abettarini/workbench/archivio/quadrotti-8x8/tavolo_tavole.pdf

Vista d'insieme | Tavolo da lavoro 2000×800 – tav. 1

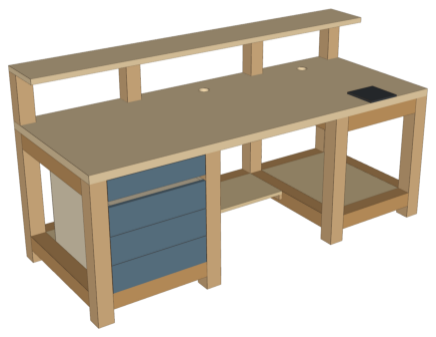
[picture p2: figure]

Quote in mm. Quadrotti abete 8×8 – verificare la sezione reale del piallato e rigenerare il modello se diversa.

Piano a 740 mm da terra (seduto, statura 174 cm) – lamellare abete 40 mm

8 gambe 8×8 – campate nette: cassetti 500 (sx) · seduta 700 · ricarica 480 (dx)

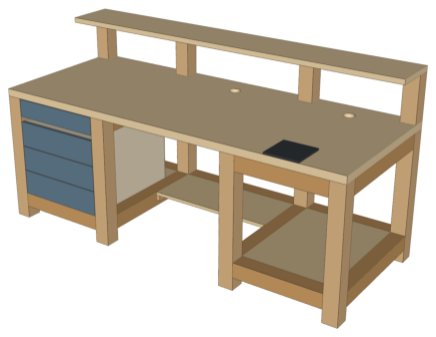
[picture p3: figure]

Ripiani bassi: cassetti e ricarica a tutta profondità, seduta solo posteriore (300 mm) per lasciare spazio ai piedi

Mensola rialzata 260×27 a +250 mm sul piano, montanti allineati alle gambe posteriori (barra filettata passante)
Zona ricarica: base per piastre intercambiabili (Rock Chucker / Dillon 550 / morsa) sul bordo anteriore, piano raddoppiato (+40 mm) e contropiastra in acciaio

Canaline passacavi sotto il bordo posteriore in ogni campata, fori Ø35 nelle traverse per il passaggio cavi, ciabatta nella campata seduta

Tavolo da fissare a muro (angolari su montanti mensola e traversa posteriore)

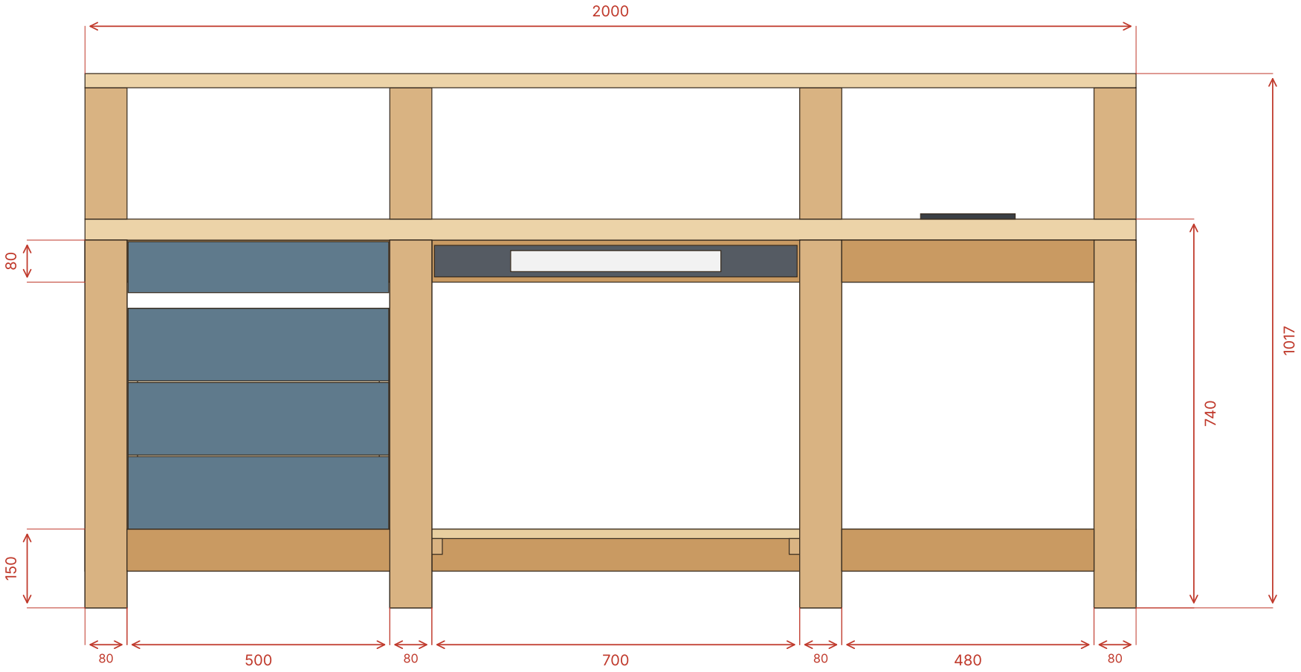
[picture p4: figure]

CASSETTI | SEDUTA | RICARICA
Prospetto frontale | Tavolo da lavoro 2000×800 – tav. 2

Pianta zona ricarica (dall'alto, fronte in alto)

Vista laterale da destra · pianta zona ricarica | Tavolo da lavoro 2000×800 – tav. 3

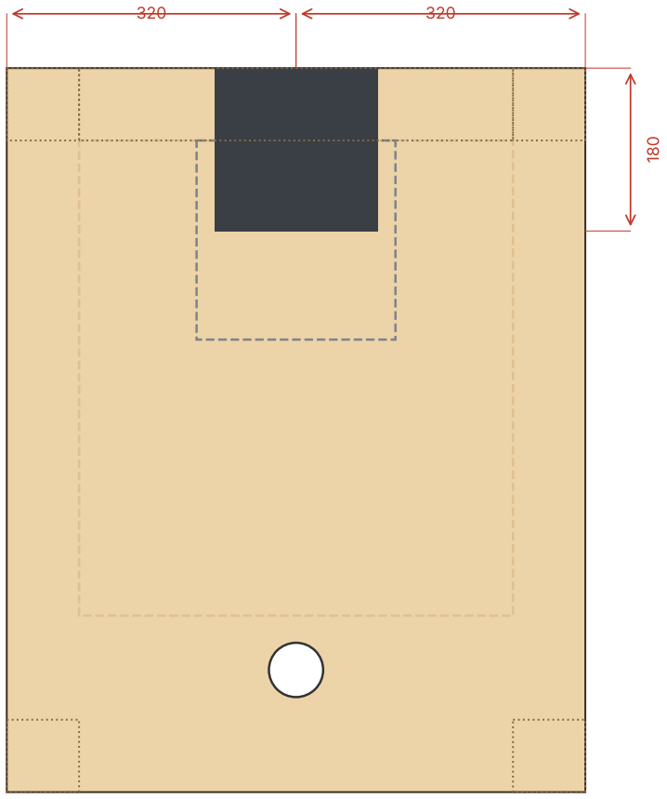
[picture p5: figure]

Pieno: base attacco piastre (sul piano, a filo del bordo anteriore)

Tratteggio: rinforzo 40 mm e contropiastra acciaio (sotto il piano)

Puntinato: gambe e traversa superiore anteriore (sotto il piano)

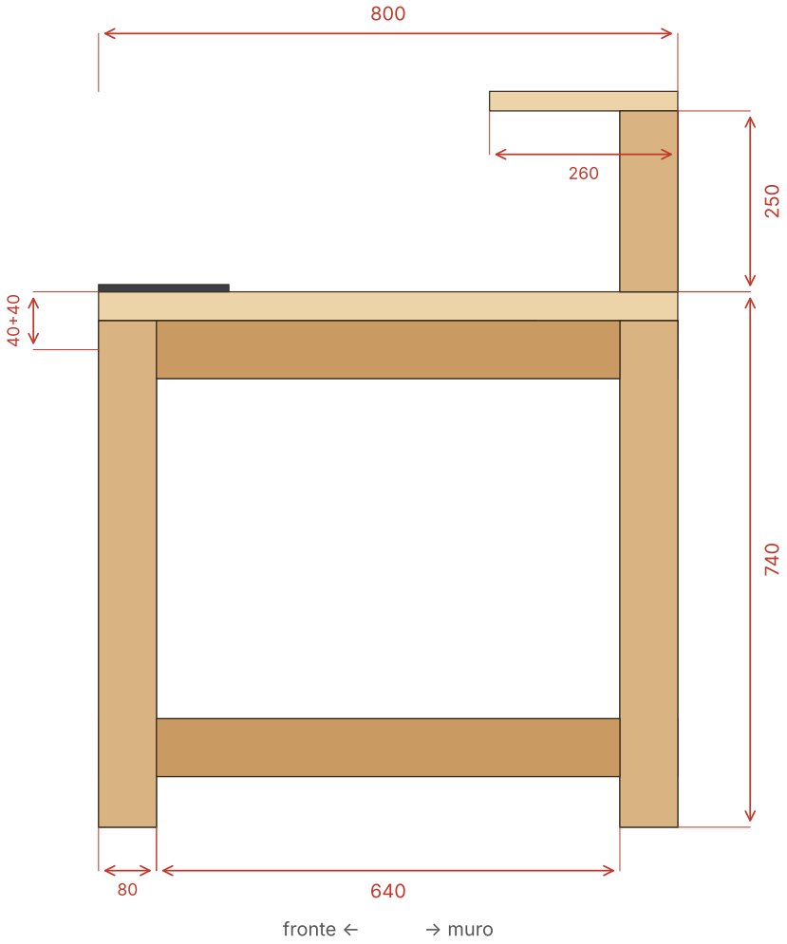
[picture p6: figure]
fronte ←; → muro

Pezzo | Lungh. | Q.tà | Tot. mm
Gamba | 700 | 8 | 5600
Traversa longitudinale | 700 | 2 | 1400
Traversa laterale (profondità) | 640 | 8 | 5120
Traversa longitudinale | 500 | 3 | 1500
Traversa longitudinale | 480 | 4 | 1920
Montante mensola | 250 | 4 | 1000
TOTALE | | 29 | 16540

### Ottimizzazione barre (taglio 5 mm incl. squadratura)

### Barre da 2 m: 9 pz (sfrido 1.46 m)

1: 700 + 700 + 500
2: 700 + 700 + 500
3: 700 + 700 + 500
4: 700 + 700 + 480
5: 700 + 700 + 480
6: 640 + 640 + 640
7: 640 + 640 + 640
8: 640 + 640 + 480
9: 480 + 250 + 250 + 250 + 250

### Barre da 3 m: 6 pz (sfrido 1.46 m)

1: 700 + 700 + 700 + 700
2: 700 + 700 + 700 + 700
3: 700 + 700 + 640 + 640 + 250
4: 640 + 640 + 640 + 640 + 250
5: 640 + 640 + 500 + 500 + 500
6: 480 + 480 + 480 + 480 + 250 + 250

### Barre da 4 m: 5 pz (sfrido 3.46 m)

1: 700 + 700 + 700 + 700 + 700 + 250
2: 700 + 700 + 700 + 700 + 700 + 250
3: 640 + 640 + 640 + 640 + 640 + 640
4: 640 + 640 + 500 + 500 + 500 + 480 + 480 5: 480 + 480 + 250 + 250
Distinta di taglio – quadrotti abete 8×8 | Tavolo da lavoro 2000×800 – tav. 4

Note
- Gambe: tutte uguali, piano appoggiato in testa. Traverse tra le gambe (luce netta = lunghezza).
- Ogni giunzione: 1 bullone M10 passante nella gamba + dado a tamburo nella traversa + 2 spine Ø10.

Dove due traverse entrano nella stessa gamba alla stessa quota, sfalsare i bulloni di ±18 mm in altezza.
- Traverse superiori laterali interne: foro Ø35 per il passaggio dei cavi lungo le canaline.
- Montanti mensola: foro passante Ø11 in asse per la barra filettata che scende nella gamba posteriore.

Pezzo | Materiale | Dimensioni (L×l) | Sp. | Q.tà
Cassetto cassettiera: fondo | HDF 4 | 500×435 | 4 | 3
Cassetto appeso: fondo | HDF 4 | 500×475 | 4 | 1
Cassettiera schienale | HDF 4 | 496×420 | 4 | 1
Listello reggiripiano | abete 20x30 | 640×30 | 20 | 4
Listello reggiripiano | abete 20x30 | 300×30 | 20 | 2
Mensola rialzata | lamellare abete 27 | 2000×260 | 27 | 1
Piano di lavoro | lamellare abete 40 | 2000×800 | 40 | 1
Rinforzo piano ricarica | lamellare abete 40 | 525×480 | 40 | 1
Cassetto cassettiera: fianco | multistrato 15 | 500×100 | 15 | 6
Cassetto appeso: fianco | multistrato 15 | 500×70 | 15 | 2
Cassetto appeso: testata | multistrato 15 | 445×70 | 15 | 2
Cassetto cassettiera: testata | multistrato 15 | 405×100 | 15 | 6
Ripiano basso post. seduta | multistrato 18 | 700×300 | 18 | 1
Ripiano basso cassetti | multistrato 18 | 640×500 | 18 | 1
Ripiano basso ricarica | multistrato 18 | 640×480 | 18 | 1
Cassettiera fianco sx | multistrato 18 | 582×420 | 18 | 1
Cassettiera fianco dx | multistrato 18 | 582×420 | 18 | 1
Cassettiera cielo | multistrato 18 | 582×460 | 18 | 1
Cassettiera fondo | multistrato 18 | 582×460 | 18 | 1
Frontale cassetto | multistrato 18 | 496×138 | 18 | 3
Frontale cassetto appeso | multistrato 18 | 496×97 | 18 | 1
Distinta pannelli e listelli | Tavolo da lavoro 2000×800 – tav. 5

Articolo | Q.tà | Uso
Bulloni M10×150 TE/TCEI + rondella + dado a tamburo M10 | 34 | giunzioni traverse-gambe (1 per estremità)
Spine in faggio Ø10×40 | 68 | 2 per giunzione, antirotazione (con colla)
Barra filettata M10, L≈417 mm + dado a tamburo + dado cieco + rondella | 4 | mensola → montante → piano → gamba posteriore
Inserti filettati M10 + piedini livellatori M10 | 8 | base gambe, compensano il pavimento
Squadrette/piastrine fissaggio piano + viti 4,5×30 | 16 | piano su traverse superiori
Viti 5×70 + colla vinilica D3 | 12 | rinforzo zona ricarica incollato e avvitato sotto il piano
Viti 4×50 | 24 | listelli reggiripiano
Contropiastra acciaio 220×220×6 (S235) | 1 | sotto il rinforzo, forata come la base attacco
Bulloni M10×120 TCEI + rondelle larghe + dadi autobloccanti | 4 | base attacco piastre (numero/foratura secondo il sistema)
Angolari rinforzati a L 100×100 + tasselli Ø10 adatti al muro | 4 | 2 su montanti mensola, 2 su traversa sup. posteriore
Guide a sfera estrazione totale L=500 (≥45 kg) | 4 | coppie: 3 cassettiera + 1 cassetto appeso
Maniglie / pomoli | 4
Passacavi Ø60 da incasso | 2 | piano, sopra le canaline
Canalina passacavi sottoscrivania (tagliata a misura) | 3 | 490 / 690 / 470 mm
Ciabatta con interruttore | 1 | nella canalina della campata seduta
Ferramenta e note zona ricarica | Tavolo da lavoro 2000×800 – tav. 6

Zona ricarica
- La base delle piastre va a filo del bordo anteriore, sopra la traversa superiore anteriore: la leva delle presse scende davanti al piano.
- Pacchetto serrato dai bulloni: base acciaio + piano 40 + rinforzo 40 + contropiastra 6 mm. Rinforzo incollato e avvitato al piano prima di forare.
- Foratura e dimensioni della base vanno adattate al sistema di piastre che usi già: nel modello è un segnaposto 180×180×10 mm.
- Uso da seduto a 74 cm: Rock Chucker e Dillon 550 direttamente sulla piastra, senza rialzo.
- Fissaggio a muro obbligatorio: le presse tendono a far ribaltare e 'camminare' il tavolo. Il ripiano basso della campata ricarica (componenti, piombo) fa anche da zavorra.
