abettarini/workbench/moduli/1-tavolo-base/tavolo_base_tavole.pdf

Vista d'insieme | Tavolo da lavoro 2000×800 – travi KVH 80×120 – tav. 1

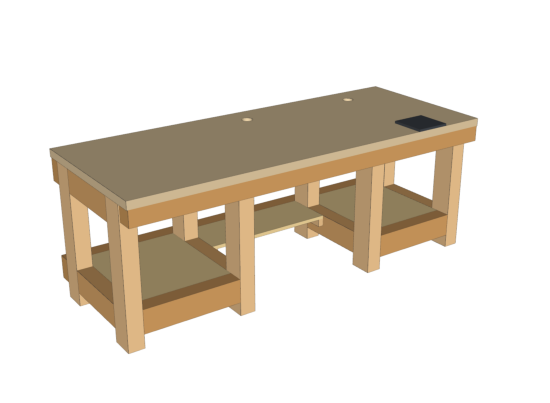
[picture p7: figure]

Quote in mm. KVH 80×120 abete C24 giuntato, piallato. Costi nel file tavolo_base_costi.xlsx.

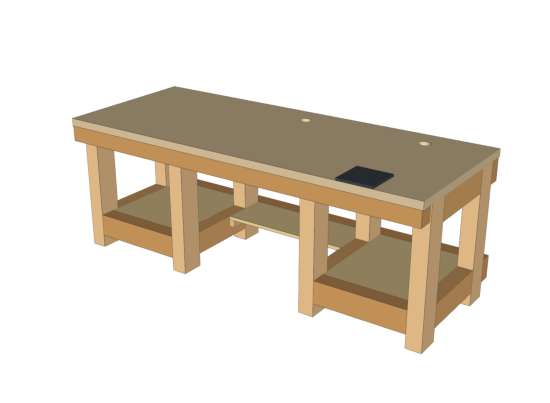
[picture p8: figure]

Telaio in travi KVH 80×120: 4 telai laterali (gamba ant. + gamba post. + traverse laterali alta e bassa) uniti da 3 fasce da 1990 Fasce: 2 posteriori di coltello (alta e bassa, contro il muro) e 1 anteriore alta in morale di abete 80×80 (620 mm liberi sotto)

Piano a 740 mm (seduto) – tavola lamellare abete 2000×800×40 intera · campate nette: cassetti 500 · seduta 700 · ricarica 480

Telai: bullone M10 + dado a tamburo + 2 spine Ø12 · fasce: 2 viti strutturali 8×160 per gamba, perpendicolari · ripiani e rinforzo in OSB/3 18

Telaio da 4 barre KVH da 4 m (24 pezzi, montanti dell'alzatina compresi). Fissaggio a muro obbligatorio per l'uso delle presse

Moduli separati: cassettiera (modulo 2) e alzatina con mensola (modulo 3), con i propri manuali e costi

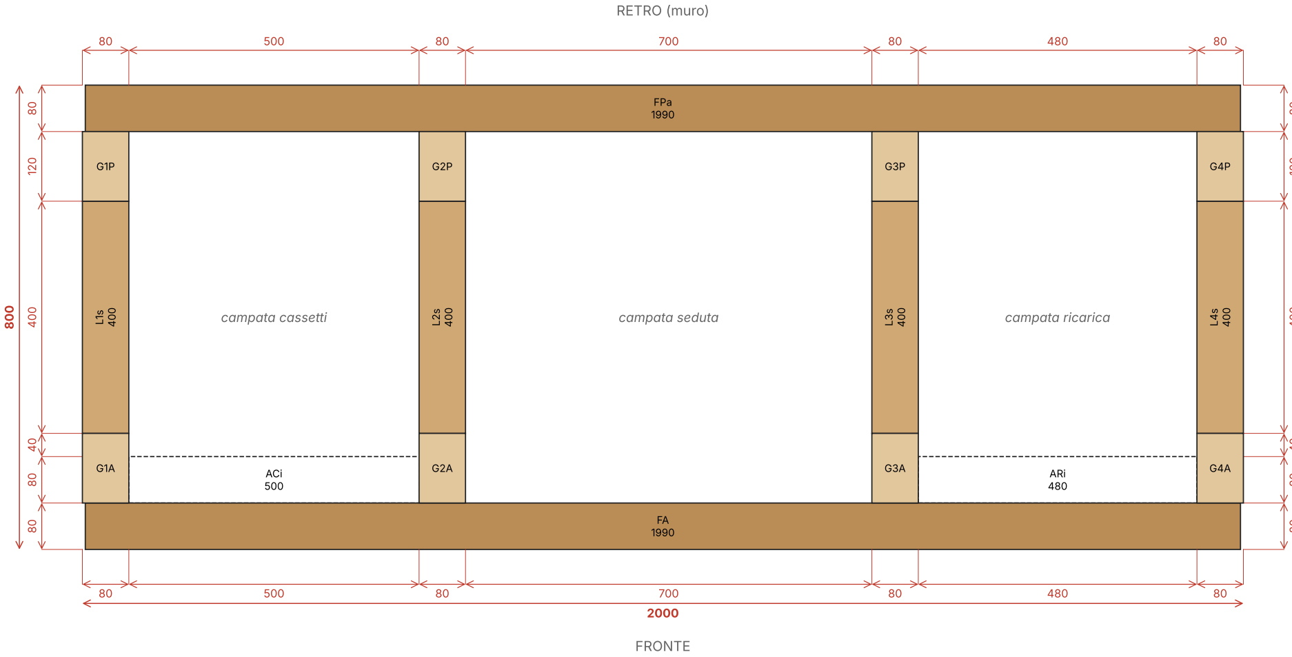
[picture p9: figure]
ACi 500; ARi 480; FPa 1990; FRONTE; RETRO (muro)

80 80 40 400 120 80

campata cassetti | campata seduta | campata ricarica
Pianta del telaio quotata (senza piano) | Tavolo da lavoro 2000×800 – travi KVH 80×120 – tav. 2

Pezzi alti pieni, pezzi solo bassi (ACi, ARi) tratteggiati. FA = fascia anteriore (morale 80×80), FPa/FPb = fasce posteriori alta e bassa (sovrapposte in pianta). Codice e lunghezza su ogni pezzo.

Prospetto anteriore quotato | Tavolo da lavoro 2000×800 – travi KVH 80×120 – tav. 3

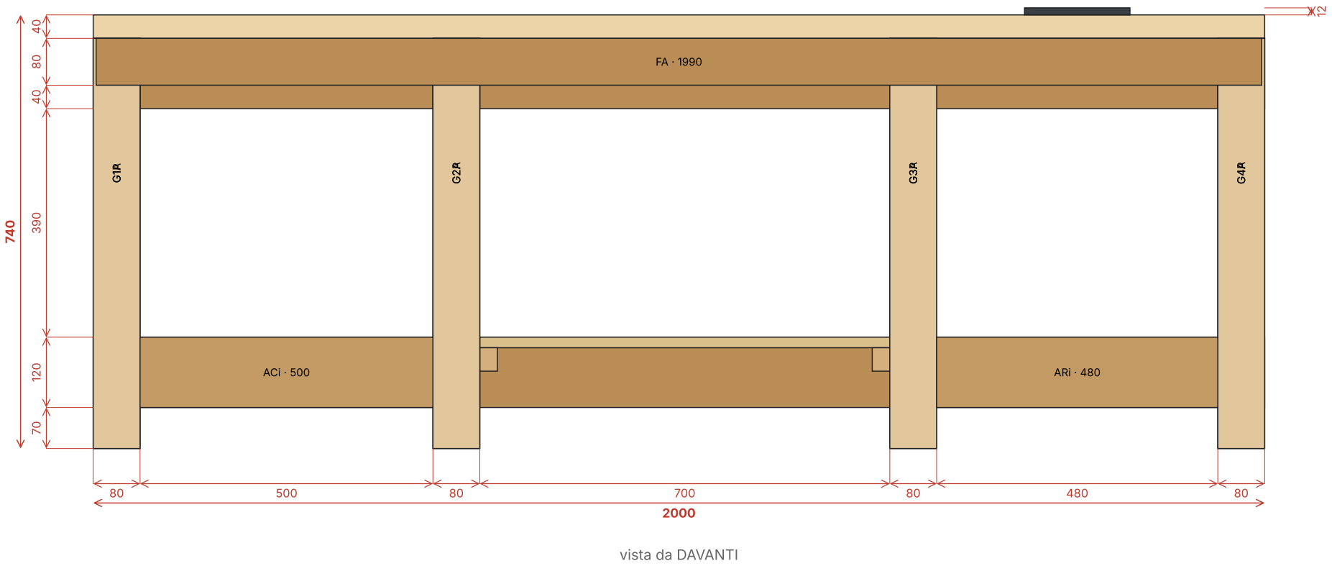
[picture p10: figure]
ACi · 500; ARi · 480; vista da DAVANTI

Prospetto posteriore quotato | Tavolo da lavoro 2000×800 – travi KVH 80×120 – tav. 4

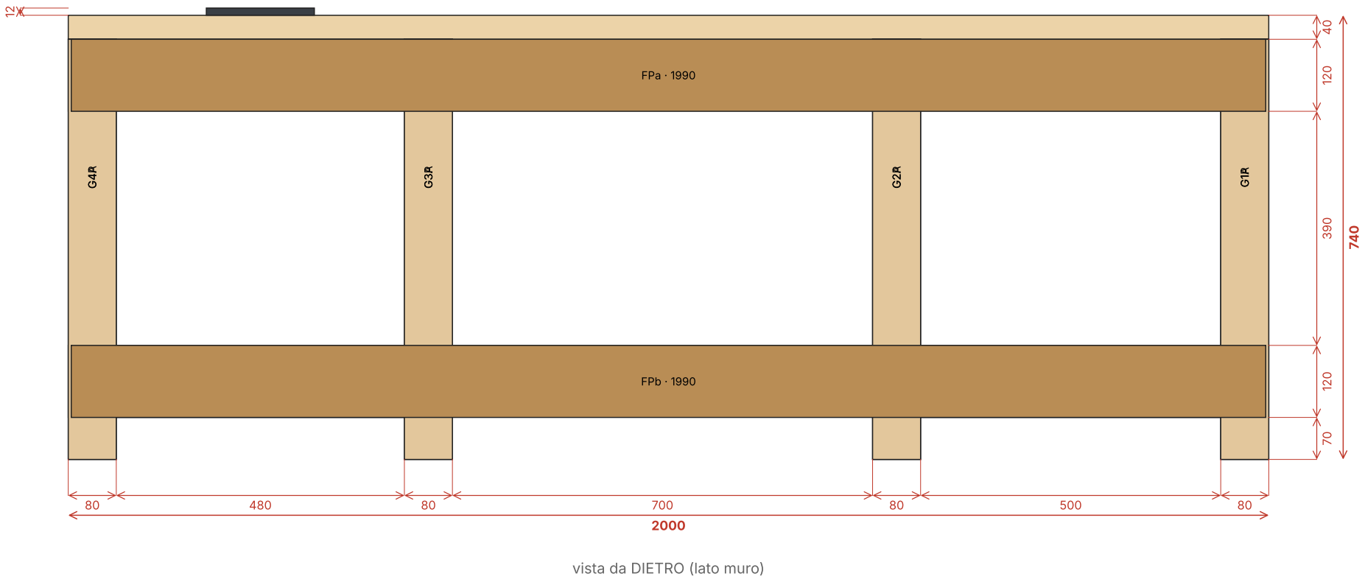
[picture p11: figure]
FPa · 1990; FPb · 1990; vista da DIETRO (lato muro)

Fianchi quotati | Tavolo da lavoro 2000×800 – travi KVH 80×120 – tav. 5

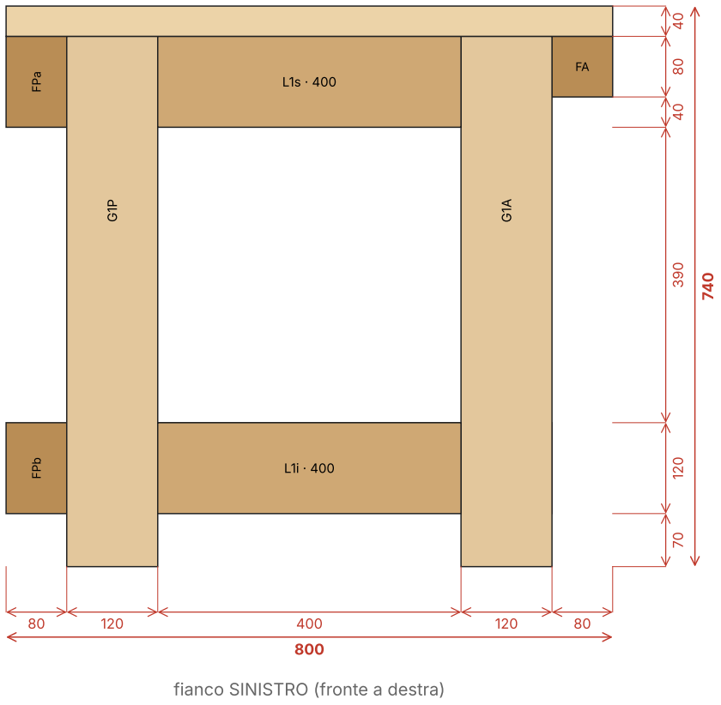
[picture p12: figure]
FPa FPb; fianco SINISTRO (fronte a destra)
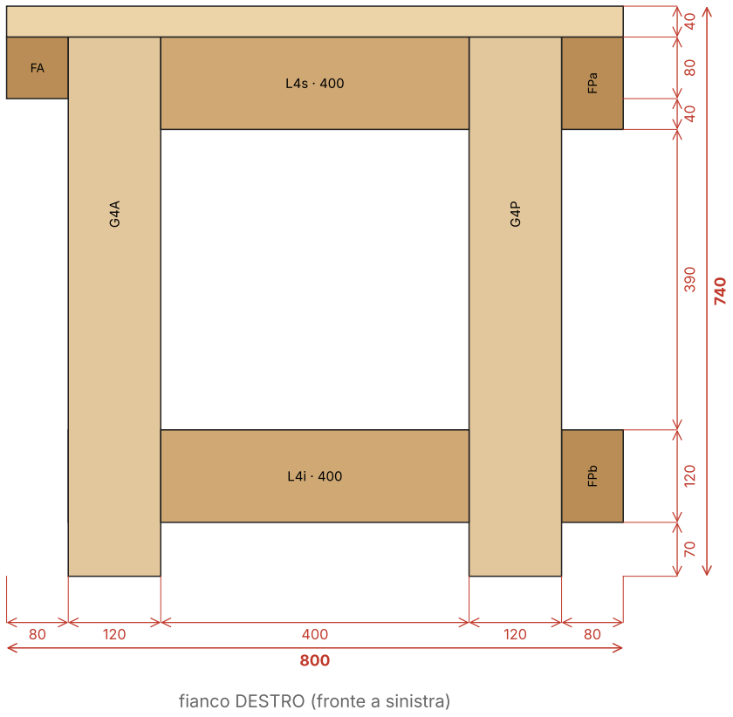
[picture p13: figure]
FPa FPb; fianco DESTRO (fronte a sinistra)
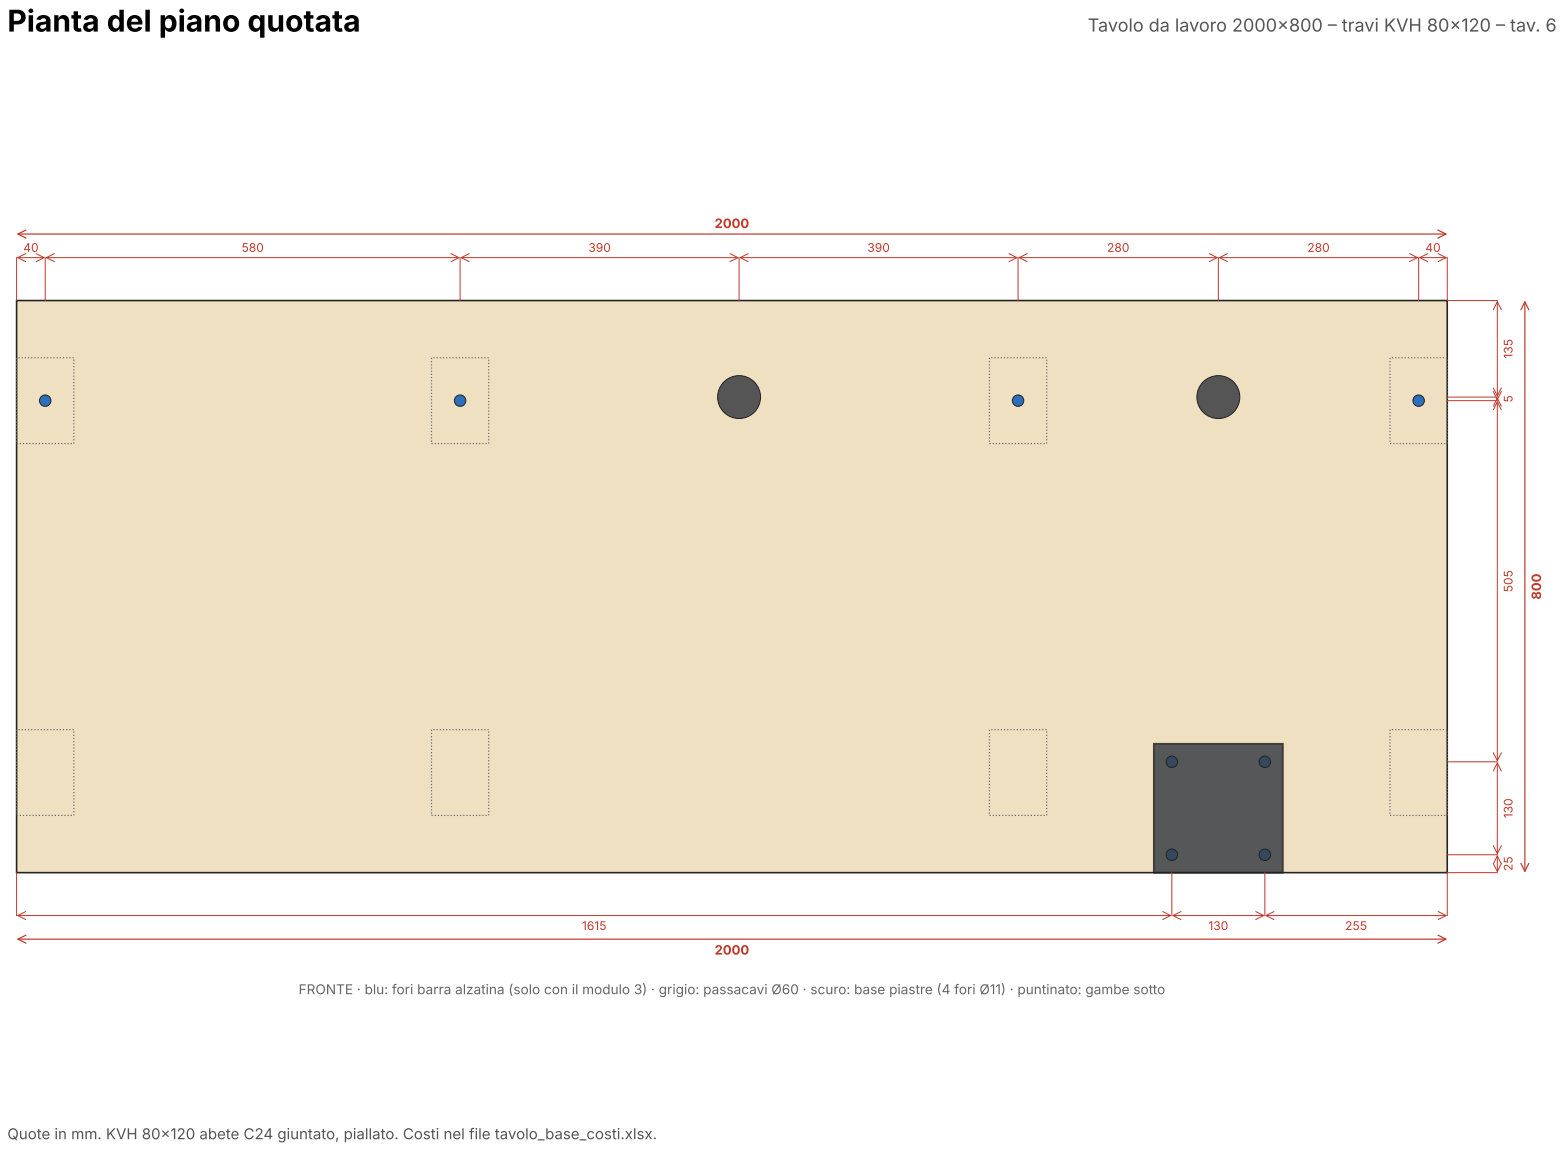
[picture p14: page 6]
Pianta del piano quotata; Tavolo da lavoro 2000×800 – travi KVH 80×120 – tav. 6

FRONTE · blu: fori barra alzatina (solo con il modulo 3) · grigio: passacavi Ø60 · scuro: base piastre (4 fori Ø11) · puntinato: gambe sotto

60 | 280 | 60
| 400

25 15 15 25

vista dall'alto (faccia sinistra in basso)

Laterale 400 mm – 6 pz: L1s, L1i, L2i, L3i, L4s, L4i

60 | 140 | 140 | 60

400

25 15 15 25

vista dall'alto (faccia sinistra in basso)

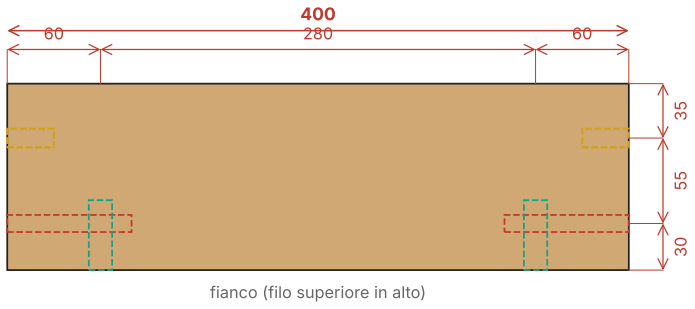
[picture p15: figure]
fianco (filo superiore in alto)

Laterale 400 mm – 2 pz: L2s, L3s

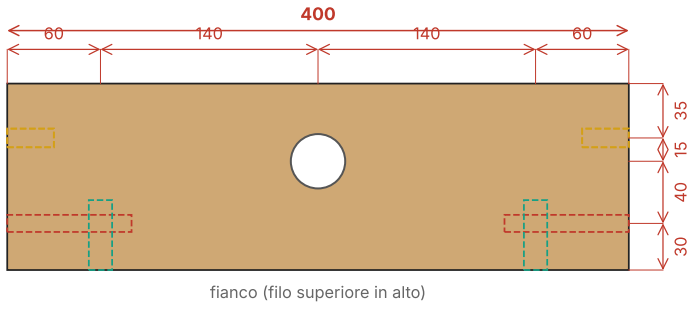
[picture p16: figure]
fianco (filo superiore in alto)

Bassa anteriore 500 mm – 1 pz: ACi

Traverse quotate: lunghezze e fori | Tavolo da lavoro 2000×800 – travi KVH 80×120 – tav. 7

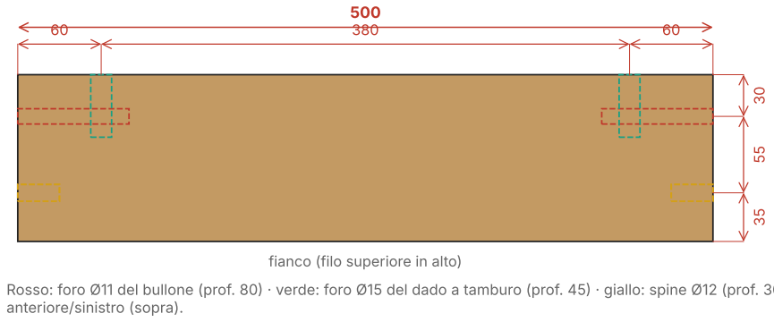
[picture p17: figure]
fianco (filo superiore in alto); anteriore/sinistro (sopra).
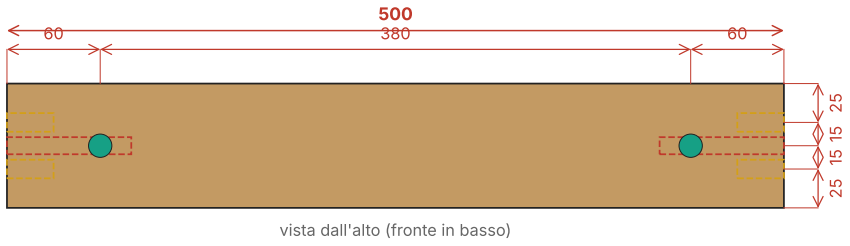
[picture p18: figure]
vista dall'alto (fronte in basso)

Rosso: foro Ø11 del bullone (prof. 80) · verde: foro Ø15 del dado a tamburo (prof. 45) · giallo: spine Ø12 (prof. 30) · grigio: passacavi Ø35 · blu scuro: fori Ø11 verticali della base piastre. Quote in mm dalla testata sinistra, dal basso (fianco) e dal lato

Bassa anteriore 480 mm – 1 pz: ARi

Traverse quotate: lunghezze e fori | Tavolo da lavoro 2000×800 – travi KVH 80×120 – tav. 8

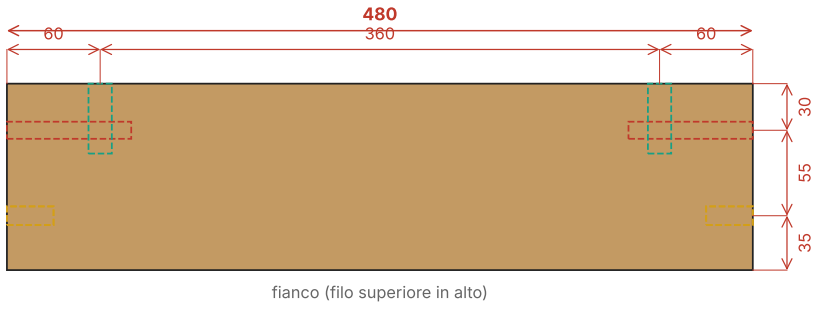
[picture p19: figure]
fianco (filo superiore in alto)
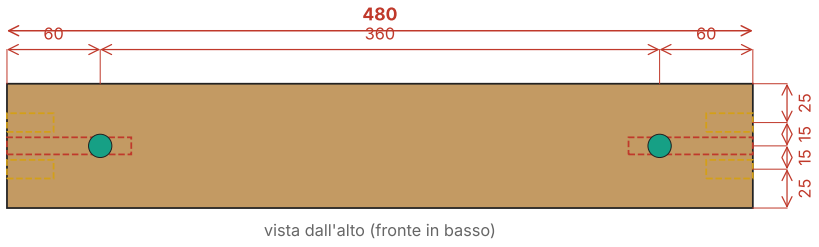
[picture p20: figure]
vista dall'alto (fronte in basso)

Rosso: foro Ø11 del bullone (prof. 80) · verde: foro Ø15 del dado a tamburo (prof. 45) · giallo: spine Ø12 (prof. 30) · grigio: passacavi Ø35 · blu scuro: fori Ø11 verticali della base piastre. Quote in mm dalla testata sinistra, dal basso (fianco) e dal lato anteriore/sinistro (sopra).

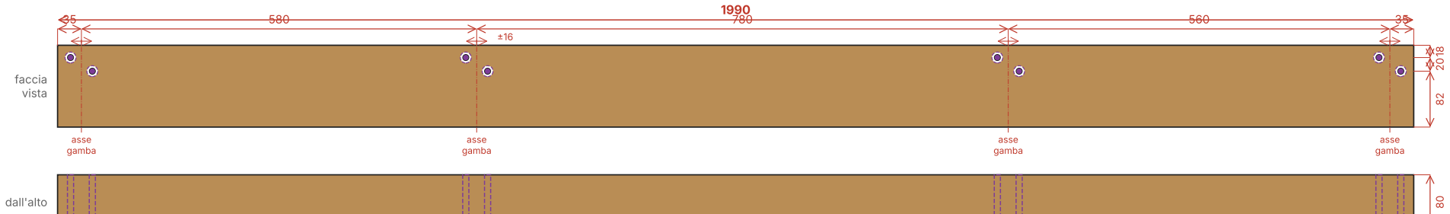
[picture p21: figure]
asse gamba; faccia vista; dall'alto

muro in alto · 1990 × 80 × 120

FPa · fascia posteriore alta – di coltello, 80 × 120

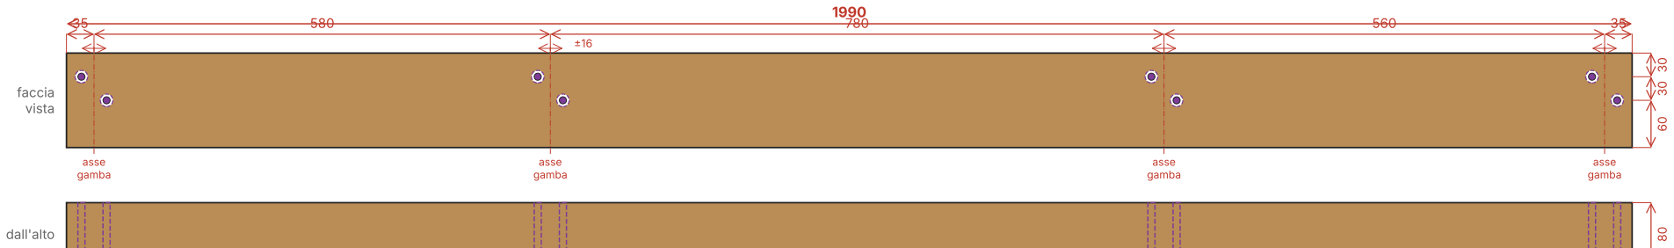
[picture p22: figure]
asse gamba; faccia vista; dall'alto

muro in alto · 1990 × 80 × 120

FPb · fascia posteriore bassa – di coltello, 80 × 120

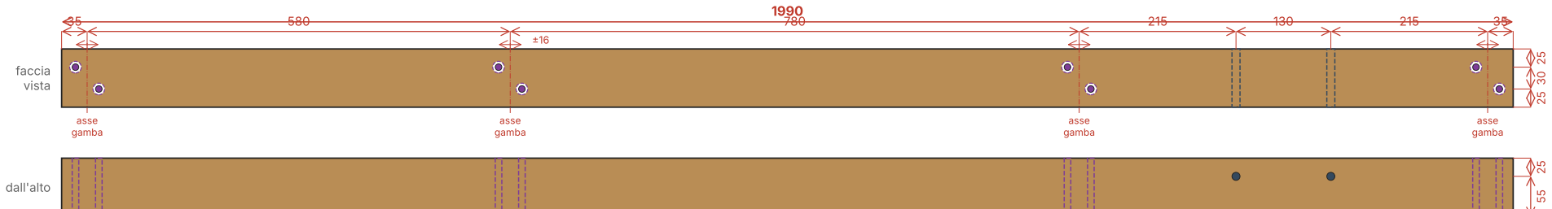
[picture p23: figure]
asse gamba; faccia vista; dall'alto

fronte in basso · 1990 × 80 × 80

FA · fascia anteriore – morale di abete 80 × 80

Fasce a tutta lunghezza: misure e fori | Tavolo da lavoro 2000×800 – travi KVH 80×120 – tav. 9

Viola: fori Ø9 passanti per le viti 8×160, con svasatura per la testa · blu scuro: 2 fori Ø11 verticali della base piastre (fase 8). In ogni asse gamba 2 fori a ±16 mm dall'asse, alle quote dal basso indicate a destra. Quote sempre dalla testata lato G1 (sinistra guardando il tavolo dal fronte): sulle fasce posteriori, che si forano dal lato muro, segna le quote dalla stessa testata.

Vista laterale da destra · dettaglio nodo gamba–traversa–fascia | Tavolo da lavoro 2000×800 – travi KVH 80×120 – tav. 10

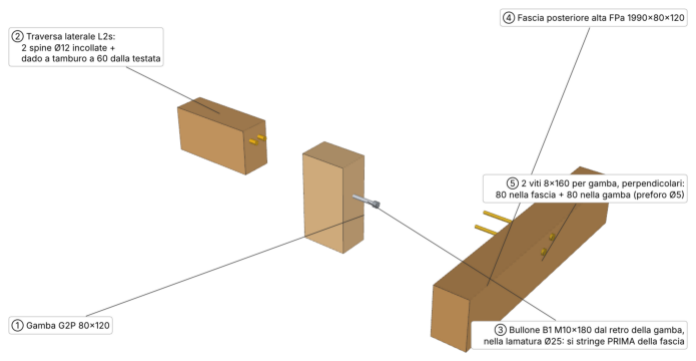
[picture p24: figure]

Telai: Ø11 passante nella gamba, Ø11 in asse nella testata della traversa (prof. 80), Ø15 per il dado a tamburo a 60 mm

dalla testata. Fasce: Ø9 passante nella fascia, preforo Ø5 prof. 80 nella gamba. Schemi di ogni pezzo nel manuale.

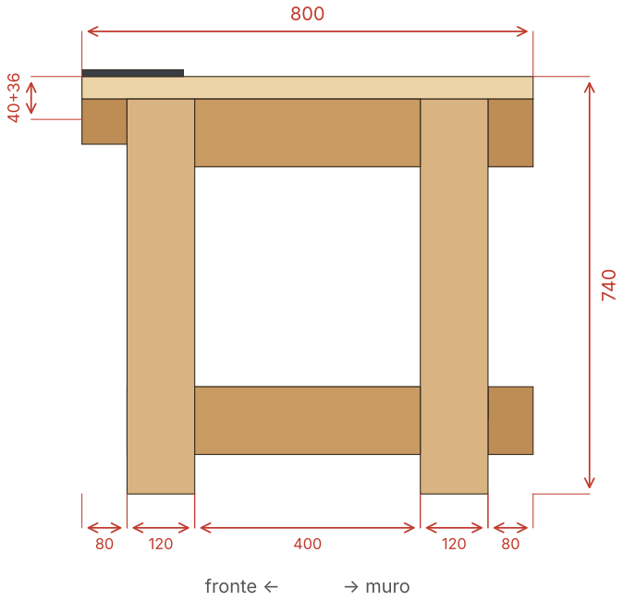
[picture p25: figure]
fronte ←; → muro

Pezzo | Lungh. | Q.tà | Tot. mm
Fascia (tutta lunghezza) | 1990 | 2 | 3980
Gamba | 700 | 8 | 5600
Traversa bassa anteriore | 500 | 1 | 500
Traversa bassa anteriore | 480 | 1 | 480
Traversa laterale (profondità) | 400 | 8 | 3200
Montante alzatina (conservare) | 250 | 4 | 1000
TOTALE | | 24 | 14760
Barra 1 | 1990 | 1990 | avanzo 2
Barra 2 | 700 | 700 | 700 | 700 | 400 | 400 | avanzo 366
Barra 3 | 700 | 700 | 700 | 700 | 400 | 400 | avanzo 366
Barra 4 | 500 | 480 | 400 | 400 | 400 | 400 | 250 | 250 | 250 | 250 | avanzo 370

Schema di taglio (barre da 4000 mm, taglio 4 mm, 10 mm di rifilatura in testa)

Travi KVH 80×120 – distinta e schema di taglio | Tavolo da lavoro 2000×800 – travi KVH 80×120 – tav. 11

Note
- Le 2 fasce posteriori da 1990 occupano la barra 1.
- La fascia anteriore si taglia dal morale 80×80×4000.
- Se il rivenditore taglia a misura, porta questa pagina.
- Poi i pezzi da 700 e controlla la squadra.
- Gambe e traverse laterali sono tutte uguali: tagliale con una battuta.
- I 4 pezzi da 250 sono i montanti dell'alzatina: conservali.

Pezzo | Materiale | Dimensioni | Sp. | Q.tà
Ripiano basso post. seduta | OSB/3 18 | 700×260 | 18 | 1
Ripiano basso cassetti | OSB/3 18 | 560×500 | 18 | 1
Ripiano basso ricarica | OSB/3 18 | 560×480 | 18 | 1
Rinforzo piano ricarica | OSB/3 18 ×2 incollati | 520×480 | 36 | 1
Listello reggiripiano | abete 30x40 | 560×40 | 30 | 4
Listello reggiripiano | abete 30x40 | 260×40 | 30 | 2
Piano di lavoro | lamellare abete 40 – pannello 1 | 2000×800 | 40 | 1
Ripiano cassetti 500×560 | Ripiano ricarica 480×560
Rinforzo A 480×520 | Rinforzo B 480×520

Ripiano seduta 700×260

avanzo

Pannello OSB/3 2500×1250×18

Pannelli, listelli e taglio del pannello OSB | Tavolo da lavoro 2000×800 – travi KVH 80×120 – tav. 12

Articolo | Q.tà | Uso
Vite M10×180 testa cilindrica + rondella (B1) | 16 | traverse laterali dei 4 telai
Vite M10×140 testa cilindrica (M10×180 accorciata) (B2) | 4 | traverse basse anteriori ACi e ARi
Dado a tamburo M10 (D) | 24 | 20 testate di traversa + 4 predisposizione alzatina
Spine in faggio Ø12×50 | 40 | 2 per testata, incollate nella traversa
Vite strutturale legno 8×160 (V) | 24 | fasce: 2 per gamba per fascia, preforo Ø5
Dado ragno M10 + piedino livellatore | 8 | base gambe
Squadrette fissaggio piano + viti 4,5×25 | 16 | piano su fasce e traverse laterali alte
Viti 5×60 + colla | 12 | rinforzo zona ricarica sotto il piano
Listello 30×40 + viti 5×70 | 6 pz | reggiripiano su gambe e traverse laterali basse
Kit attacco piastre (acciaio, viti M10 svasate, manopole M12) | 1 | vedi dettaglio piastre
Tasselli per telai Ø10 L 160 | 4 | fissaggio a muro attraverso la fascia posteriore alta
Canaline, passacavi Ø60, ciabatta | 3+2+1
Ferramenta e montaggio | Tavolo da lavoro 2000×800 – travi KVH 80×120 – tav. 13

Montaggio
1. Taglia i pezzi secondo lo schema; fora i nodi dei telai con la dima (gamba: Ø11 passante; traversa: Ø11 in testa + Ø15 verticale).
2. Monta i 4 telai laterali con spine incollate e bulloni B1; inserisci i dadi della predisposizione alzatina; controlla le diagonali.
3. Unisci i telai con le traverse basse anteriori ACi e ARi (bulloni B2), poi avvita le fasce FPb, FPa e FA (viti 8×160).
4. Avvita i listelli, posa i ripiani bassi; fissa il piano con le squadrette (asole per il movimento del legno).
5. Rinforzo ricarica incollato e avvitato sotto il piano, poi base piastre e contropiastra con le viti M10 passanti.
6. Piedini, fissaggio a muro, canaline e ciabatta. Moduli 2 e 3: vedi i loro manuali.
