abettarini/workbench/archivio/listelli-25x50/tavolo_listelli_tavole.pdf

Vista d'insieme | Tavolo da lavoro 2000×800 – listelli 25×50 laminati – tav. 1

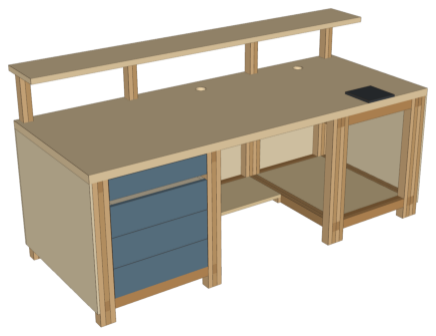
[picture p26: figure]
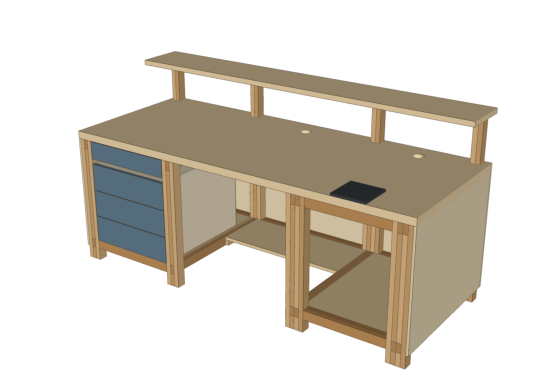
[picture p27: figure]

Quote in mm. Listelli nominali 25×50: misurare il piallato reale e rigenerare il modello (parametri t, w in tavolo_lam.py).

Telaio in listelli 25×50 incollati a strati: gambe 3 strati (75×50), 4 strati (100×50) nella zona ricarica; traverse 2 strati (50×50)

Incastri ricavati nella laminazione: lo strato centrale della gamba è interrotto e accoglie il tenone passante della traversa laterale (vedi tav. 3)

Pannelli di irrigidimento multistrato 12 mm su retro e fianchi, incollati e avvitati: danno la rigidezza che la sezione ridotta non ha

Piano a 740 mm (seduto) – lamellare abete 40 mm · campate nette: cassetti 500 · seduta 680 · ricarica 446

Zona ricarica: piano raddoppiato +40 mm, contropiastra acciaio, base per piastre intercambiabili (Rock Chucker / Dillon 550 / morsa)

Mensola rialzata su montanti a 2 strati sopra le gambe posteriori · canaline passacavi e ciabatta · fissaggio a muro obbligatorio

Prospetto frontale | Tavolo da lavoro 2000×800 – listelli 25×50 laminati – tav. 2

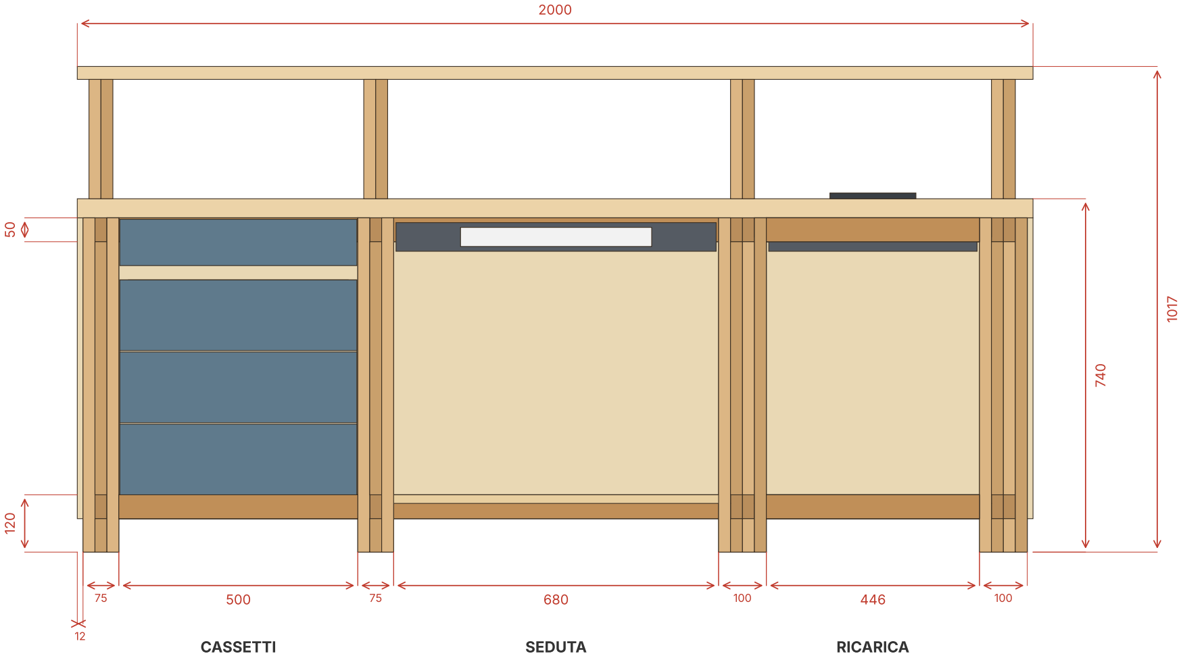
[picture p28: figure]
CASSETTI; SEDUTA; RICARICA

Vista laterale da destra (senza pannello) · dettaglio incastro | Tavolo da lavoro 2000×800 – listelli 25×50 laminati – tav. 3

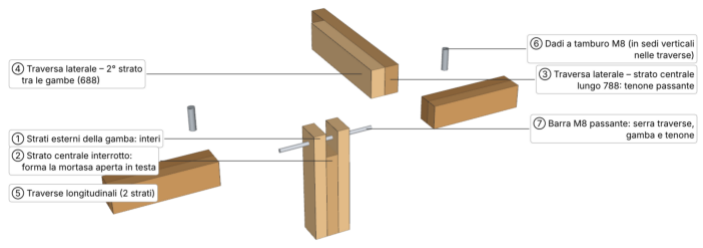
[picture p29: figure]

Lo strato centrale della gamba si interrompe alle quote delle traverse laterali: la mortasa nasce già in laminazione.

Il tenone passante si incastra dall'alto, si incolla e si blocca con 2 spine; la barra M8 delle traverse

longitudinali lo attraversa e chiude il nodo.

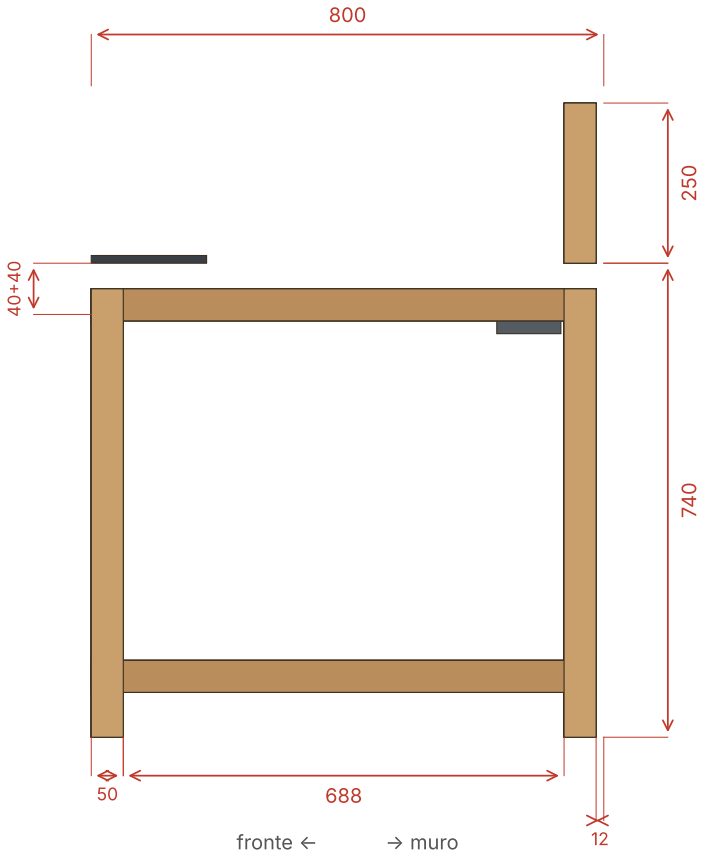
[picture p30: figure]
fronte ←; → muro

Pezzo | Lungh. | Q.tà | Tot. mm
Gamba – strato intero | 700 | 16 | 11200
Gamba – spezzone strato centrale | 530 | 12 | 6360
Gamba – spezzone strato centrale | 70 | 12 | 840
Traversa laterale – strato tenone (passante) | 788 | 12 | 9456
Traversa laterale – 2° strato (tra le gambe) | 688 | 4 | 2752
Traversa longitudinale – strato | 680 | 4 | 2720
Traversa longitudinale – strato | 500 | 6 | 3000
Traversa longitudinale – strato | 446 | 8 | 3568
Montante mensola – strato | 250 | 8 | 2000
TOTALE | | 82 | 41896

Ottimizzazione barre (taglio 4 mm)

Barre da 2.0 m: 22 pz (sfrido 2.1 m)

Barre da 2.4 m: 18 pz (sfrido 1.3 m) 1: 788+788+788
2: 788+788+788
3: 788+788+788
4: 788+788+788
5: 700+700+700+250
6: 700+700+700+250
7: 700+700+700+250
8: 700+700+700+250
9: 700+700+700+250
10: 700+688+688+250
11: 688+688+680+250+70
12: 680+680+680+250+70
13: 530+530+530+530+70+70+70 14: 530+530+530+530+70+70+70 15: 530+530+530+530+70+70+70 16: 500+500+500+500+70
17: 500+500+446+446+446
18: 446+446+446+446+446

Barre da 3.0 m: 15 pz (sfrido 3.1 m) 1: 788+788+788+530+70
2: 788+788+788+530+70
3: 788+788+788+530+70
4: 788+788+788+530+70
5: 700+700+700+700+70+70
6: 700+700+700+700+70+70
7: 700+700+700+700+70+70
8: 700+700+700+700+70+70
9: 688+688+688+688
10: 680+680+680+680+250
11: 530+530+530+530+530+250 12: 530+530+530+500+500+250 13: 500+500+500+500+446+446
14: 446+446+446+446+446+446+250 15: 250+250+250+250

Barre da 4.0 m: 11 pz (sfrido 2.1 m)

Distinta di taglio – listelli 25×50 | Tavolo da lavoro 2000×800 – listelli 25×50 laminati – tav. 4

Note di laminazione
- Scegliere listelli dritti e senza nodi passanti; incollare a piena faccia con D3 e serrare (morsetti o viti).
- Gambe: incollare gli strati esterni sugli spezzoni centrali usando un ritaglio di listello come distanziale nelle mortase,

così la luce viene esatta; togliere il distanziale prima che la colla tiri.
- Dopo l'incollaggio, rifilare e squadrare le testate; forare per barre e spine a colla indurita.
- Totale: 82 pezzi, 41.9 m di listello (più sfrido).

Pezzo | Materiale | Dimensioni | Sp. | Q.tà
Cassetto cassettiera: fondo | HDF 4 | 500×435 | 4 | 3
Cassetto appeso: fondo | HDF 4 | 500×475 | 4 | 1
Cassettiera schienale | HDF 4 | 496×450 | 4 | 1
Listello reggiripiano | abete 20x30 | 688×30 | 20 | 4
Listello reggiripiano | abete 20x30 | 300×30 | 20 | 2
Mensola rialzata | lamellare abete 27 | 2000×260 | 27 | 1
Piano di lavoro | lamellare abete 40 | 2000×800 | 40 | 1
Rinforzo piano ricarica | lamellare abete 40 | 570×496 | 40 | 1
Pannello posteriore | multistrato 12 | 2000×630 | 12 | 1
Pannello irrigidimento fianco | multistrato 12 | 788×630 | 12 | 2
Cassetto cassettiera: fianco | multistrato 15 | 500×100 | 15 | 6
Cassetto appeso: fianco | multistrato 15 | 500×70 | 15 | 2
Cassetto appeso: testata | multistrato 15 | 445×70 | 15 | 2
Cassetto cassettiera: testata | multistrato 15 | 405×100 | 15 | 6
Ripiano basso post. seduta | multistrato 18 | 730×300 | 18 | 1
Ripiano basso cassetti | multistrato 18 | 688×500 | 18 | 1
Ripiano basso ricarica | multistrato 18 | 688×496 | 18 | 1
Cassettiera fianco sx | multistrato 18 | 582×450 | 18 | 1
Cassettiera fianco dx | multistrato 18 | 582×450 | 18 | 1
Cassettiera cielo | multistrato 18 | 582×460 | 18 | 1
Cassettiera fondo | multistrato 18 | 582×460 | 18 | 1
Frontale cassetto | multistrato 18 | 496×148 | 18 | 3
Frontale cassetto appeso | multistrato 18 | 496×97 | 18 | 1
Distinta pannelli e listelli reggiripiano | Tavolo da lavoro 2000×800 – listelli 25×50 laminati – tav. 5

Articolo | Q.tà | Uso
Colla vinilica D3 (laminazione + incastri) | 2–3 kg | incollare tutti gli strati a piena faccia
Viti 4×50 per serraggio strati (oppure morsetti) | ~250 | ogni 15 cm, sfalsate; evitare le zone da forare
Dadi a tamburo M8 | 18 | uno per estremità di traversa longitudinale
Barra filettata M8 (passante nelle gambe centrali) | 4 | L≈245 (gamba 2) e 270 (gamba 3) – unisce le traverse dei due lati
Viti TCEI M8×150 / M8×180 + rondella | 10 | estremità singole; testa incassata sotto i pannelli
Spine in faggio Ø10 | 32 | 2 per tenone passante, trasversali alla gamba, incollate
Pannelli: viti 3,5×30 + colla | ~150 | ogni 15 cm su gambe e traverse
Barra filettata M10 L≈400 + dado a tamburo + dado cieco | 4 | mensola → montante → piano → gamba post.
Inserti filettati M10 + piedini livellatori | 8 | base gambe
Squadrette fissaggio piano + viti 4,5×30 | 16
Viti 5×70 + colla | 12 | rinforzo zona ricarica sotto il piano
Viti 4×50 | 24 | listelli reggiripiano
Contropiastra acciaio 220×220×6 + 4 viti TSPEI M10×110 + dadi autobloccanti | 1 kit | attacco piastre (vedi dettaglio)
Angolari a L 100×100 + tasselli Ø10 | 4 | fissaggio a muro (montanti mensola)
Guide a sfera estrazione totale L=500 | 4 cp | 3 cassettiera + 1 appeso
Maniglie | 4
Passacavi Ø60 | 3 | 2 nel piano, 1 nel pannello posteriore
Canalina sottoscrivania a misura | 3 | 490 / 670 / 436 mm
Ciabatta con interruttore | 1 | canalina campata seduta
Ferramenta e note | Tavolo da lavoro 2000×800 – listelli 25×50 laminati – tav. 6

Sequenza di montaggio consigliata

1. Laminare gambe, traverse e montanti; a colla indurita rifilare e forare.
2. Montare i telai laterali (gamba ant. + gamba post. + traverse laterali): tenone dall'alto, colla, spine.
3. Collegare i telai con le traverse longitudinali (barre M8 e dadi a tamburo), verificare la squadra sulle diagonali.
4. Incollare e avvitare i pannelli di irrigidimento: da qui il telaio non si deforma più.
5. Piano, rinforzo e attacco ricarica; mensola con barre M10; fissaggio a muro; cassettiera e canaline.
