abettarini/workbench/archivio/listelli-25x50/lam_dettaglio_incastro.png

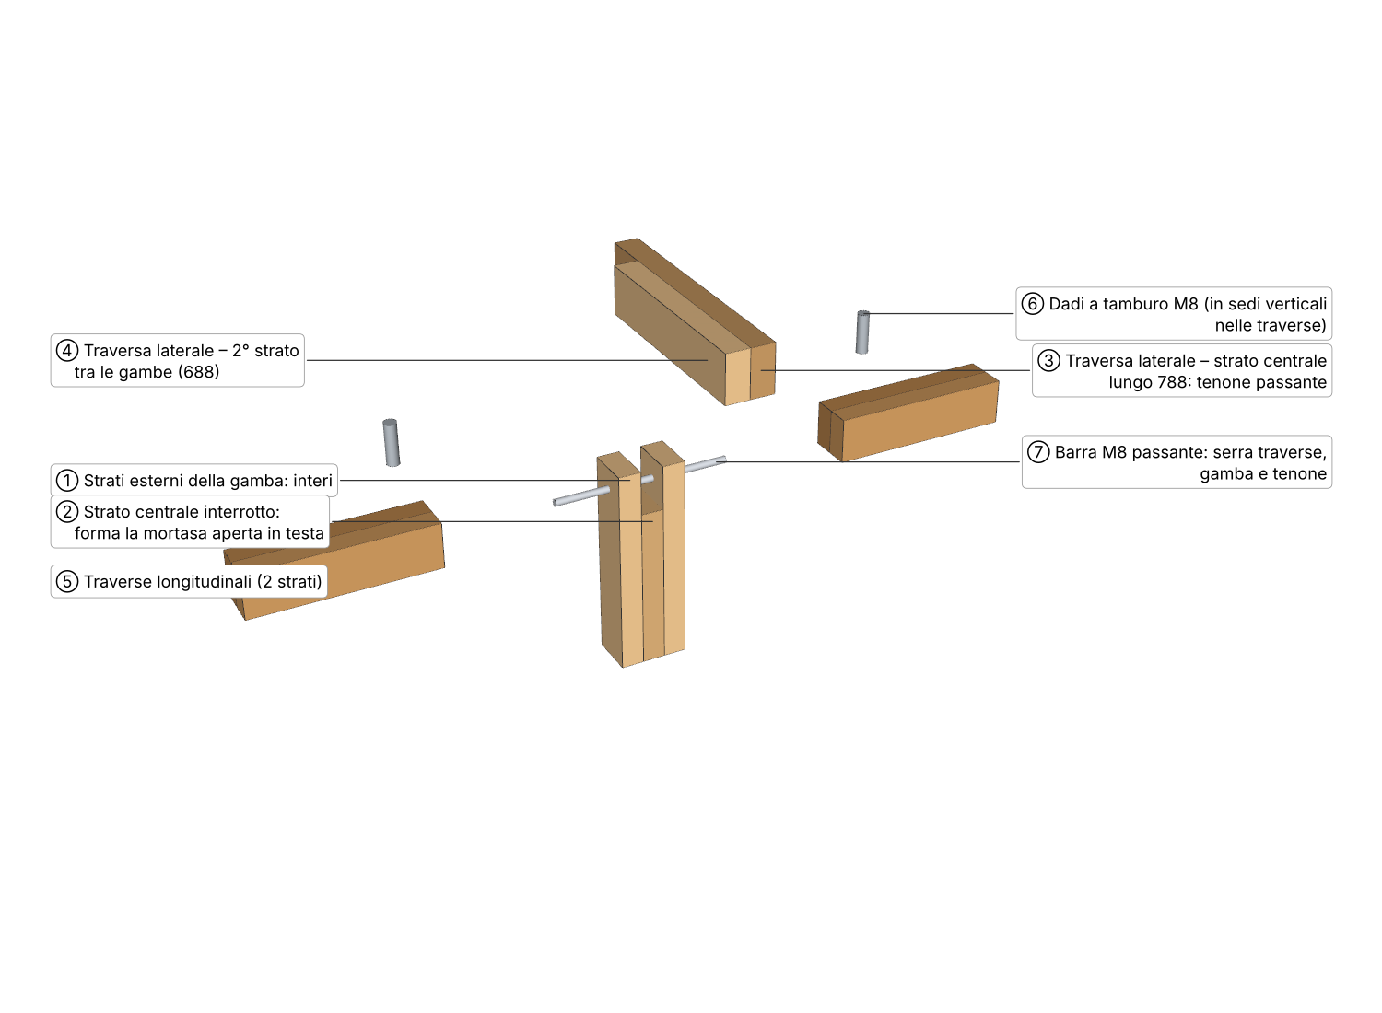
archivio/listelli-25x50/lam_dettaglio_incastro.png
