abettarini/workbench/archivio/quadrotti-8x8/vista_frontale_sx.png

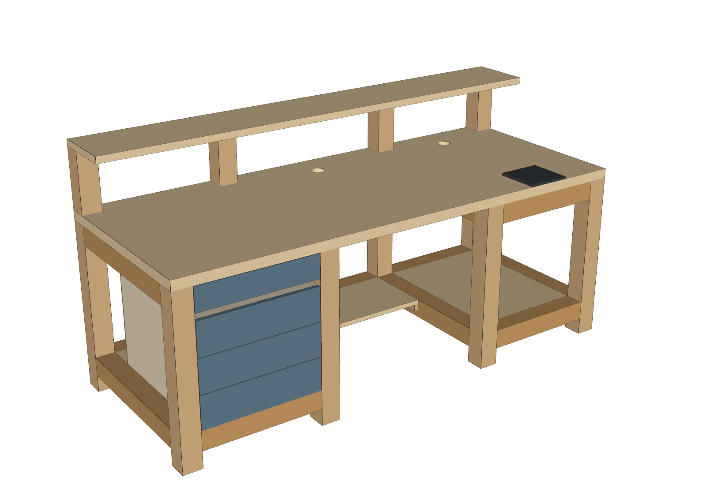
archivio/quadrotti-8x8/vista_frontale_sx.png
