abettarini/workbench/moduli/1-tavolo-base/immagini/kvh_dettaglio_nodo.png

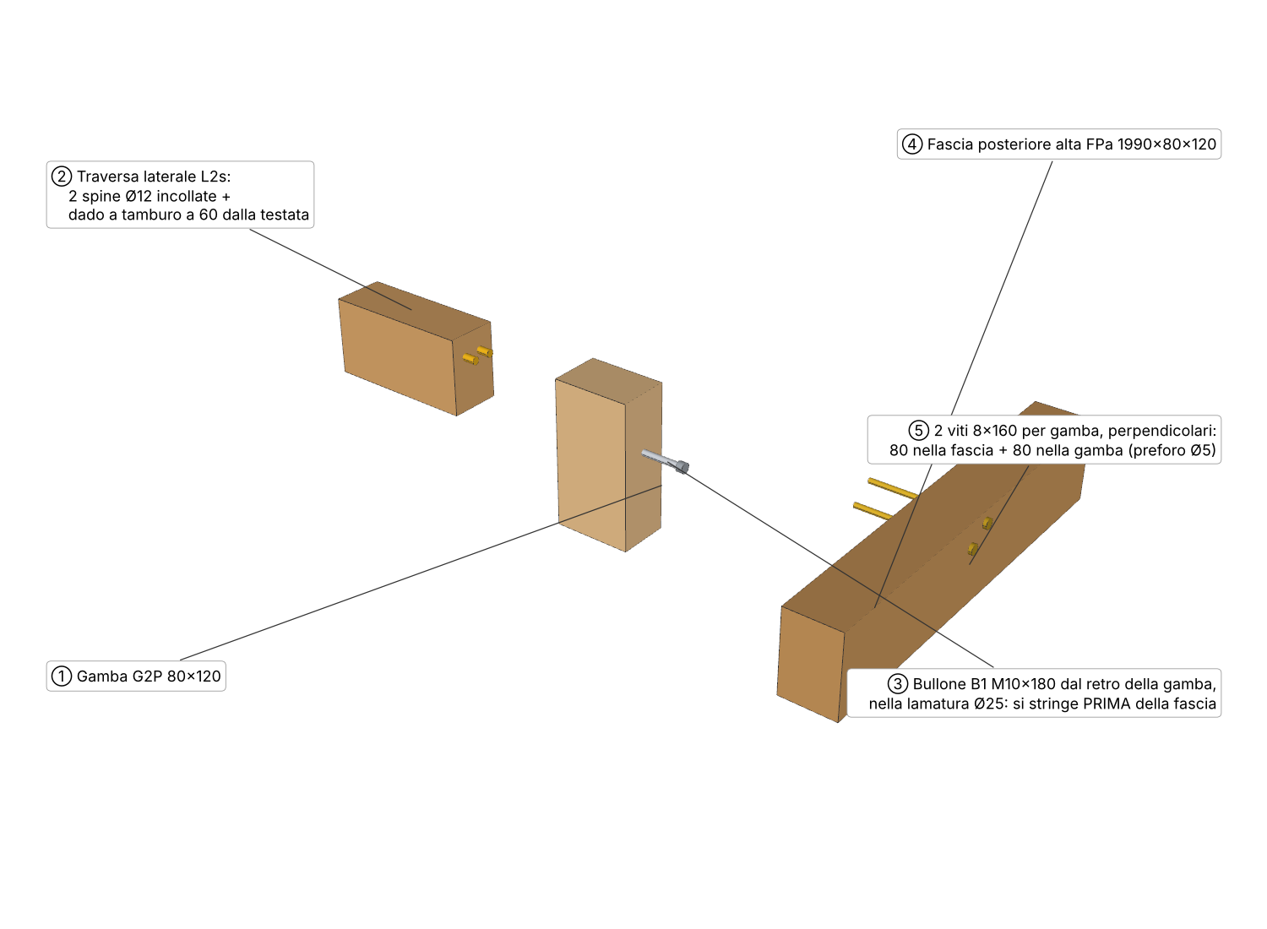
moduli/1-tavolo-base/immagini/kvh_dettaglio_nodo.png
