abettarini/workbench/moduli/1-tavolo-base/immagini/man_f4_telai.png

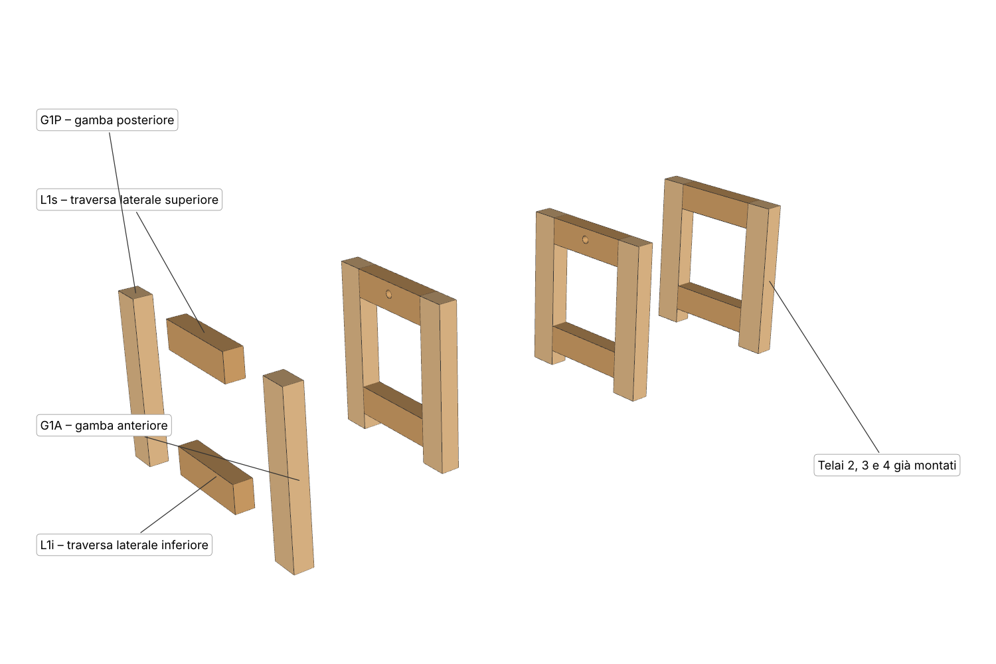
moduli/1-tavolo-base/immagini/man_f4_telai.png
