abettarini/workbench/moduli/1-tavolo-base/immagini/man_f5_collegamento.png

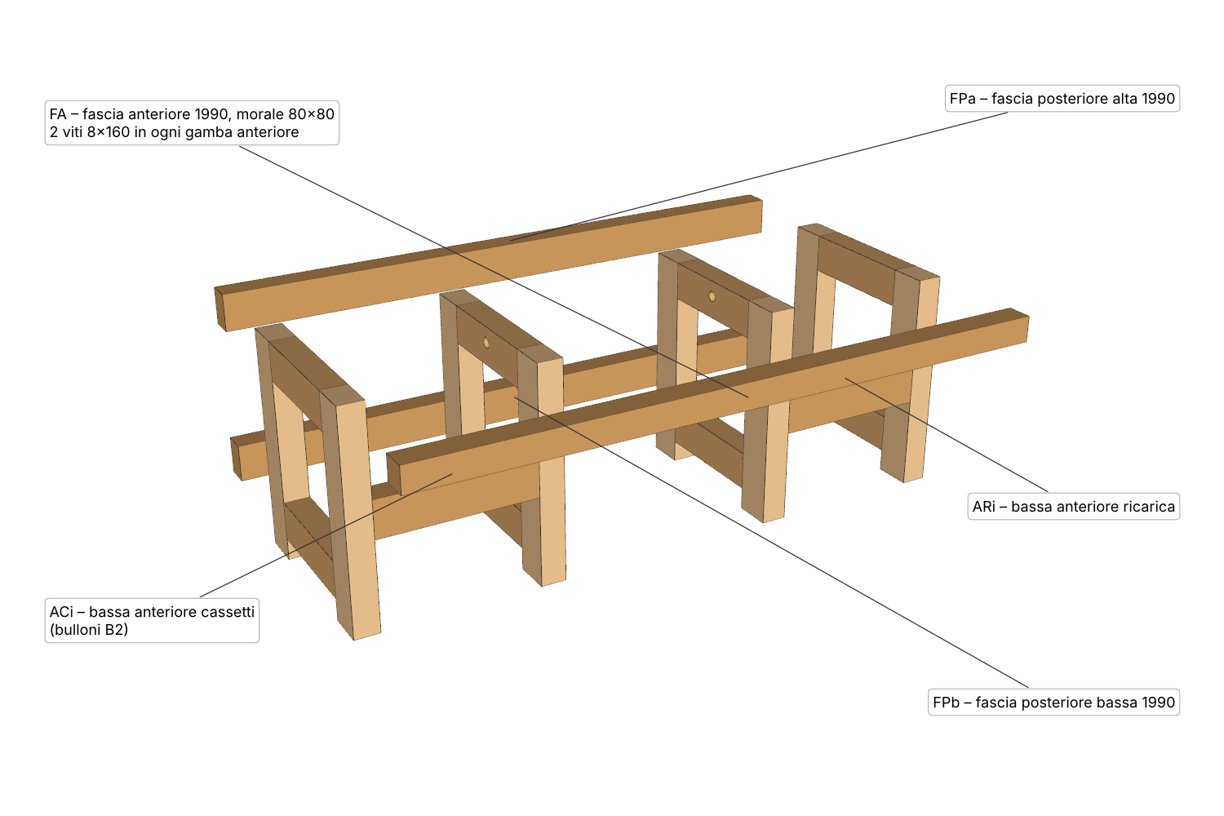
moduli/1-tavolo-base/immagini/man_f5_collegamento.png
