abettarini/workbench/moduli/1-tavolo-base/immagini/man_f6_ripiani.png

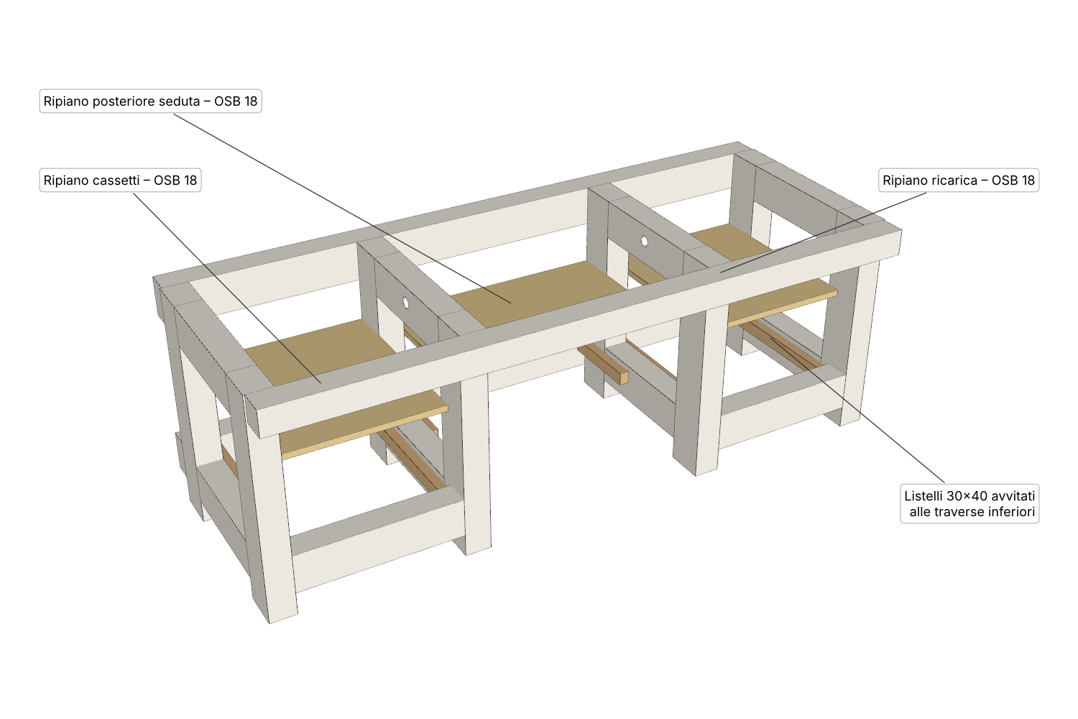
moduli/1-tavolo-base/immagini/man_f6_ripiani.png
