abettarini/workbench/moduli/1-tavolo-base/immagini/man_f7_piano.png

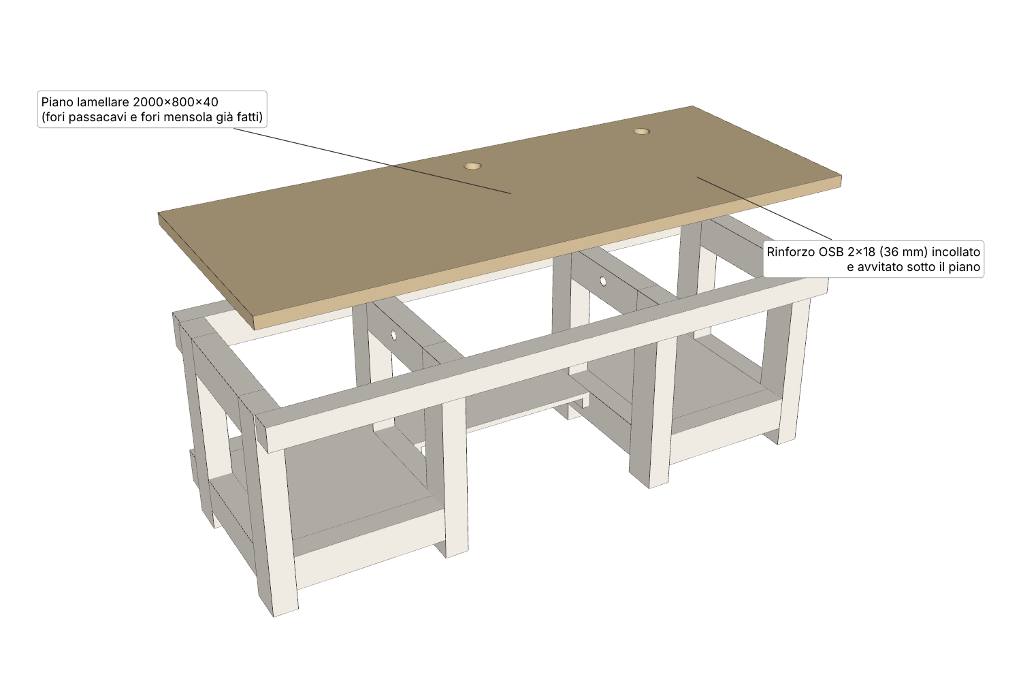
moduli/1-tavolo-base/immagini/man_f7_piano.png
