abettarini/workbench/moduli/1-tavolo-base/immagini/man_f8_ricarica.png

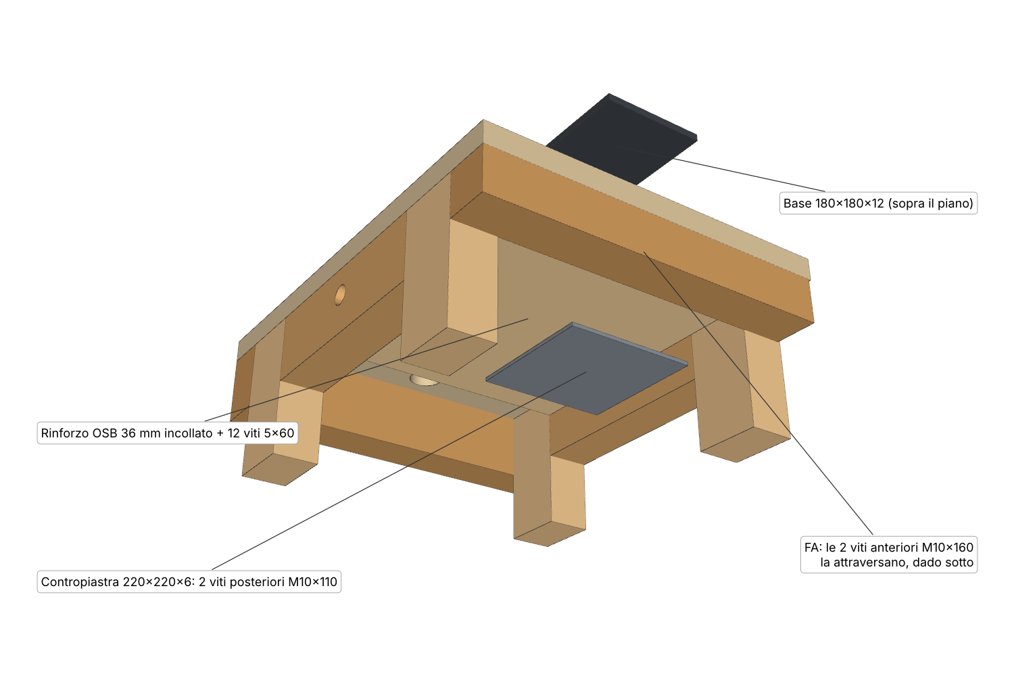
moduli/1-tavolo-base/immagini/man_f8_ricarica.png
