abettarini/workbench/moduli/1-tavolo-base/immagini/man_f9_base.png

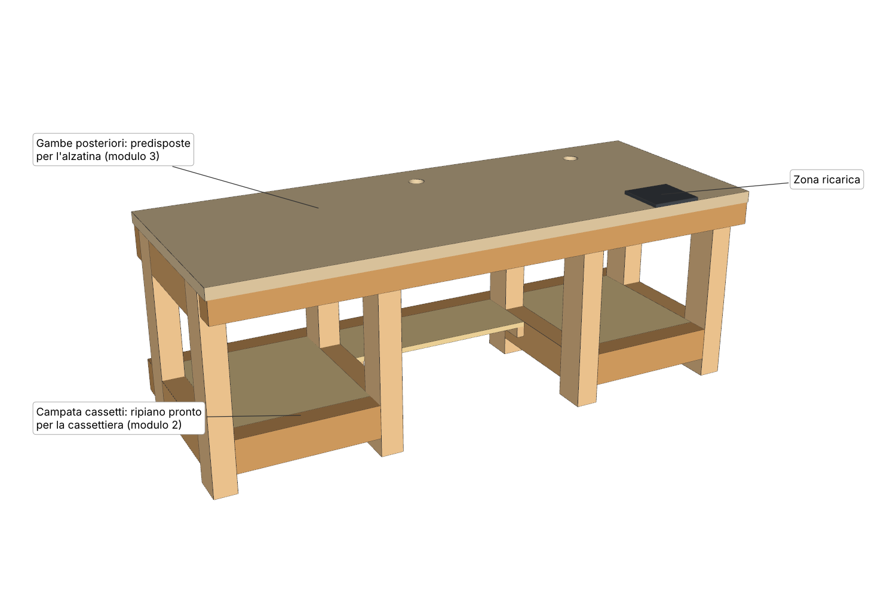
moduli/1-tavolo-base/immagini/man_f9_base.png
