abettarini/workbench/moduli/1-tavolo-base/immagini/piastre_esploso.png

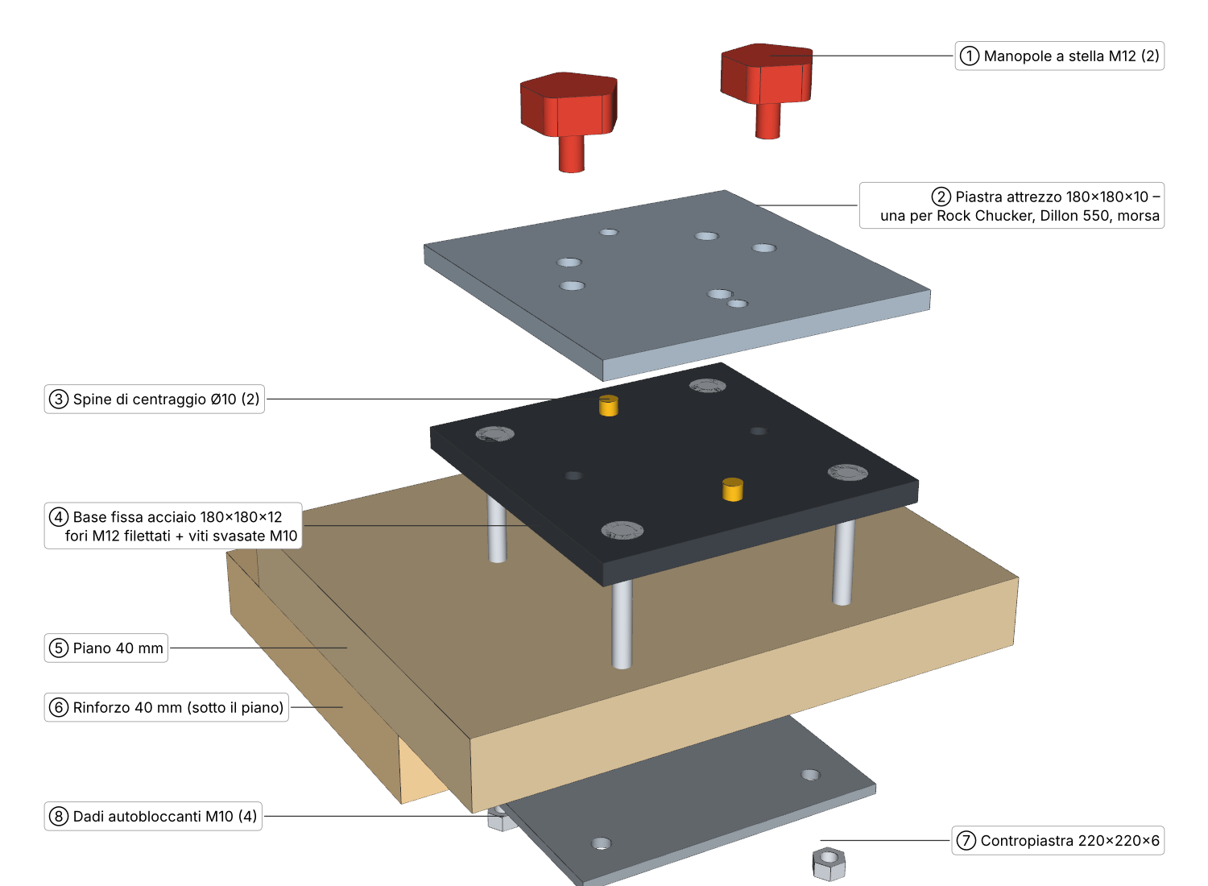
moduli/1-tavolo-base/immagini/piastre_esploso.png
