abettarini/workbench/moduli/1-tavolo-base/immagini/piastre_sezione.png

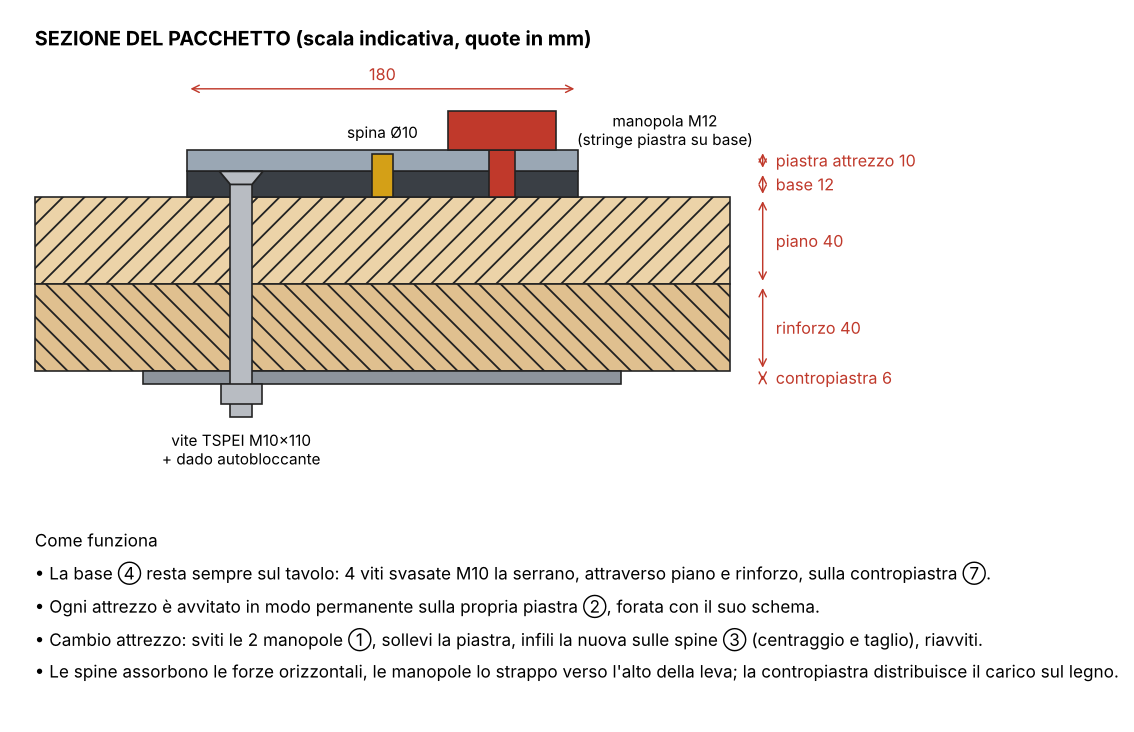
moduli/1-tavolo-base/immagini/piastre_sezione.png
