abettarini/workbench/moduli/2-cassettiera/immagini/cas_esploso.png

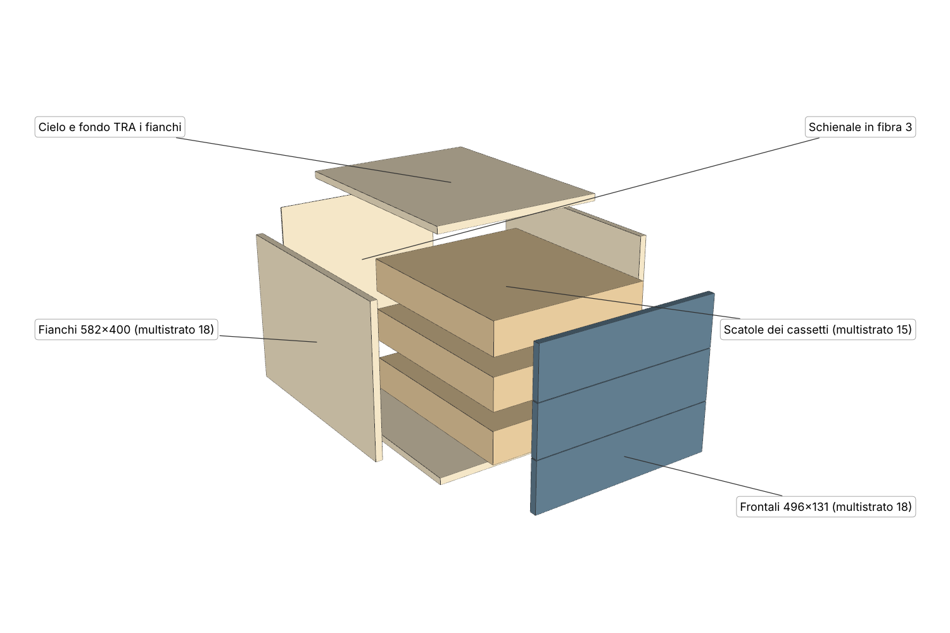
moduli/2-cassettiera/immagini/cas_esploso.png
