abettarini/workbench/moduli/3-alzatina/immagini/alz_mensola_sotto.png

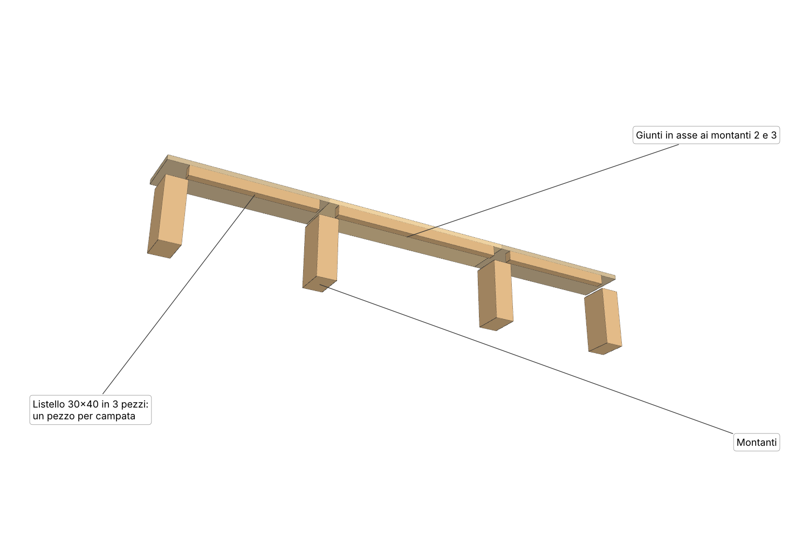
moduli/3-alzatina/immagini/alz_mensola_sotto.png
