abettarini/workbench/moduli/2-cassettiera/cassettiera_costi.xlsx

Sheet: Distinta costi
Modulo 2 – Cassettiera: distinta e costi
Cassettiera fissa per la campata sinistra (3 cassetti). Prezzi verificati il 18/10/2026; celle gialle = stime.
Categoria | Articolo (prodotto trovato) | Uso | Q.tà | Unità | Prezzo unitario | Totale | Fonte prezzo | Negozio | Link | Note
Legno | Multistrato pioppo 18 mm 1200×600 | scatola e frontali (2 pannelli, schema nel manuale) | 2 | pz | 17.80 € | 35.60 € | verificato 18/10/2026 | Tecnomat | apri (https://www.tecnomat.it/it/pioppo-spess-18-mm-dim-120x60-cm-25016807/) | Il pannello intero da 18 non c'è a Tecnomat; LM al m² 59 €/m²
Legno | Multistrato pioppo 15 mm 1200×600 | scatole dei 3 cassetti | 1 | pz | 15.90 € | 15.90 € | verificato 18/10/2026 | Tecnomat | apri (https://www.tecnomat.it/it/pioppo-spess-15-mm-120x60-cm-25022690/)
Legno | Fibra grezza (faesite) 3 mm 2500×1250 | fondi dei cassetti e schienale | 1 | pz | 16.00 € | 16.00 € | verificato 18/10/2026 | Tecnomat | apri (https://www.tecnomat.it/it/fibra-grezza-spess-3-mm-dim-250x125-cm-10048894/) | 3 mm invece di 4: va bene per carichi fino a ~15 kg per cassetto
Ferramenta | Coppia guide cassetto estrazione totale H45 L 500 | 3 cassetti | 3 | cp | 10.90 € | 32.70 € | verificato 18/10/2026 | Tecnomat | apri (https://www.tecnomat.it/it/guide-p-cas-acc-estraz-tot-h45-500mm-bnc-25060371/) | Portata non indicata; LM Cisne-45 a sfere 50 kg a 10,90 €
Ferramenta | Maniglie |  | 3 | pz | 4.00 € | 12.00 € | stima – da verificare | Tecnomat
Ferramenta | Viti 4×45, 3,5×30, 3,5×25, 3×16, 4×16, 4×30, 4×50 | scatola, cassetti, frontali, guide, fissaggio | 1 | set | 10.00 € | 10.00 € | stima – da verificare | Tecnomat
Ferramenta | Collante vinilico D3 Tover 500 ml | giunti | 1 | pz | 4.95 € | 4.95 € | verificato 18/10/2026 | Tecnomat | apri (https://www.tecnomat.it/it/colla-pavimenti-flottanti-tover-500-ml-10036806/)
Finitura | Impregnante legno all'acqua Cipir 0,75 l | scatola e frontali | 1 | pz | 6.70 € | 6.70 € | verificato 18/10/2026 | Tecnomat | apri (https://www.tecnomat.it/it/impregnante-acqua-cipir-incolore-0-75-l-10006177/)
 |  |  |  |  | Prezzi verificati | 111.85 €
 |  |  |  |  | Stime | 22.00 €
 |  |  |  |  | TOTALE | 133.85 €
 |  |  |  |  | di cui legno | 67.50 €
 |  |  |  |  | di cui ferramenta | 59.65 €
 |  |  |  |  | di cui finitura | 6.70 €
 |  |  |  |  | da Tecnomat | 133.85 €
Alternativa economica: scatola in OSB 18 dall'avanzo del pannello del tavolo base (0 €).
Tecnomat taglia i pannelli in negozio: porta il foglio 'Taglio pannelli'.

Sheet: Taglio pannelli
Pezzi da tagliare
Materiale | Pezzo | Lunghezza | Larghezza | Q.tà
multistrato 18 | Cassettiera fianco sx | 578 | 400 | 1
multistrato 18 | Cassettiera fianco dx | 578 | 400 | 1
multistrato 18 | Cassettiera cielo | 578 | 460 | 1
multistrato 18 | Cassettiera fondo | 578 | 460 | 1
multistrato 18 | Frontale cassetto 1 | 496 | 131 | 1
multistrato 18 | Frontale cassetto 2 | 496 | 131 | 1
multistrato 18 | Frontale cassetto 3 | 496 | 131 | 1
multistrato 15 | cassetto 1: fianco | 500 | 85 | 2
multistrato 15 | cassetto 1: testata | 405 | 85 | 2
multistrato 15 | cassetto 2: fianco | 500 | 85 | 2
multistrato 15 | cassetto 2: testata | 405 | 85 | 2
multistrato 15 | cassetto 3: fianco | 500 | 85 | 2
multistrato 15 | cassetto 3: testata | 405 | 85 | 2
pannello di fibra 3 | Cassettiera schienale | 496 | 400 | 1
pannello di fibra 3 | cassetto 1: fondo | 500 | 435 | 1
pannello di fibra 3 | cassetto 2: fondo | 500 | 435 | 1
pannello di fibra 3 | cassetto 3: fondo | 500 | 435 | 1
