abettarini/workbench/confronto_prezzi_negozi.xlsx

Sheet: Prezzi per negozio
Confronto prezzi Tecnomat · OBI · Leroy Merlin (18/10/2026)
Solo prezzi letti sulle pagine dei siti. LM = Leroy Merlin; MP = venditore terzo (marketplace) con spedizione a parte.
Voce | Negozio | Prodotto | Misure | Prezzo | Conf. | Link | Note
Trave 80×120 | Tecnomat | Trave KVH giuntato 80×120×4000 | 80×120×4000 | 29.90 € | 1 | apri (https://www.tecnomat.it/it/trave-kvh-80x120x400-cm-25102417/) | scelta
Trave 80×120 | Tecnomat | Trave abete lamellare GL24h 80×120×4000 | 80×120×4000 | 39.90 € | 1 | apri (https://www.tecnomat.it/it/trave-lamellare-abete-8x12x400-cm-10074468/)
Trave 80×120 | Leroy Merlin | Trave lamellare abete industriale 80×120×4000 | 80×120×4000 | 74.90 € | 1 | apri (https://www.leroymerlin.it/prodotti/trave-lamellare-abete-industriale-l-400-x-p-12-cm-sp-80-mm-35613963.html)
Trave 80×120 | Leroy Merlin | Trave lamellare abete piallato 80×120×4000 | 80×120×4000 | 79.90 € | 1 | apri (https://www.leroymerlin.it/prodotti/trave-lamellare-in-abete-piallato-l-400-x-p-8-x-sp-12-cm-35282156.html)
Trave (alternativa) | OBI | Travetto abete massello angoli arrotondati 90×90×3000 | 90×90×3000 | 41.99 € | 1 | apri (https://www.obi-italia.it/p/2872109) | OBI non ha 80×120
Piano 2000×800×40 | Tecnomat | Tavola abete lamellare 200×80 sp. 40 | 2000×800×40 | 79.00 € | 1 | apri (https://www.tecnomat.it/it/tavola-abete-lam-200x80-cm-spess-40-25035058/) | scelta
Piano 2000×800×40 | Leroy Merlin | Tavola lamellare abete 40 mm 80×200 (MP Cardigliano) | 2000×800×40 | 147.45 € | 1 | apri (https://www.leroymerlin.it/prodotti/tavola-pannello-lamellare-abete-spessore-mm-40-80-cm-200-cm-84286356.html) | solo online
Piano 2000×800 (28 mm) | Tecnomat | Tavola abete lamellare 200×80 sp. 28 | 2000×800×28 | 49.90 € | 1 | apri (https://www.tecnomat.it/it/tavola-abete-lam-200x80-cm-spess-28-10074974/)
Piano 2000×800 (27 mm) | Leroy Merlin | Tavola lamellare abete 80×200 sp. 27 | 2000×800×27 | 69.90 € | 1 | apri (https://www.leroymerlin.it/prodotti/tavola-lamellare-in-legno-di-abete-l-80-x-200-cm-x-sp-27-mm-86909783.html)
OSB/3 18 | Tecnomat | OSB 3 di pioppo 18 mm 250×125 | 2500×1250×18 | 27.50 € | 1 | apri (https://www.tecnomat.it/it/osb-3-pioppo-spess-18-mm-dim-250x125-cm-10043418/) | scelta
OSB/3 18 | Leroy Merlin | Pannello OSB 3 250×125 sp. 18 | 2500×1250×18 | 30.50 € | 1 | apri (https://www.leroymerlin.it/prodotti/pannello-osb-3-l-250-x-h-125-cm-sp-18-mm-naturale-89126386.html)
OSB/3 18 | OBI | Pannello OSB/3 2500×1250×18 | 2500×1250×18 | 31.49 € | 1 | apri (https://www.obi-italia.it/p/2099109)
Multistrato pioppo 18 | Tecnomat | Multistrato pioppo 18 mm 120×60 | 1200×600×18 | 17.80 € | 1 | apri (https://www.tecnomat.it/it/pioppo-spess-18-mm-dim-120x60-cm-25016807/) | scelta
Multistrato pioppo 18 | Leroy Merlin | Compensato pioppo 18 mm al taglio | al m² | 59.00 € | m² | apri (https://www.leroymerlin.it/prodotti/pannello-compensato-pioppo-l-250-x-h-122-cm-sp-18-mm-naturale-su-misura-pioppo-33000702.html)
Multistrato pioppo 15 | Tecnomat | Multistrato pioppo 15 mm 120×60 | 1200×600×15 | 15.90 € | 1 | apri (https://www.tecnomat.it/it/pioppo-spess-15-mm-120x60-cm-25022690/) | scelta
Multistrato pioppo 15 | Tecnomat | Multistrato pioppo 15 mm 244×122 | 2440×1220×15 | 47.60 € | 1 | apri (https://www.tecnomat.it/it/pioppo-spess-15-mm-244x122-cm-25022700/)
Multistrato pioppo 15 | OBI | Pannello pioppo multistrato 15×1200×900 | 1200×900×15 | 49.99 € | 1 | apri (https://www.obi-italia.it/p/5533476)
Multistrato pioppo 15 | Leroy Merlin | Multistrato pioppo 250×122 sp. 15 | 2500×1220×15 | 80.50 € | 1 | apri (https://www.leroymerlin.it/prodotti/pannello-multistrato-in-pioppo-l-250-x-h-122-cm-sp-15-mm-naturale-89185626.html)
Fondi cassetti | Tecnomat | Fibra grezza 3 mm 250×125 | 2500×1250×3 | 16.00 € | 1 | apri (https://www.tecnomat.it/it/fibra-grezza-spess-3-mm-dim-250x125-cm-10048894/) | scelta
Fondi cassetti | OBI | MDF pretagliato 1010×700×4 | 1010×700×4 | 9.19 € | 1 | apri (https://www.obi-italia.it/p/3809142)
Tavola 200 mm larga | Tecnomat | Tavola abete lamellare 100×20 sp. 18 | 1000×200×18 | 4.50 € | 1 | apri (https://www.tecnomat.it/it/tavola-abete-lam-100x20-cm-spess-18-10074965/) | scelta (mensola)
Tavola 200 mm larga | OBI | Tavola lamellare abete 800×200×18 | 800×200×18 | 8.79 € | 1 | apri (https://www.obi-italia.it/p/2190791)
Tavola 200 mm larga | OBI | Tavola lamellare abete 800×200×14 | 800×200×14 | 8.19 € | 1 | apri (https://www.obi-italia.it/p/2423135)
Listello 30×40 | Tecnomat | Listello abete grezzo 2 m 30×40 | 30×40×2000 | 3.10 € | 1 | apri (https://www.tecnomat.it/it/listello-abete-grezzo-2-m-30x40-mm-25039932/) | scelta
Listello 30×40 | OBI | Listello abete piallato 4 lati 30×40×2000 | 30×40×2000 | 3.99 € | 1 | apri (https://www.obi-italia.it/p/6191670)
Vite M10 lunga | OBI | Vite testa cilindrica zincata M10×180 | M10×180 | 1.39 € | 1 | apri (https://www.obi-italia.it/p/6282354) | scelta (B1 e B2)
Vite M10 lunga | OBI | Viti testa cilindrica M10×160 | M10×160 | 13.09 € | 10 | apri (https://www.obi-italia.it/p/6253421)
Vite M10 lunga | OBI | Vite testa esagonale M10×140 | M10×140 | 3.99 € | 5 | apri (https://www.obi-italia.it/p/6271043) | testa esagonale: lamatura Ø30
Vite M10 lunga | Tecnomat | Bulloni testa tonda collo quadro M10×160 Würth | M10×160 | 19.45 € | 25 | apri (https://www.tecnomat.it/it/bulloni-t-tonda-quadra-zinc-m10x160-25pz-10049377/)
Vite M10 lunga | Leroy Merlin | Vite testa esagonale DIN 931 M10×140 (MP) | M10×140 | 35.31 € | 50 | apri (https://www.leroymerlin.it/prodotti/vite-con-filetto-metrico-a-testa-esagonale-8-8-filetto-medio-din-931-zincato-m10-x-140-scatola-da-50-unita-86447822.html) | spedizione 12,50 €
Vite strutturale Ø8 | Tecnomat | Viti legno SNK TPS Rothoblaas 8×160 | 8×160 | 27.45 € | 100 | apri (https://www.tecnomat.it/it/p-viti-legno-tps-snk-8x160-mm-100pz-25026900/) | scelta (fasce)
Vite strutturale Ø8 | Tecnomat | Viti legno SNK TPS Rothoblaas 8×200 | 8×200 | 41.90 € | 100 | apri (https://www.tecnomat.it/it/p-viti-legno-tps-snk-8x200-mm-100pz-25026876/)
Vite strutturale Ø8 | OBI | Vite legno testa svasata T40 8×180 | 8×180 | 3.99 € | 2 | apri (https://www.obi-italia.it/p/5045984) | 24 viti = 47,88 €
Fascia anteriore 80×80 | Tecnomat | Morale abete grezzo 80×80×4000 | 80×80×4000 | 13.90 € | 1 | apri (https://www.tecnomat.it/it/morale-abete-grezzo-80x80x4000-mm-10041080/) | scelta
Fascia anteriore 80×80 | Leroy Merlin | Morale listello travetto piallato 78×78 (MP) | 78×78×2000 | 9.40 € | 1 |  | 2 mm più piccolo, solo online
Fascia 2000 (alternativa) | Tecnomat | Tavola abete lamellare 200×60 sp. 28 (da refilare) | 2000×600×28 | 42.00 € | 1 | apri (https://www.tecnomat.it/it/tavola-abete-lam-200x60-cm-spess-28-10074970/) | scartata: KVH dalle stesse barre a costo zero
Fascia 2000 (alternativa) | Tecnomat | Tavola abete lamellare 200×40 sp. 18 (da refilare) | 2000×400×18 | 18.00 € | 1 | apri (https://www.tecnomat.it/it/tavola-abete-lam-200x40-cm-spess-18-10074956/) | troppo sottile su 2 m
Fascia 2000 (alternativa) | Leroy Merlin | Tavola abete grezzo 2000×380×50 | 2000×380×50 | 48.99 € | 1 | apri (https://www.leroymerlin.it/prodotti/tavola-rettangolare-in-abete-grezzo-2000-x-380-x-50-mm-36596630.html) | massello grezzo, da piallare
Barra filettata M10 1 m | Tecnomat | Barra filettata M10×1 m zincata | M10×1000 | 1.65 € | 1 | apri (https://www.tecnomat.it/it/barra-filettata-zinc-m10x1m-10066674/) | scelta
Barra filettata M10 1 m | Leroy Merlin | Barra filettata SUKI M10×1000 | M10×1000 | 1.75 € | 1 | apri (https://www.leroymerlin.it/prodotti/barra-filettata-suki-in-acciaio-m10-l-1000-mm-35737030.html)
Barra filettata M10 1 m | OBI | Barra filettata zincata M10×1000 | M10×1000 | 3.19 € | 1 | apri (https://www.obi-italia.it/p/4328456)
Spine Ø12 | OBI | Spine in faggio zigrinato Ø12 | Ø12 | 3.69 € | 25 | apri (https://www.obi-italia.it/p/4884714) | scelta
Spine Ø12 | Tecnomat | Tondo faggio zigrinato Ø12×1000 | Ø12×1000 | 0.80 € | 1 | apri (https://www.tecnomat.it/it/tondo-faggio-zigrinato-o-12-mm-h-100-cm-10018430/) | da tagliare
Guide cassetto 500 | Tecnomat | Coppia guide estrazione totale H45 L500 | 500 | 10.90 € | coppia | apri (https://www.tecnomat.it/it/guide-p-cas-acc-estraz-tot-h45-500mm-bnc-25060371/) | scelta
Guide cassetto 500 | Leroy Merlin | Guide Cisne-45 a sfere 50 kg L500 (MP) | 500 | 10.90 € | ? | apri (https://www.leroymerlin.it/prodotti/guide-per-cassetto-cisne-45-a-sfere-h45-mm-estrazione-totale-portata-50-kg-lunghezza-500-mm-chiusura-standard-evotrade-846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)
Guide cassetto 500 | OBI | Guida a sfere Hettich Silent System 50 cm | 500 | 37.99 € | ? | apri (https://www.obi-italia.it/p/4503207)
Staffa angolare 90×90 | OBI | Staffa angolare con nervatura 90×90×65 | 90×90×65 | 2.89 € | 1 | apri (https://www.obi-italia.it/p/3786233) | scelta
Staffa angolare 90×90 | Tecnomat | Squadretta di giunzione angolare 90×90×65 | 90×90×65 | 0.80 € | 1 | apri (https://www.tecnomat.it/it/squadretta-di-giunz-angol-90x90x65mm-10062291/) | nervatura non indicata
Passacavi Ø60 | Tecnomat | Bocchette passacavi Ø60 PVC nero | Ø60 | 1.05 € | 2 | apri (https://www.tecnomat.it/it/bocchette-passacavi-in-pvc-nero-o60-2pz-25019432/) | scelta
Passacavi Ø60 | Leroy Merlin | Passacavo Hettich Ø60 grigio | Ø60 | 0.99 € | 1 | apri (https://www.leroymerlin.it/prodotti/passacavo-hettich-grigio-argento-60-mm-43826482.html)
Canalina | Tecnomat | Canalina Arnocanali 60×40 2 scomparti | 60×40 | 8.55 € | 1 | apri (https://www.tecnomat.it/it/canalina-ufficio-60x40-mm-2-scomparti-10052978/) | scelta (lunghezza da verificare)
Canalina | Leroy Merlin | Canalina per scrivanie e tavoli 76 cm (MP) | 760×185×100 | 36.95 € | 1 | apri (https://www.leroymerlin.it/prodotti/canalina-per-scrivanie-e-tavoli-76-cm-84891827.html) | spedizione da 15,95 €
Non trovati in nessuno dei tre negozi: dadi a tamburo M10, viti TCEI M10×140/180 dichiarate, viti TSPEI M10 lunghe, inserti M10 a vite (solo MP).

Sheet: Giunzioni alternative
Sistemi di giunzione del telaio: confronto (D = soluzione adottata)
Sistema | Componente | Negozio | Q.tà | Prezzo | Totale | Note
A · Bulloni + dadi a tamburo (precedente) | Vite M10×180 testa cilindrica | OBI | 16 | 1.39 € | 22.24 € | smontabile, rigido; fori precisi con dima
A · Bulloni + dadi a tamburo (precedente) | Viti M10×160 conf. 10 (accorciate) | OBI | 1 | 13.09 € | 13.09 €
A · Bulloni + dadi a tamburo (precedente) | Dadi a tamburo M10 (stima, online) | ferramenta/online | 38 | 0.80 € | 30.40 € | unico pezzo non trovato a scaffale
A · Bulloni + dadi a tamburo (precedente) | Barra filettata M10 1 m | Tecnomat | 1 | 1.65 € | 1.65 €
A · Bulloni + dadi a tamburo (precedente) | Spine Ø12 conf. 25 | OBI | 3 | 3.69 € | 11.07 €
B · Viti strutturali | Viti Rothoblaas TPS 8×200 conf. 100 | Tecnomat | 1 | 41.90 € | 41.90 € | 2 viti per nodo (68), inclinate; si smonta poche volte
B · Viti strutturali | Spine Ø12 conf. 25 | OBI | 3 | 3.69 € | 11.07 € | antirotazione
C · Staffe metalliche | Staffa angolare con nervatura 90×90×65 (conf. 20 a 29,99 €) | OBI | 4 | 29.99 € | 119.96 € | 2 per nodo (68 → 4 conf.); si vedono, meno rigido
C · Staffe metalliche | Viti per staffe (stima) | Tecnomat | 1 | 12.00 € | 12.00 €
D · Telai + fasce (adottata) | Vite M10×180 testa cilindrica (16 B1 + 4 B2 accorciate) | OBI | 20 | 1.39 € | 27.80 € | 20 nodi imbullonati: telai laterali e traverse basse anteriori
D · Telai + fasce (adottata) | Dadi a tamburo M10 (stima, online) | ferramenta/online | 20 | 0.80 € | 16.00 € | +4 per l'alzatina, contati nella distinta
D · Telai + fasce (adottata) | Viti Rothoblaas TPS 8×160 conf. 100 | Tecnomat | 1 | 27.45 € | 27.45 € | fasce: 24 viti perpendicolari nelle facce delle gambe
D · Telai + fasce (adottata) | Spine Ø12 conf. 25 | OBI | 2 | 3.69 € | 7.38 €
 |  |  |  | Totale A | 78.45 €
 |  |  |  | Totale B | 52.97 €
 |  |  |  | Totale C | 131.96 €
 |  |  |  | Totale D | 78.63 €
