abettarini/workbench/moduli/1-tavolo-base/tavolo_base_costi.xlsx

Sheet: Distinta costi
Modulo 1 – Tavolo base: distinta e costi
Prezzi verificati sui siti di Tecnomat, OBI e Leroy Merlin il 18/10/2026 (possono variare per negozio). Celle gialle = stime.
Categoria | Articolo (prodotto trovato) | Uso | Q.tà | Unità | Prezzo unitario | Totale | Fonte prezzo | Negozio | Link | Note
Legno | Trave legno massiccio strutturale KVH giuntato 80×120×4000 | gambe, traverse laterali, 2 fasce posteriori da 1990, traverse basse anteriori e i 4 montanti dell'alzatina | 4 | pz | 29.90 € | 119.60 € | verificato 18/10/2026 | Tecnomat | apri (https://www.tecnomat.it/it/trave-kvh-80x120x400-cm-25102417/) | Solo Tecnomat; OBI e Leroy Merlin non hanno KVH
Legno | Morale abete grezzo 80×80×4000 | fascia anteriore FA da 1990 (avanzano ~2 m) | 1 | pz | 13.90 € | 13.90 € | verificato 18/10/2026 | Tecnomat | apri (https://www.tecnomat.it/it/morale-abete-grezzo-80x80x4000-mm-10041080/) | Grezzo: scegli un pezzo dritto, secco e senza fessure, poi levigalo. LM: piallato 78×78×2000 a 9,40 € (online)
Legno | Tavola abete lamellare 2000×800×40 | piano di lavoro (intero) | 1 | pz | 79.00 € | 79.00 € | verificato 18/10/2026 | Tecnomat | apri (https://www.tecnomat.it/it/tavola-abete-lam-200x80-cm-spess-40-25035058/) | Leroy Merlin: 147,45 € (marketplace); OBI: non c'è lo spessore 40
Legno | OSB 3 pioppo 18 mm 2500×1250 | 3 ripiani bassi + rinforzo ricarica (2 strati) | 1 | pz | 27.50 € | 27.50 € | verificato 18/10/2026 | Tecnomat | apri (https://www.tecnomat.it/it/osb-3-pioppo-spess-18-mm-dim-250x125-cm-10043418/) | OBI 31,49 €, Leroy Merlin 30,50 €
Legno | Listello abete grezzo 30×40×2000 | reggiripiano: 4 × 520 + 2 × 260 | 2 | pz | 3.10 € | 6.20 € | verificato 18/10/2026 | Tecnomat | apri (https://www.tecnomat.it/it/listello-abete-grezzo-2-m-30x40-mm-25039932/) | Grezzo va bene: resta nascosto sotto i ripiani
Ferramenta telaio | Vite a testa cilindrica zincata M10×180 (B1 + B2) | 16 traverse laterali (B1) + 4 traverse basse anteriori (B2, accorciate a 140) | 20 | pz | 1.39 € | 27.80 € | verificato 18/10/2026 | OBI | apri (https://www.obi-italia.it/p/6282354) | In negozio verifica che sia a esagono incassato (TCEI). Le 4 B2: accorciale a 140 mm col seghetto (avvita prima un dado per ripulire il filetto)
Ferramenta telaio | Dado a tamburo M10 (D) | 20 testate di traversa + 4 predisposizione alzatina | 24 | pz | 0.80 € | 19.20 € | stima – da verificare | ferramenta/online |  | Non venduto dai tre negozi: ferramenta, Würth o online. Misura il diametro prima di forare
Ferramenta telaio | Viti legno SNK TPS Rothoblaas 8×160, conf. 100 pz (V) | fasce sulle gambe: 2 per gamba per fascia (24) | 1 | conf | 27.45 € | 27.45 € | verificato 18/10/2026 | Tecnomat | apri (https://www.tecnomat.it/it/p-viti-legno-tps-snk-8x160-mm-100pz-25026900/) | Ne avanzano molte: utili per altri lavori. OBI vende 8×180 a 3,99 € ogni 2 pz (12 conf. = 47,88 €)
Ferramenta telaio | Spine in faggio zigrinato Ø12, conf. 25 pz | 2 per testata (40) | 2 | conf | 3.69 € | 7.38 € | verificato 18/10/2026 | OBI | apri (https://www.obi-italia.it/p/4884714) | Lunghezza non indicata: servono ~50 mm. In alternativa tondo faggio Ø12×1000 Tecnomat 0,80 € da tagliare
Ferramenta telaio | Collante vinilico D3 Tover 500 ml | spine, rinforzo, listelli | 1 | pz | 4.95 € | 4.95 € | verificato 18/10/2026 | Tecnomat | apri (https://www.tecnomat.it/it/colla-pavimenti-flottanti-tover-500-ml-10036806/)
Ferramenta telaio | Piede regolabile Ø40 vite M10, conf. 2 pz | sotto le gambe | 4 | conf | 1.65 € | 6.60 € | verificato 18/10/2026 | Tecnomat | apri (https://www.tecnomat.it/it/piede-tondo-nero-o40-2-pz-10038522/)
Ferramenta telaio | Dado ragno M10 zincato (al posto dell'inserto a vite) | sede filettata sotto ogni gamba | 8 | pz | 2.79 € | 22.32 € | verificato 18/10/2026 | OBI | apri (https://www.obi-italia.it/p/4611364) | Foro Ø12 invece di Ø14; pezzi per confezione non indicati. Inserti M10 a vite: solo marketplace LM
Ferramenta telaio | Squadretta a L 30×38×30 zincata | fissaggio del piano | 16 | pz | 0.50 € | 8.00 € | verificato 18/10/2026 | Tecnomat | apri (https://www.tecnomat.it/it/squadretta-a-l-30x38x30-per-vite-10027452/) | Senza asola: allunga a mano il foro verso il piano con una punta Ø6
Ferramenta telaio | Viti legno assortite (5×60, 5×70, 4×35, 4×50, 4,5×25) | rinforzo, listelli, ripiani, squadrette | 1 | set | 15.00 € | 15.00 € | stima – da verificare | Tecnomat
Ferramenta telaio | Tassello per telai Ø10 con vite, L 160 | fissaggio a muro attraverso la fascia posteriore alta (4) | 4 | pz | 1.20 € | 4.80 € | stima – da verificare | Tecnomat |  | Scegli il tipo in base al muro (pieno, forato, cartongesso)
Zona ricarica | Piastre acciaio tagliate e forate (base 180×180×12, contropiastra 220×220×6, 3 piastre attrezzo) | attacco presse e morsa | 1 | lotto | 90.00 € | 90.00 € | stima – da verificare | officina/carpenteria |  | Chiedi un preventivo a un'officina o a un servizio di taglio laser
Zona ricarica | Vite TSPEI M10×110 + dado autobloccante | base, 2 posteriori | 2 | pz | 1.50 € | 3.00 € | stima – da verificare | ferramenta/online |  | Non trovate a scaffale
Zona ricarica | Vite TSPEI M10×160 + dado autobloccante | base, 2 anteriori (attraversano piano e fascia anteriore) | 2 | pz | 1.80 € | 3.60 € | stima – da verificare | ferramenta/online |  | Non trovate a scaffale
Zona ricarica | Dadi autobloccanti M10 inox, conf. 10 pz | sotto la base | 1 | conf | 2.40 € | 2.40 € | verificato 18/10/2026 | Tecnomat | apri (https://www.tecnomat.it/it/dadi-aut-bassi-m10-inox-316-10pz-10055310/)
Zona ricarica | Rondelle piane larghe M10 (Ø29,5), conf. 8 pz | sotto la fascia anteriore e la contropiastra | 1 | conf | 2.50 € | 2.50 € | verificato 18/10/2026 | Leroy Merlin | apri (https://www.leroymerlin.it/prodotti/8-rondelle-piane-larghe-in-acciaio-zincato-standers-int-10-est-29-48-mm-82583073.html)
Zona ricarica | Manopole a stella M12 + 2 spine Ø10 h8 | bloccaggio piastre | 1 | kit | 10.00 € | 10.00 € | stima – da verificare | ferramenta/online
Elettrico | Canalina di distribuzione Arnocanali 60×40, 2 scomparti | una per campata (da tagliare) | 3 | pz | 8.55 € | 25.65 € | verificato 18/10/2026 | Tecnomat | apri (https://www.tecnomat.it/it/canalina-ufficio-60x40-mm-2-scomparti-10052978/) | Lunghezza non indicata: verifica. Alternativa specifica sottoscrivania: LM 76 cm 36,95 € (online)
Elettrico | Bocchette passacavi Ø60 PVC nero, conf. 2 pz | piano | 1 | conf | 1.05 € | 1.05 € | verificato 18/10/2026 | Tecnomat | apri (https://www.tecnomat.it/it/bocchette-passacavi-in-pvc-nero-o60-2pz-25019432/)
Elettrico | Ciabatta 6 prese con interruttore | campata seduta | 1 | pz | 20.00 € | 20.00 € | stima – da verificare | Tecnomat
Finitura | Olio Adler facile applicazione interno 750 ml | piano di lavoro | 1 | pz | 27.90 € | 27.90 € | verificato 18/10/2026 | Tecnomat | apri (https://www.tecnomat.it/it/olio-facile-appl-int-legno-adler-750-ml-10070802/)
Finitura | Impregnante legno all'acqua Cipir 0,75 l incolore | telaio e ripiani OSB | 1 | pz | 6.70 € | 6.70 € | verificato 18/10/2026 | Tecnomat | apri (https://www.tecnomat.it/it/impregnante-acqua-cipir-incolore-0-75-l-10006177/)
Finitura | Abrasivi 80–120–180 | levigatura | 1 | set | 8.00 € | 8.00 € | stima – da verificare | Tecnomat
 |  |  |  |  | Prezzi verificati | 416.90 €
 |  |  |  |  | Stime | 173.60 €
 |  |  |  |  | TOTALE | 590.50 €
 |  |  |  |  | di cui legno | 246.20 €
 |  |  |  |  | di cui ferramenta telaio | 143.50 €
 |  |  |  |  | di cui zona ricarica | 111.50 €
 |  |  |  |  | di cui elettrico | 46.70 €
 |  |  |  |  | di cui finitura | 42.60 €
 |  |  |  |  | da Leroy Merlin | 2.50 €
 |  |  |  |  | da OBI | 57.50 €
 |  |  |  |  | da Tecnomat | 404.70 €
 |  |  |  |  | da ferramenta/online | 35.80 €
 |  |  |  |  | da officina/carpenteria | 90.00 €
Tecnomat: taglio legno in negozio, 1° taglio gratis poi 1 € a taglio (solo per pannelli e listelli comprati lì).
I prezzi Tecnomat sono del negozio predefinito del sito (Roma Prenestina): controlla quello dove andrai.
I 4 dadi a tamburo della predisposizione alzatina vanno inseriti durante il montaggio del tavolo.
Telaio: 4 telai laterali imbullonati + 3 fasce a tutta lunghezza avvitate (2 posteriori KVH, 1 anteriore in morale 80×80).

Sheet: Confronto travi
Confronto travi per il telaio
Trave | Sezione | Lungh. barra (m) | Prezzo barra | Prezzo al metro | Metri necessari | Rigidezza gamba (8×8=1) | Barre necessarie | Costo telaio
Trave abete 120×120 – 6 m | 120×120 | 6.0 | 83.50 € | 13.92 €/m | 14.28 | 5.1 | 3 | 250.50 €
Trave abete 120×120 – 4 m | 120×120 | 4.0 | 55.90 € | 13.97 €/m | 14.28 | 5.1 | 4 | 223.60 €
Trave abete 90×90 – 4 m | 90×90 | 4.0 | 31.90 € | 7.97 €/m | 15.12 | 1.6 | 4 | 127.60 €
KVH giuntato 80×120 – 4 m | 80×120 | 4.0 | 29.90 € | 7.47 €/m | 14.76 | 3.4 | 4 | 119.60 €
KVH giuntato 100×120 – 4 m | 100×120 | 4.0 | 39.90 € | 9.97 €/m | 14.52 | 4.2 | 4 | 159.60 €
Riga verde = trave scelta (Tecnomat). Lamellare GL24h 80×120×4000 Tecnomat 39,90 €; Leroy Merlin 74,90–79,90 €; OBI non ha travi 80×120.

Sheet: Confronto ripiani
Ripiani bassi e rinforzo ricarica: materiali a confronto
Materiale | Negozio | Formato | Pezzi | Prezzo | Costo | Note
OSB/3 18 (SCELTO) | Tecnomat | 2500×1250 | 1 | 27.50 € | 27.50 € | Un pannello per 3 ripiani + rinforzo in 2 strati; avanzano ~1,8 m²
OSB/3 18 | Leroy Merlin | 2500×1250 | 1 | 30.50 € | 30.50 €
OSB/3 18 | OBI | 2500×1250 | 1 | 31.49 € | 31.49 €
Lamellare abete 40 | Tecnomat | 2000×800 | 1 | 79.00 € | 79.00 € | Ripiani più spessi e belli, 2,9 volte l'OSB
Tavola lamellare 14 | OBI | 800×200 | 14 | 8.19 € | 114.66 € | 8 per i ripiani + 6 per il rinforzo: la più cara

Sheet: Taglio travi
Taglio travi KVH 80×120 (barre da 4 m)
Barra | Tagli (mm) | Usato (mm) | Avanzo (mm)
Barra 1 | 1990 + 1990 | 3998 | 2
Barra 2 | 700 + 700 + 700 + 700 + 400 + 400 | 3634 | 366
Barra 3 | 700 + 700 + 700 + 700 + 400 + 400 | 3634 | 366
Barra 4 | 500 + 480 + 400 + 400 + 400 + 400 + 250 + 250 + 250 + 250 | 3630 | 370
1990 = fasce posteriori FPa e FPb (la fascia anteriore è un morale 80×80 a parte). I 4 pezzi da 250 sono i montanti dell'alzatina: tagliali e conservali. Tecnomat taglia in negozio (1 € a taglio dopo il primo).
