abettarini/workbench/moduli/3-alzatina/alzatina_costi.xlsx

Modulo 3 – Alzatina con mensola: distinta e costi
Si monta sul tavolo base usando le predisposizioni. Prezzi verificati il 18/10/2026; celle gialle = stime.
Categoria | Articolo (prodotto trovato) | Uso | Q.tà | Unità | Prezzo unitario | Totale | Fonte prezzo | Negozio | Link | Note
Legno | Montanti KVH 80×120×250 | tagliati con le travi del tavolo base | 4 | pz | 0.00 € | 0.00 € | incluso nel tavolo base | Tecnomat
Legno | Tavola in abete lamellare 1000×200×18 | mensola: tagliate a 620, 780 e 600 | 3 | pz | 4.50 € | 13.50 € | verificato 18/10/2026 | Tecnomat | apri (https://www.tecnomat.it/it/tavola-abete-lam-100x20-cm-spess-18-10074965/) | OBI 800×200×18 8,79 €; OBI 800×200×14 8,19 €
Legno | Listello abete grezzo 30×40×2000 | rinforzo sotto il bordo anteriore: 3 pezzi tra i montanti (500, 700, 480) | 1 | pz | 3.10 € | 3.10 € | verificato 18/10/2026 | Tecnomat | apri (https://www.tecnomat.it/it/listello-abete-grezzo-2-m-30x40-mm-25039932/) | Visibile dal basso: levigalo. Piallato 30×40×2000 da OBI a 3,99 €
Ferramenta | Barra filettata M10×1000 zincata | 4 spezzoni da 390 | 2 | pz | 1.65 € | 3.30 € | verificato 18/10/2026 | Tecnomat | apri (https://www.tecnomat.it/it/barra-filettata-zinc-m10x1m-10066674/)
Ferramenta | Dado cieco M10 + rondella Ø30 | sopra la mensola | 4 | set | 0.80 € | 3.20 € | stima – da verificare | Tecnomat
Ferramenta | Dadi a tamburo M10 nelle gambe posteriori | già montati con il tavolo base | 4 | pz | 0.00 € | 0.00 € | incluso nel tavolo base | ferramenta/online
Ferramenta | Viti 4×50 | listello sotto le tavole | 1 | conf | 3.00 € | 3.00 € | stima – da verificare | Tecnomat
Ferramenta | Collante vinilico D3 Tover 500 ml | listello | 1 | pz | 4.95 € | 4.95 € | verificato 18/10/2026 | Tecnomat | apri (https://www.tecnomat.it/it/colla-pavimenti-flottanti-tover-500-ml-10036806/) | Se avanza dal tavolo base: 0 €
Ferramenta | Staffa angolare con nervatura 90×90×65 zincata | fissaggio a muro sotto la mensola, vicino a M1 e M4 | 2 | pz | 2.89 € | 5.78 € | verificato 18/10/2026 | OBI | apri (https://www.obi-italia.it/p/3786233)
Ferramenta | Tasselli Ø8 | fissaggio a muro | 1 | conf | 2.00 € | 2.00 € | stima – da verificare | Tecnomat
Finitura | Impregnante (quota) | mensola e montanti | 1 | pz | 3.00 € | 3.00 € | stima – da verificare | Tecnomat
 |  |  |  |  | Prezzi verificati | 30.63 €
 |  |  |  |  | Stime | 11.20 €
 |  |  |  |  | TOTALE | 41.83 €
 |  |  |  |  | di cui legno | 16.60 €
 |  |  |  |  | di cui ferramenta | 22.23 €
 |  |  |  |  | di cui finitura | 3.00 €
 |  |  |  |  | da OBI | 5.78 €
 |  |  |  |  | da Tecnomat | 36.05 €
 |  |  |  |  | da ferramenta/online | 0.00 €
Se il tavolo base è già montato senza i montanti, serve 1 m di KVH 80×120: una barra da 4 m costa 29,90 € (Tecnomat).
