abettarini/workbench/archivio/listelli-25x50/tavolo_listelli.step

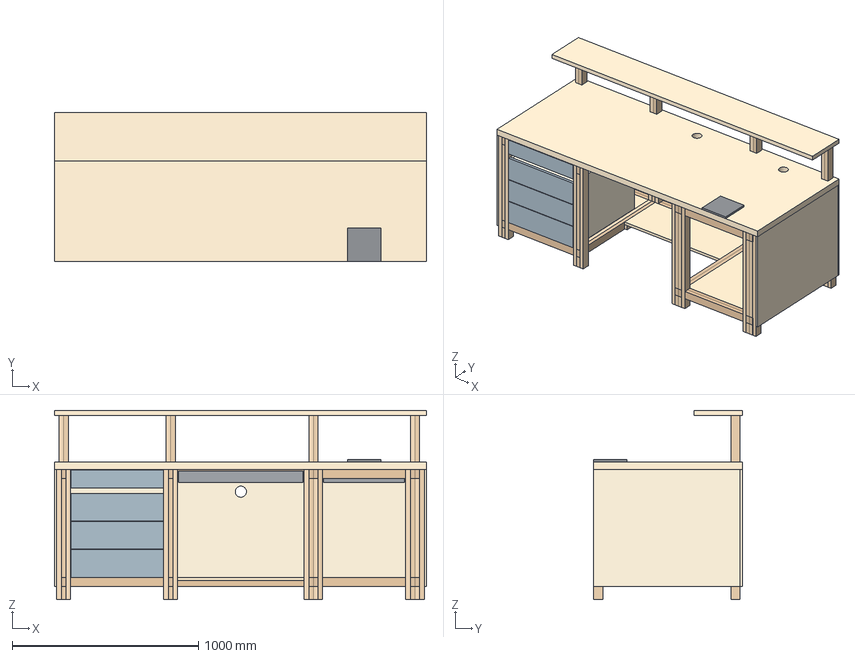
[picture p44: CAD file, 2026-10-18]
archivio/listelli-25x50/tavolo_listelli.step
2000.0 x 800.0 x 1017.0 mm
000_Gamba_1_ant_-_strato_1
001_Gamba_1_ant_-_strato_2_(piede)
002_Gamba_1_ant_-_strato_2_(centro)
003_Gamba_1_ant_-_strato_3
004_Gamba_1_post_-_strato_1
005_Gamba_1_post_-_strato_2_(piede)
006_Gamba_1_post_-_strato_2_(centro)
007_Gamba_1_post_-_strato_3
008_Gamba_2_ant_-_strato_1
009_Gamba_2_ant_-_strato_2_(piede)
010_Gamba_2_ant_-_strato_2_(centro)
011_Gamba_2_ant_-_strato_3
012_Gamba_2_post_-_strato_1
013_Gamba_2_post_-_strato_2_(piede)
014_Gamba_2_post_-_strato_2_(centro)
015_Gamba_2_post_-_strato_3
016_Gamba_3_ant_-_strato_1
017_Gamba_3_ant_-_strato_2_(piede)
018_Gamba_3_ant_-_strato_2_(centro)
019_Gamba_3_ant_-_strato_3_(piede)
020_Gamba_3_ant_-_strato_3_(centro)
021_Gamba_3_ant_-_strato_4
022_Gamba_3_post_-_strato_1
023_Gamba_3_post_-_strato_2_(piede)
024_Gamba_3_post_-_strato_2_(centro)
025_Gamba_3_post_-_strato_3_(piede)
026_Gamba_3_post_-_strato_3_(centro)
027_Gamba_3_post_-_strato_4
028_Gamba_4_ant_-_strato_1
029_Gamba_4_ant_-_strato_2_(piede)
030_Gamba_4_ant_-_strato_2_(centro)
031_Gamba_4_ant_-_strato_3_(piede)
032_Gamba_4_ant_-_strato_3_(centro)
033_Gamba_4_ant_-_strato_4
034_Gamba_4_post_-_strato_1
035_Gamba_4_post_-_strato_2_(piede)
036_Gamba_4_post_-_strato_2_(centro)
037_Gamba_4_post_-_strato_3_(piede)
038_Gamba_4_post_-_strato_3_(centro)
039_Gamba_4_post_-_strato_4
040_Trav_sup_lat_1_-_tenone
041_Trav_sup_lat_1_-_fianco
042_Trav_inf_lat_1_-_tenone
043_Trav_inf_lat_1_-_fianco
044_Trav_sup_lat_2_-_tenone
045_Trav_sup_lat_2_-_fianco
046_Trav_inf_lat_2_-_tenone
047_Trav_inf_lat_2_-_fianco
048_Trav_sup_lat_3_-_tenone
049_Trav_sup_lat_3_-_tenone
050_Trav_inf_lat_3_-_tenone
051_Trav_inf_lat_3_-_tenone
052_Trav_sup_lat_4_-_tenone
053_Trav_sup_lat_4_-_tenone
054_Trav_inf_lat_4_-_tenone
055_Trav_inf_lat_4_-_tenone
056_Trav_sup_post_cassetti_-_strato_1
057_Trav_sup_post_cassetti_-_strato_2
058_Trav_inf_post_cassetti_-_strato_1
059_Trav_inf_post_cassetti_-_strato_2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
