abettarini/workbench/archivio/quadrotti-8x8/tavolo.step

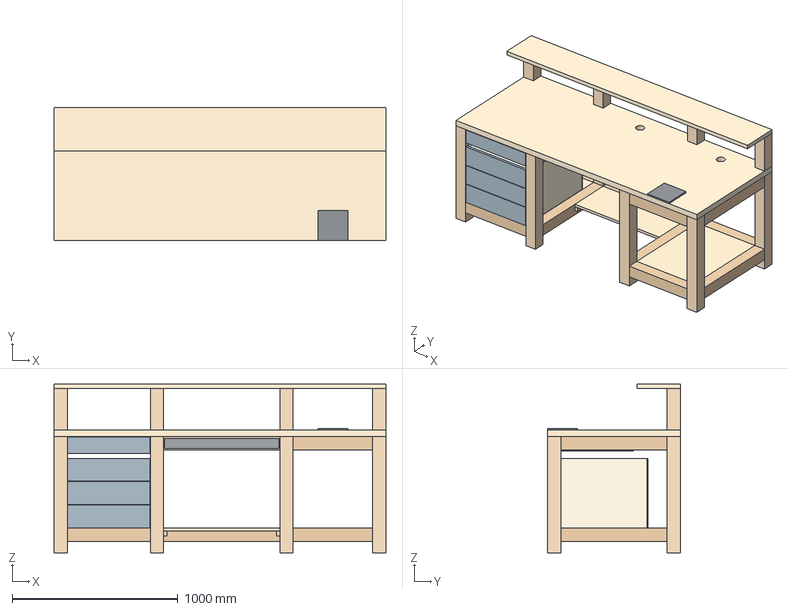
[picture p45: CAD file, 2026-10-18]
archivio/quadrotti-8x8/tavolo.step
2000.0 x 800.0 x 1017.0 mm
00_Gamba_1_ant
01_Gamba_1_post
02_Gamba_2_ant
03_Gamba_2_post
04_Gamba_3_ant
05_Gamba_3_post
06_Gamba_4_ant
07_Gamba_4_post
08_Trav_sup_post_cassetti
09_Trav_inf_post_cassetti
10_Trav_inf_ant_cassetti
11_Trav_sup_post_seduta
12_Trav_inf_post_seduta
13_Trav_sup_post_ricarica
14_Trav_inf_post_ricarica
15_Trav_sup_ant_ricarica
16_Trav_inf_ant_ricarica
17_Trav_sup_lat_1
18_Trav_inf_lat_1
19_Trav_sup_lat_2
20_Trav_inf_lat_2
21_Trav_sup_lat_3
22_Trav_inf_lat_3
23_Trav_sup_lat_4
24_Trav_inf_lat_4
25_Piano_di_lavoro
26_Rinforzo_piano_ricarica
27_Contropiastra_acciaio
28_Base_attacco_piastre
29_Ripiano_basso_cassetti
30_Listello_sx_-_Ripiano_basso_cassetti
31_Listello_dx_-_Ripiano_basso_cassetti
32_Ripiano_basso_ricarica
33_Listello_sx_-_Ripiano_basso_ricarica
34_Listello_dx_-_Ripiano_basso_ricarica
35_Ripiano_basso_post_seduta
36_Listello_sx_-_Ripiano_basso_post_seduta
37_Listello_dx_-_Ripiano_basso_post_seduta
38_Montante_mensola_1
39_Montante_mensola_2
40_Montante_mensola_3
41_Montante_mensola_4
42_Mensola_rialzata
43_Canalina_cassetti
44_Canalina_seduta
45_Canalina_ricarica
46_Ciabatta
47_Cassettiera_fianco_sx
48_Cassettiera_fianco_dx
49_Cassettiera_cielo
50_Cassettiera_fondo
51_Cassettiera_schienale
52_Frontale_cassetto_1
53_Cassetto_1_(scatola)
54_Frontale_cassetto_2
55_Cassetto_2_(scatola)
56_Frontale_cassetto_3
57_Cassetto_3_(scatola)
58_Frontale_cassetto_appeso
59_Cassetto_appeso_(scatola)
