abettarini/workbench/moduli/1-tavolo-base/tavolo_base.step

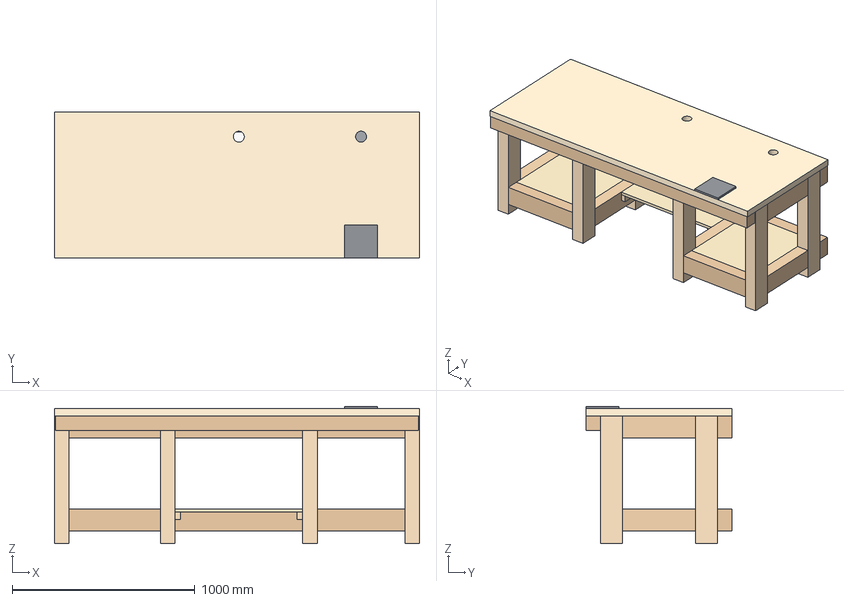
[picture p46: CAD file, 2026-10-18]
moduli/1-tavolo-base/tavolo_base.step
2000.0 x 800.0 x 752.0 mm
000_Gamba_1_ant
001_Gamba_1_post
002_Gamba_2_ant
003_Gamba_2_post
004_Gamba_3_ant
005_Gamba_3_post
006_Gamba_4_ant
007_Gamba_4_post
008_Trav_sup_lat_1
009_Trav_inf_lat_1
010_Trav_sup_lat_2
011_Trav_inf_lat_2
012_Trav_sup_lat_3
013_Trav_inf_lat_3
014_Trav_sup_lat_4
015_Trav_inf_lat_4
016_Fascia_post_alta
017_Fascia_post_bassa
018_Fascia_ant_alta
019_Trav_inf_ant_cassetti
020_Trav_inf_ant_ricarica
021_Piano_di_lavoro
022_Rinforzo_piano_ricarica
023_Contropiastra_acciaio
024_Base_attacco_piastre
025_Ripiano_basso_cassetti
026_Listello_reggiripiano_-_Ripiano_basso_cassetti_sx
027_Listello_reggiripiano_-_Ripiano_basso_cassetti_dx
028_Ripiano_basso_ricarica
029_Listello_reggiripiano_-_Ripiano_basso_ricarica_sx
030_Listello_reggiripiano_-_Ripiano_basso_ricarica_dx
031_Ripiano_basso_post_seduta
032_Listello_reggiripiano_-_Ripiano_basso_post_seduta_sx
033_Listello_reggiripiano_-_Ripiano_basso_post_seduta_dx
034_Canalina_cassetti
035_Canalina_seduta
036_Canalina_ricarica
037_Ciabatta
