abettarini/workbench/moduli/2-cassettiera/cassettiera.step

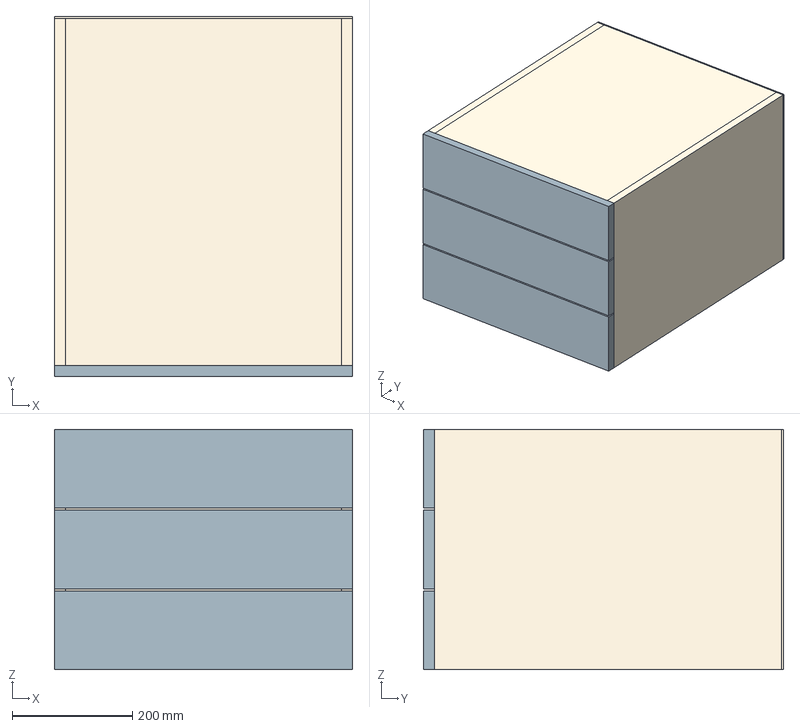
[picture p47: CAD file, 2026-10-18]
moduli/2-cassettiera/cassettiera.step
496.0 x 599.0 x 400.0 mm
000_Cassettiera_fianco_sx
001_Cassettiera_fianco_dx
002_Cassettiera_cielo
003_Cassettiera_fondo
004_Cassettiera_schienale
005_Frontale_cassetto_1
006_Cassetto_1_(scatola)
007_Frontale_cassetto_2
008_Cassetto_2_(scatola)
009_Frontale_cassetto_3
010_Cassetto_3_(scatola)
