abettarini/workbench/moduli/3-alzatina/alzatina.step

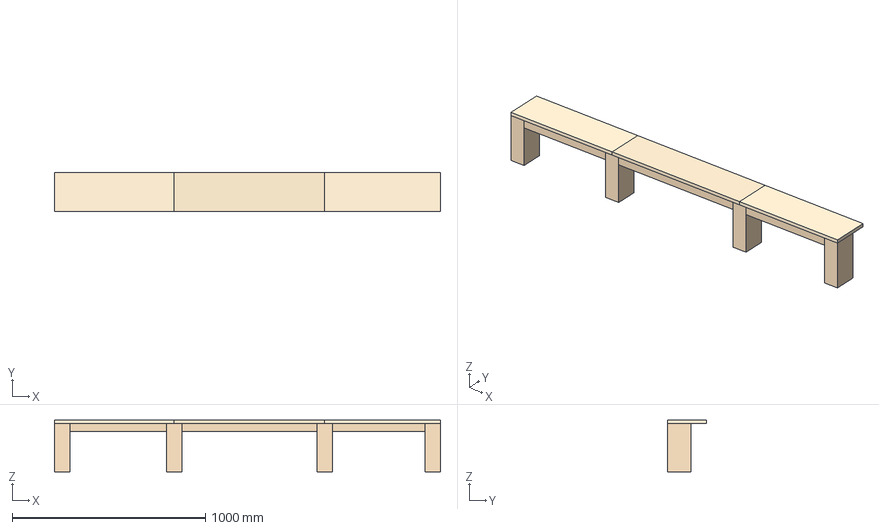
[picture p48: CAD file, 2026-10-18]
moduli/3-alzatina/alzatina.step
2000.0 x 200.0 x 268.0 mm
000_Montante_mensola_1
001_Montante_mensola_2
002_Montante_mensola_3
003_Montante_mensola_4
004_Mensola_-_tavola_1
005_Mensola_-_tavola_2
006_Mensola_-_tavola_3
007_Listello_mensola_1
008_Listello_mensola_2
009_Listello_mensola_3
