abettarini/workbench/(list of files, cad)

Other CAD files:
modello/tavolo_completo.step
