abettarini/workbench/moduli/2-cassettiera/cassettiera_manuale.pdf

# Cassettiera

## Modulo 2 del tavolo da lavoro – manuale di costruzione e montaggio

## Contenuto

Cosa serve

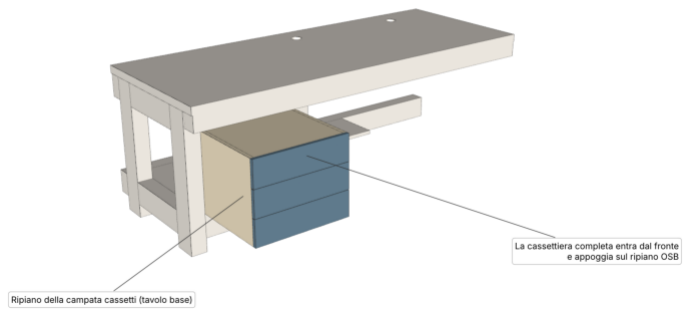
[picture p49: figure]

Fase 1 · Taglio dei pannelli

Fase 2 · Scatola della cassettiera

Fase 3 · Guide e cassetti

Fase 4 · Installazione nel tavolo Controlli finali

In breve

Cassettiera fissa con 3 cassetti per la

campata sinistra del tavolo (luce 500 mm), sotto la fascia anteriore del piano.

Si monta quando vuoi, anche dopo il tavolo: non servono fori o modifiche al telaio.

Costi nel file cassettiera_costi.xlsx.

materiale | pezzo | misure | n°
multistrato 18 | fianco sx | 578×400 | 1
multistrato 18 | fianco dx | 578×400 | 1
multistrato 18 | cielo | 578×460 | 1
multistrato 18 | fondo | 578×460 | 1
multistrato 18 | Frontale cass. 1 | 496×131 | 1
multistrato 18 | Frontale cass. 2 | 496×131 | 1
multistrato 18 | Frontale cass. 3 | 496×131 | 1
multistrato 15 | cass. 1: fianco | 500×85 | 2
multistrato 15 | cass. 1: testata | 405×85 | 2
multistrato 15 | cass. 2: fianco | 500×85 | 2
multistrato 15 | cass. 2: testata | 405×85 | 2
multistrato 15 | cass. 3: fianco | 500×85 | 2
multistrato 15 | cass. 3: testata | 405×85 | 2
pannello di fibra 3 | schienale | 496×400 | 1
pannello di fibra 3 | cass. 1: fondo | 500×435 | 1
pannello di fibra 3 | cass. 2: fondo | 500×435 | 1
pannello di fibra 3 | cass. 3: fondo | 500×435 | 1

# Cosa serve

Modulo 2 – Cassettiera per il tavolo da lavoro – manuale | pag. 2

## Materiali

- Multistrato pioppo 18 mm: 2 pannelli 1200×600 (scatola e

frontali)
- Multistrato pioppo 15 mm: 1 pannello 1200×600 (scatole dei

cassetti)
- Fibra grezza 3 mm: pannello 2500×1250 (fondi e schienale)
- 3 coppie di guide a sfera a estrazione totale, lunghezza 500

mm, spessore 12,7 mm
- 3 maniglie
- Viti: 4×45 (scatola), 3,5×30 (cassetti), 3×16 (fondi e

schienale), 3,5×25 (frontali), 4×16 (guide), 4×30 e 4×50 (fissaggio al tavolo)
- Colla vinilica D3, nastro biadesivo, 4 spessori da 2 mm

## Attrezzi

- Sega circolare con guida (o taglio a misura in negozio)
- Avvitatore, punte Ø2,5, Ø3, svasatore
- Morsetti, squadra, metro
- Levigatrice, carta 120–180

## Prerequisiti dal tavolo base

- Ripiano OSB della campata cassetti montato e avvitato ai

listelli.
- Nessuna lavorazione sul telaio: la cassettiera si avvita al

ripiano e alle gambe anteriori G1A e G2A.

## Elenco dei pezzi

Frontale 1 496×131 | Frontale 2 496×131
cielo 578×460 | fondo 578×460

Multistrato 18 – 1200×600 (n. 1)

fianco sx 578×400 | fianco dx 578×400

Frontale 3
496×131

Multistrato 18 – 1200×600 (n. 2)

c.3: testata 405×85 | c.3: testata 405×85
c.2: testata 405×85 | c.2: testata 405×85
c.1: testata 405×85 | c.1: testata 405×85
c.3: fianco 500×85 | c.3: fianco 500×85
c.2: fianco 500×85 | c.2: fianco 500×85
c.1: fianco 500×85 | c.1: fianco 500×85

Multistrato 15 – 1200×600 (n. 1)

cassetto 1: fondo
500×435

cassetto 2: fondo
500×435

cassetto 3: fondo
500×435

Cassettiera schienale
496×400

Fibra grezza 3 – 2500×1250

Taglio dei pannelli | Fase 1
Modulo 2 – Cassettiera per il tavolo da lavoro – manuale | pag. 3
- Le venature esterne del multistrato vanno in verticale su fianchi e frontali: tieni conto del verso quando tagli.
- I frontali dei cassetti sono affiancati sullo stesso pannello: le venature restano continue.
- Tolleranza ±0,5 mm. Se il negozio taglia a misura, porta questa pagina.
- Pannelli pretagliati Tecnomat 1200×600: servono 2 da 18 mm e 1 da 15 mm. Tecnomat taglia in negozio (1° taglio gratis, poi 1 €).
- Fondi in fibra da 3 mm: per carichi fino a ~15 kg per cassetto; per carichi maggiori usa MDF/HDF da 4–5 mm.

46

181

315

496

400

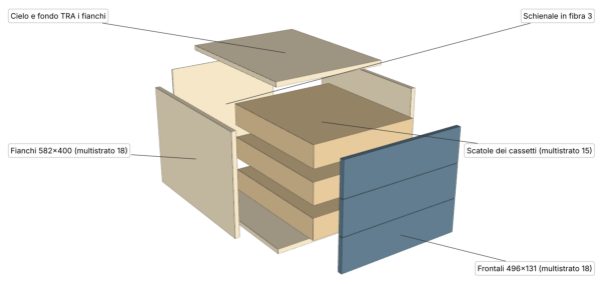
[picture p50: figure]

asse guide
dal fondo int.

Vista di fronte (senza frontali): viti 4×45 e asse delle guide

Scatola della cassettiera | Fase 2
Modulo 2 – Cassettiera per il tavolo da lavoro – manuale | pag. 4

Misure finite: 496 (largh.) × 400 (alt.) × 596 (prof. con

frontali).

1. Segna su fianchi, cielo e fondo i punti delle viti: a 9 mm

dal bordo (metà spessore), ogni 150 mm, 4 viti per giunto.
2. Cielo e fondo vanno TRA i due fianchi. Colla sulle testate,

accosta, stringi con i morsetti.
3. Preforo Ø3 attraverso il fianco e dentro il cielo/fondo per

30 mm, svasa, avvita 4×45.
4. Controlla la squadra (diagonali uguali) e appoggia lo schienale in fibra: avvitalo con 3×16 ogni 120 mm. Lo schienale tiene in squadra la scatola: fissalo prima che la

colla tiri.
5. Leviga gli spigoli e tratta la scatola (vernice o olio).

434.6

500

fondo in fibra

avvitato sotto

guida 12,7 | fronte

Scatola del cassetto vista dall'alto

Guide e cassetti | Fase 3
Modulo 2 – Cassettiera per il tavolo da lavoro – manuale | pag. 5

Guide sui fianchi (prima di inserire la cassettiera nel tavolo)
1. Traccia sui fianchi interni le linee dell'asse delle guide: 46,

181 e 315 mm dal piano del fondo interno.
2. Separa le guide (parte fissa e parte mobile). Avvita la parte fissa sul fianco, arretrata di 2 mm dal bordo anteriore, con viti

4×16 nelle asole: regolerai dopo.

Scatole dei cassetti (multistrato 15) – 435 × 500 × alt. 85
3. Le testate vanno TRA i fianchi. Colla + 2 viti 3,5×30 per

giunto, preforo Ø2,5, svasatura.
4. Controlla la squadra e avvita sotto il fondo in fibra con 3×16

ogni 100 mm: blocca la squadra.
5. Avvita la parte mobile delle guide sui fianchi della scatola, a metà altezza, a filo davanti.
6. Larghezza della scatola = luce interna − 2 × 12,7 = 434.6 mm.

Se le tue guide hanno uno spessore diverso, ricalcola prima di tagliare le testate.

Frontali
7. Inserisci i cassetti. Appoggia i frontali con biadesivo: il primo a filo del fondo, fughe di 3 mm tra un frontale e l'altro

(usa 2 monete o spessori).
8. Apri il cassetto e fissa ogni frontale dall'interno con 4 viti

3,5×25. Togli il biadesivo se dà fastidio.
9. Fora per le maniglie dall'esterno, con un pezzo di scarto dietro per non scheggiare.

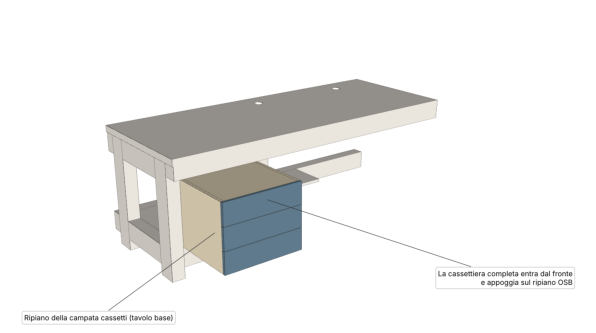
[picture p51: figure]
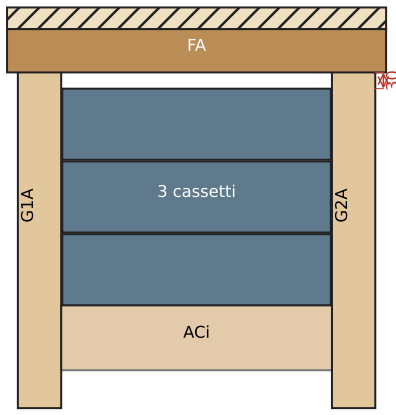
[picture p52: figure]
ACi; 3 cassetti

30

Vista frontale della campata cassetti

Installazione nel tavolo | Fase 4
Modulo 2 – Cassettiera per il tavolo da lavoro – manuale | pag. 6
1. Togli i cassetti. Infila la scatola nella campata sinistra

dal fronte, sotto la fascia anteriore FA, appoggiata sul ripiano OSB.
2. Frontali a filo della faccia anteriore delle gambe G1A e G2A

(80 mm dietro il bordo del piano): la fascia FA sporge sopra i cassetti come una visiera.
3. Centra la scatola: 2 mm di gioco per lato. Metti gli spessori da 2 mm tra fianco e gamba.
4. Fissala: 4 viti 4×30 dall'interno del fondo nel ripiano
(preforo Ø3) e 2 viti 4×50 per fianco dentro le gambe anteriori,

a 250 e 500 da terra e 60 mm dalla faccia anteriore della gamba (preforo Ø3).
5. Rimetti i cassetti e regola le guide nelle asole finché le

fughe sono uniformi; poi aggiungi le viti nei fori tondi.

Spazio libero: tra il cielo della cassettiera (quota 590) e la fascia FA (quota 620) restano 30 mm; i cassetti si aprono senza toccarla.

# Controlli finali

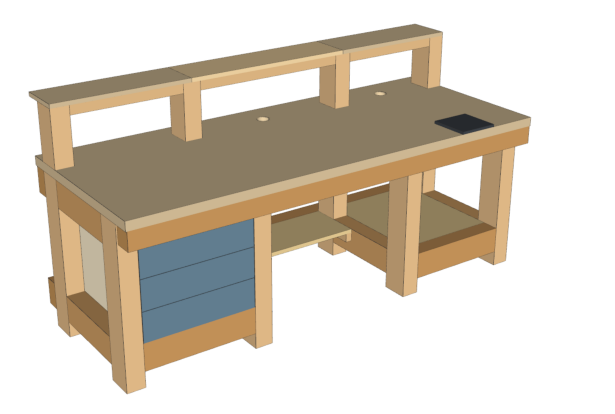
[picture p53: figure]

Modulo 2 – Cassettiera per il tavolo da lavoro – manuale | pag. 7

La scatola è in squadra: diagonali uguali entro 1 mm

Tutti i cassetti escono completamente e rientrano senza sfregare

Fughe tra i frontali uniformi (3 mm) e allineate ai bordi della scatola

I cassetti aperti non toccano la fascia anteriore FA

La cassettiera non si muove spingendola: viti nel ripiano e nelle gambe serrate

Carico per cassetto: fino a 25–30 kg con guide da 45 kg (non riempire di piombo un solo cassetto)
