abettarini/workbench/moduli/3-alzatina/alzatina_manuale.pdf

# Alzatina con mensola

## Modulo 3 del tavolo da lavoro – manuale di costruzione e montaggio

## Contenuto

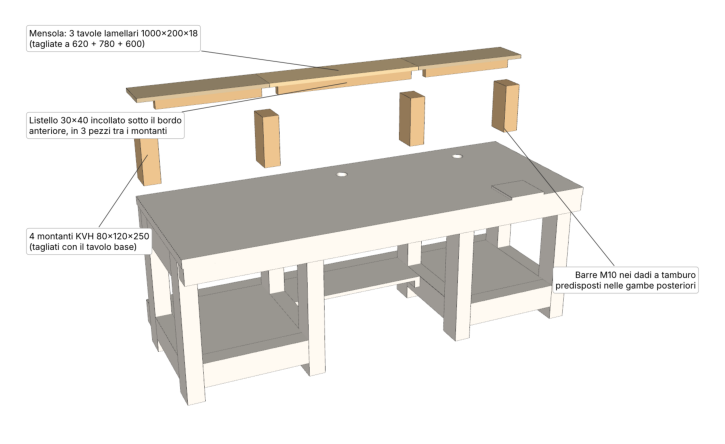
[picture p54: figure]

Cosa serve

Fase 1 · Taglio e foratura

Fase 2 · Mensola

Fase 3 · Montaggio sul tavolo

Fase 4 · Fissaggio a muro e controlli

In breve

Mensola lunga 2000, profonda 200, a 268 mm sopra il piano, su 4 montanti KVH 80×120 sopra le gambe posteriori; dietro arriva al muro.

Mensola: 3 tavole lamellari abete 1000×200×18 (Tecnomat) + listello 30×40 incollato sotto il bordo anteriore, in 3 pezzi tra i montanti.

Si monta sul tavolo base usando le predisposizioni: foro e dado a tamburo in ogni gamba posteriore.

Costi in alzatina_costi.xlsx.

# Cosa serve

Modulo 3 – Alzatina con mensola per il tavolo da lavoro – manuale | pag. 2

## Materiali

- 3 tavole lamellari abete 1000×200×18 (Tecnomat, 4,50 €

l'una)
- 1 listello abete 30×40 da 2000 → 3 pezzi da 500, 700 e 480
- 4 montanti KVH 80×120×250 (tagliati insieme alle travi del

tavolo base)
- 2 barre filettate M10 da 1 m → 4 spezzoni da 390
- 4 rondelle Ø30 + 4 dadi ciechi M10
- Viti 4×50 (listello), colla vinilica D3
- 2 staffe angolari 90×90 + viti 4×16 + tasselli Ø8

## Attrezzi

- Sega (troncatrice o circolare), seghetto per metalli
- Trapano con punta Ø12 normale e punta lunga Ø12 da 300
- Punta Ø3 e svasatore, avvitatore, chiave 17
- Morsetti, squadra, livella, metro

Perché tavole da 18 mm

La tavola lamellare 1000×200×18 di Tecnomat costa 4,50 € (prezzo verificato il 18/10/2026): meno della tavola OBI 800×200×14 (8,19 €), è più spessa e più lunga. Ogni pezzo della mensola

(massimo 780 mm) si ricava da una sola tavola.

Con il listello sotto il bordo anteriore la mensola è più rigida (circa +25%) della versione da 14 mm.

Prerequisiti dal tavolo base

- Nelle 4 gambe posteriori: foro Ø12 in testa e dado a tamburo

inserito dalla faccia laterale (lato campata), con il foro filettato in verticale.
- I 4 montanti M1–M4 tagliati e conservati.
- Il tavolo non va staccato dal muro: i dadi sono già dentro e

raggiungibili da sotto il piano.

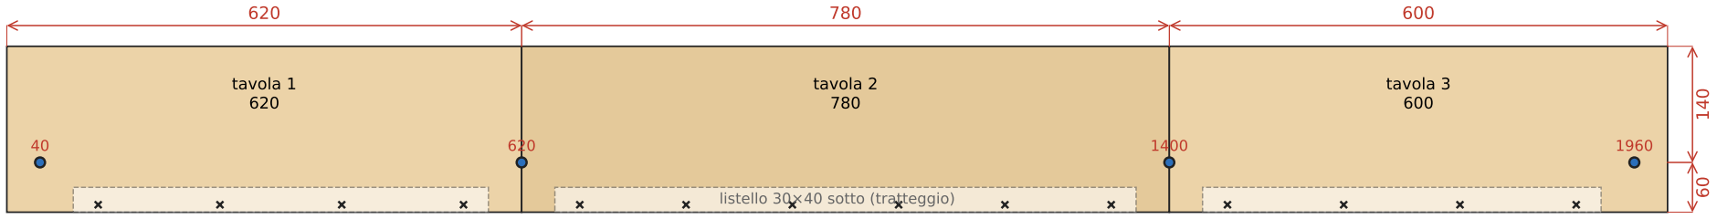
[picture p55: figure]
tavola 1 620; tavola 2 780; tavola 3 600; listello 30×40 sotto (tratteggio)

FRONTE della mensola – vista dall'alto · ✕ = viti 4×50 dal listello (ogni ~150, a 30 mm dalle estremità)

Taglio e foratura | Fase 1
Modulo 3 – Alzatina con mensola per il tavolo da lavoro – manuale | pag. 3

Taglio
1. Tavole a lunghezza: 620, 780 e 600 mm (tutte larghe 200). I giunti cadono al centro dei montanti 2 e 3. Tagli a 90° precisi: le teste si accostano a vista.
2. Listello 30×40 in 3 pezzi: 500, 700 e 480 mm (uno per campata, tra i montanti).
3. Barre M10: 4 spezzoni da 390 mm, due per barra. Smussa le estremità con la lima.

Foratura
4. Montanti (se non già fatto): foro Ø12 passante in asse, a 60 mm dal filo posteriore; fora 125 mm da ogni testa con la punta

lunga.
5. Mensola: i fori Ø12 si fanno in fase 2 a mensola incollata, così i fori sui giunti restano allineati.
6. Piano del tavolo: 4 fori Ø12 passanti a 660 dal fronte, x = 40, 620, 1400, 1960 da sinistra. Sono in asse con i fori delle gambe: fora dritto con la squadra di guida.

200

58

listello 30×40

tavola 18

Ø12

Sezione della mensola (fronte a sinistra)

Mensola | Fase 2

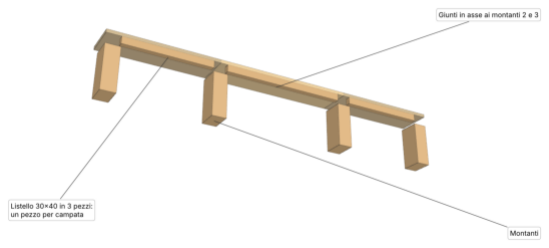
[picture p56: figure]

Modulo 3 – Alzatina con mensola per il tavolo da lavoro – manuale | pag. 4
1. Lavora su un piano dritto (anche il tavolo base). Disponi le 3 tavole a rovescio, testa contro testa, e controlla con il listello che siano in linea.
2. Stendi la colla sui 3 pezzi di listello e appoggiali a filo

del bordo ANTERIORE (che ora è verso di te, a rovescio), uno per campata: da 80, 660 e 1440 mm dall'estremità sinistra. Restano liberi i tratti dove appoggiano i montanti.
3. Viti 4×50 dal listello nella tavola ogni 150 mm, a 15 mm dal bordo: preforo Ø3 nel listello, svasatura. La vite entra
10 mm nella tavola da 18: non usare viti più lunghe.
4. I giunti tra le tavole cadono sui montanti 2 e 3: ogni
tavola appoggia per 40 mm sul montante e la barra con rondella Ø30 le stringe entrambe.
5. A colla asciutta, gira la mensola. Fora Ø12 nei 4 punti (60
dal bordo anteriore): sui giunti il foro è metà in una tavola
e metà nell'altra, va bene così. La rondella e il dado cieco le stringeranno entrambe.
6. Leviga (120–180), smussa gli spigoli e tratta con olio.

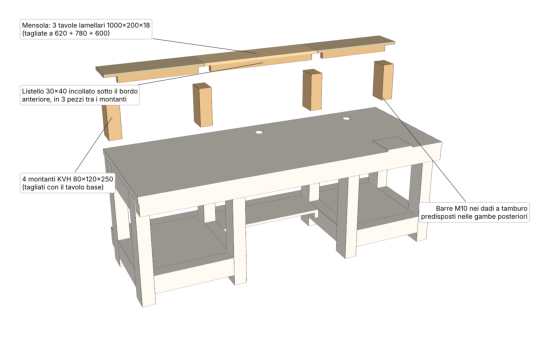
[picture p57: figure]

Sezione: barra M10 da 390 dal dado alla mensola

Montaggio sul tavolo | Fase 3

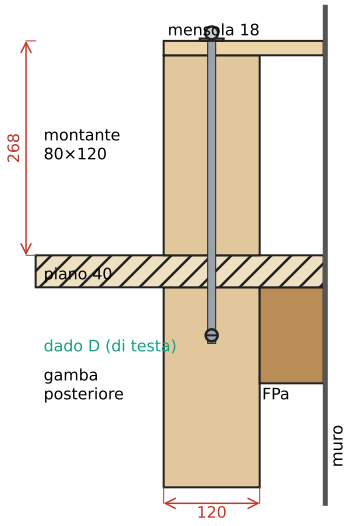
[picture p58: figure]
muro; mensola 18; montante 80×120; piano 40; gamba posteriore; dado D (di testa); FPa

Modulo 3 – Alzatina con mensola per il tavolo da lavoro – manuale | pag. 5
1. Fora il piano (fase 1, punto 6) e pulisci i trucioli dal
foro della gamba.
2. Prova ogni posizione: infila una barra nel foro del piano e

avvitala di qualche giro nel dado a tamburo della gamba. Se non prende, il dado è ruotato: vedi il riquadro.
3. Appoggia i montanti M1–M4 sul piano, esattamente sopra le gambe posteriori (dietro restano 80 mm fino al bordo).
4. Appoggia la mensola sui montanti, a filo del bordo

posteriore del piano e ai lati.
5. Infila le barre da 390 dall'alto: attraversano mensola,

montante e piano. Avvitale nel dado ruotando la barra con due dadi bloccati uno contro l'altro in cima, poi toglili.
6. Rondella Ø30 e dado cieco sopra la mensola. Stringi con moderazione: la tavola è sottile, basta che il montante non giri.
7. Controlla con la livella che la mensola sia piana; se serve, spessori sotto un montante.

Se la barra non entra nel dado

Il foro filettato del dado non

è verticale. Da sotto il
piano, gira il dado dalla
fessura sulla faccia laterale della gamba con un cacciavite piatto finché la barra prende

(togli la canalina se è
d'intralcio).

Fissaggio a muro e controlli | Fase 4

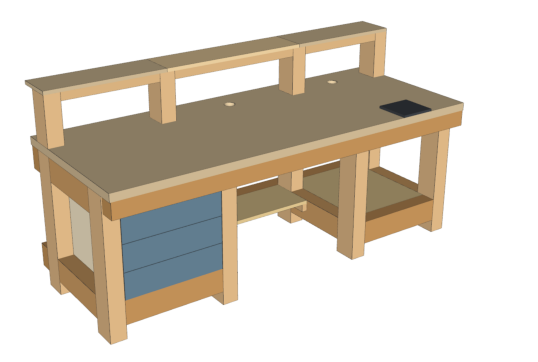
[picture p59: figure]

Modulo 3 – Alzatina con mensola per il tavolo da lavoro – manuale | pag. 6

Fissaggio a muro
1. 2 staffe angolari 90×90 sotto la mensola, contro il muro, a 100 mm

dalle estremità (vicino a M1 e M4): viti 4×16 nella mensola (è spessa 18: non usare viti più lunghe), tasselli Ø8 nel muro.
2. Non sostituisce il fissaggio a muro del tavolo base: lo completa e

impedisce alla mensola di oscillare.

Carichi consigliati
- Fino a 20 kg per campata tra due montanti (monitor, alimentatore da

banco, oscilloscopio).
- Carichi concentrati pesanti (oltre 10 kg in un punto): mettili

vicino a un montante.
- Non appoggiarsi né salire sulla mensola.

### Controlli finali

I 4 dadi ciechi sono serrati e i montanti non ruotano

La mensola è in bolla e a filo del bordo posteriore

I giunti tra le tavole sono chiusi e a livello

Con 10 kg al centro della campata più lunga la mensola non flette in modo

visibile
Staffe a muro serrate
