abettarini/workbench/moduli/1-tavolo-base/tavolo_base_manuale.pdf

# Tavolo da lavoro

# Modulo 1 · Tavolo base – manuale di lavorazione e montaggio

# Contenuto

## Prima di iniziare · Ferramenta · Distinta materiali (BOM)

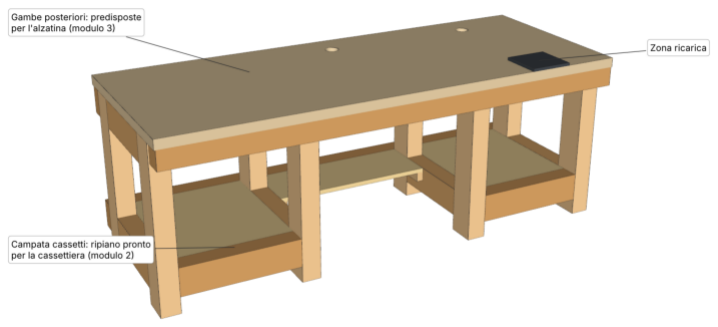
[picture p60: figure]

## Codici dei pezzi · Viste quotate

## Fase 1 · Taglio

## Fase 2 · Foratura (gambe, traverse, fasce, piano) Fase 3 · Levigatura e finitura

## Fase 4 · Telai laterali

## Fase 5 · Traverse basse e fasce

## Fase 6 · Listelli e ripiani bassi

## Fase 7 · Piano

## Fase 8 · Zona ricarica Fase 9 · Piedini, fissaggio a muro, predisposizioni

## Fase 10 · Canaline, elettrico e controlli finali

## Moduli aggiuntivi (manuali separati):

## Modulo 2 · Cassettiera

## Modulo 3 · Alzatina con mensola

Struttura: 4 telai laterali imbullonati uniti da 3 fasce a tutta lunghezza avvitate.
Quote in mm. Ogni foro è stato verificato sul modello 3D: nessun foro ne interseca un altro

(minimo 7,5 mm di legno tra due fori).

# Prima di iniziare

Modulo 1 – Tavolo base KVH 80×120 – manuale di lavorazione e montaggio | pag. 2

# Attrezzi

- Troncatrice o sega circolare con guida (tagli a 90° precisi;

## le fasce sono lunghe 1990) - Trapano a colonna oppure guida per trapano (fori

## perpendicolari) - Punte legno: Ø3, Ø5, Ø9, Ø11, Ø12; punta lunga Ø12 da 300

## mm; punta Ø5 da almeno 120 mm - Punte Forstner: Ø15, Ø25, Ø35; sega a tazza Ø60; svasatore - Avvitatore con inserto TX40 (viti 8×160), chiave a brugola 8

## (TCEI M10), chiave 17 - Cacciavite piatto largo (per orientare i dadi a tamburo) - 4 morsetti da almeno 600 mm + 2 morsetti lunghi o cinghie

## per le fasce - Squadra, metro, matita, livella - Levigatrice orbitale con carte 80 – 120 – 180 - Colla vinilica D3, pennello, stracci

# Verifica prima di tagliare e forare

### 1. Sezione reale delle travi: devono essere 80×120. Se misurano 78×118 le quote dei fori restano valide (sono riferite alla testa e all'asse dei pezzi), ma ricontrolla

campate e profondità.

### 2. Lunghezza delle barre: le fasce sono 1990 perché da una

barra da 4000 ne escono due (taglio 4 mm + rifilatura 10).

### Se le barre sono più corte di 4000, accorcia tutte e tre le

fasce della stessa misura.

### 3. Morale 80×80 della fascia anteriore: è grezzo, meno preciso del KVH (±2–3 mm). Scegline uno dritto, secco e

senza fessure, e levigalo bene: sta sotto le mani.

### 4. Dado a tamburo: non lo vendono Tecnomat, OBI e Leroy Merlin (ferramenta o online). Il manuale usa Ø15: se il tuo

è Ø14 o Ø16 usa la Forstner dello stesso diametro.

### 5. Piedini: le gambe sono da 700 mm e il piano finito è a

### 740 senza piedini. Per restare a 740 con i piedini, accorcia tutte le gambe dal lato del PIEDE: le quote dei fori 'dalla

testa' non cambiano.
6. Il muro: tipo (pieno, forato, cartongesso) e battiscopa,
Convenzioni del manuale | che può allontanare il tavolo dal muro.

## - Fronte = lato dove ti siedi. Sinistra/destra viste stando

seduto davanti al tavolo.
- Gambe numerate da 1 (sinistra) a 4 (destra); A = anteriore,
P = posteriore: G1A … G4P.

## - Traverse laterali L1s…L4i (s = alta, i = bassa); traverse

basse anteriori ACi e ARi; fasce FA, FPa, FPb.

## - Quote dei fori nelle gambe 'dalla testa' (estremità alta) e

'da sinistra' guardando quella faccia da fuori.

## - Nelle traverse le quote sono dal filo superiore del pezzo e

dalla testata.

## - Passante = il foro attraversa tutto il pezzo; il punto di

uscita è indicato con l'apice (es. 3').

## Come sta in piedi il tavolo

### - 4 TELAI LATERALI: gamba anteriore + gamba posteriore + traversa

### laterale alta e bassa. Nodi con bullone M10 + dado a tamburo + 2

spine Ø12 (bullone a 90 dalla testa della traversa, spine a 35).

### - 3 FASCE a tutta lunghezza li uniscono: FPa e FPb dietro, di

coltello, contro il muro; FA davanti, in morale di abete 80×80,

### sotto il bordo del piano. Ogni fascia si avvita a ogni gamba con 2 viti 8×160 perpendicolari: lavorano nel legno di fianco, tengono

molto e si possono togliere e rimettere.

### - 2 traverse basse anteriori ACi e ARi chiudono le campate dei

ripiani.

### - Il piano avvitato e il fissaggio a muro completano la rigidezza:

indispensabili per le presse.

fessura per
cacciavite

inserto + piedino

asola

# Ferramenta – codici usati nel manuale

Modulo 1 – Tavolo base KVH 80×120 – manuale di lavorazione e montaggio | pag. 3

## B1 Vite M10×180 testa cilindrica (TCEI) + rondella Ø20

### Quantità: 16

traverse laterali (L) dei 4 telai: dalla
faccia esterna della gamba

## B2 Vite M10×140 testa cilindrica (M10×180 accorciata) + rondella

### Quantità: 4

traverse basse anteriori ACi e ARi

## D Dado a tamburo M10 (Ø15 circa)

### Quantità: 24

20 nelle testate delle traverse + 4 nelle gambe posteriori (predisposizione alzatina)

## S Spina in faggio Ø12×50

### Quantità: 40

2 per testata di traversa

## V Vite strutturale per legno 8×160 (Rothoblaas TPS)

### Quantità: 24

fasce FA, FPa, FPb: 2 per gamba,
perpendicolari

## I Dado ragno M10 (o inserto filettato) + piedino M10

### Quantità: 8

sotto ogni gamba

## Q Squadretta con asola + viti 4,5×25

### Quantità: 16

fissaggio del piano a fasce e traverse

laterali alte

## W Viti legno: 5×60, 5×70, 4×35, 4,5×25

### Quantità: sfuse

rinforzo ricarica, listelli, ripiani,
squadrette

## X Viti TSPEI M10 + dadi autobloccanti + rondelle larghe

### Quantità: 2+2

base piastre ricarica: 2 × M10×160
(anteriori) e 2 × M10×110

## K Tassello per telai Ø10 L 160 con vite

### Quantità: 4

fissaggio a muro attraverso la fascia

posteriore alta

Colla vinilica D3 per spine, rinforzo e listelli. Prezzi e negozi nella distinta materiali (pagina seguente) e nel foglio tavolo_base_costi.xlsx.

categoria | articolo | uso | q.tà | negozio | € cad. | € tot. | verificato
Legno | Trave legno massiccio strutturale KVH giuntato 80×120×4000 | gambe, traverse laterali, 2 fasce posteriori da 1990, traverse basse anteriori e i 4 montanti dell'alzatina | 4 pz | Tecnomat | 29.90 | 119.60 | sì
Legno | Morale abete grezzo 80×80×4000 | fascia anteriore FA da 1990 (avanzano ~2 m) | 1 pz | Tecnomat | 13.90 | 13.90 | sì
Legno | Tavola abete lamellare 2000×800×40 | piano di lavoro (intero) | 1 pz | Tecnomat | 79.00 | 79.00 | sì
Legno | OSB 3 pioppo 18 mm 2500×1250 | 3 ripiani bassi + rinforzo ricarica (2 strati) | 1 pz | Tecnomat | 27.50 | 27.50 | sì
Legno | Listello abete grezzo 30×40×2000 | reggiripiano: 4 × 520 + 2 × 260 | 2 pz | Tecnomat | 3.10 | 6.20 | sì
Ferramenta telaio | Vite a testa cilindrica zincata M10×180 (B1 + B2) | 16 traverse laterali (B1) + 4 traverse basse anteriori (B2, accorciate a 140) | 20 pz | OBI | 1.39 | 27.80 | sì
Ferramenta telaio | Dado a tamburo M10 (D) | 20 testate di traversa + 4 predisposizione alzatina | 24 pz | ferramenta/online | 0.80 | 19.20 | stima
Ferramenta telaio | Viti legno SNK TPS Rothoblaas 8×160, conf. 100 pz (V) | fasce sulle gambe: 2 per gamba per fascia (24) | 1 conf | Tecnomat | 27.45 | 27.45 | sì
Ferramenta telaio | Spine in faggio zigrinato Ø12, conf. 25 pz | 2 per testata (40) | 2 conf | OBI | 3.69 | 7.38 | sì
Ferramenta telaio | Collante vinilico D3 Tover 500 ml | spine, rinforzo, listelli | 1 pz | Tecnomat | 4.95 | 4.95 | sì
Ferramenta telaio | Piede regolabile Ø40 vite M10, conf. 2 pz | sotto le gambe | 4 conf | Tecnomat | 1.65 | 6.60 | sì
Ferramenta telaio | Dado ragno M10 zincato (al posto dell'inserto a vite) | sede filettata sotto ogni gamba | 8 pz | OBI | 2.79 | 22.32 | sì
Ferramenta telaio | Squadretta a L 30×38×30 zincata | fissaggio del piano | 16 pz | Tecnomat | 0.50 | 8.00 | sì
Ferramenta telaio | Viti legno assortite (5×60, 5×70, 4×35, 4×50, 4,5×25) | rinforzo, listelli, ripiani, squadrette | 1 set | Tecnomat | 15.00 | 15.00 | stima
Ferramenta telaio | Tassello per telai Ø10 con vite, L 160 | fissaggio a muro attraverso la fascia posteriore alta (4) | 4 pz | Tecnomat | 1.20 | 4.80 | stima

# Distinta materiali e costi (BOM) 1/2

Modulo 1 – Tavolo base KVH 80×120 – manuale di lavorazione e montaggio | pag. 4

Prezzi letti sui siti di Tecnomat, OBI e Leroy Merlin il 18/10/2026 (negozio di riferimento Tecnomat Roma Prenestina). Righe gialle = stime. Link ai prodotti nel file tavolo_base_costi.xlsx.

categoria | articolo | uso | q.tà | negozio | € cad. | € tot. | verificato
Zona ricarica | Piastre acciaio tagliate e forate (base 180×180×12, contropiastra 220×220×6, 3 piastre attrezzo) | attacco presse e morsa | 1 lotto | officina/carpenteria | 90.00 | 90.00 | stima
Zona ricarica | Vite TSPEI M10×110 + dado autobloccante | base, 2 posteriori | 2 pz | ferramenta/online | 1.50 | 3.00 | stima
Zona ricarica | Vite TSPEI M10×160 + dado autobloccante | base, 2 anteriori (attraversano piano e fascia anteriore) | 2 pz | ferramenta/online | 1.80 | 3.60 | stima
Zona ricarica | Dadi autobloccanti M10 inox, conf. 10 pz | sotto la base | 1 conf | Tecnomat | 2.40 | 2.40 | sì
Zona ricarica | Rondelle piane larghe M10 (Ø29,5), conf. 8 pz | sotto la fascia anteriore e la contropiastra | 1 conf | Leroy Merlin | 2.50 | 2.50 | sì
Zona ricarica | Manopole a stella M12 + 2 spine Ø10 h8 | bloccaggio piastre | 1 kit | ferramenta/online | 10.00 | 10.00 | stima
Elettrico | Canalina di distribuzione Arnocanali 60×40, 2 scomparti | una per campata (da tagliare) | 3 pz | Tecnomat | 8.55 | 25.65 | sì
Elettrico | Bocchette passacavi Ø60 PVC nero, conf. 2 pz | piano | 1 conf | Tecnomat | 1.05 | 1.05 | sì
Elettrico | Ciabatta 6 prese con interruttore | campata seduta | 1 pz | Tecnomat | 20.00 | 20.00 | stima
Finitura | Olio Adler facile applicazione interno 750 ml | piano di lavoro | 1 pz | Tecnomat | 27.90 | 27.90 | sì
Finitura | Impregnante legno all'acqua Cipir 0,75 l incolore | telaio e ripiani OSB | 1 pz | Tecnomat | 6.70 | 6.70 | sì
Finitura | Abrasivi 80–120–180 | levigatura | 1 set | Tecnomat | 8.00 | 8.00 | stima

# Distinta materiali e costi (BOM) 2/2

Modulo 1 – Tavolo base KVH 80×120 – manuale di lavorazione e montaggio | pag. 5

## TOTALE modulo 1: 590.50 € (prezzi verificati 416.90 € · stime 173.60 €)

Prezzi letti sui siti di Tecnomat, OBI e Leroy Merlin il 18/10/2026 (negozio di riferimento Tecnomat Roma Prenestina). Righe gialle = stime. Link ai prodotti nel file tavolo_base_costi.xlsx.

G1A | G2A | G3A | G4A
G1P | cassetti | G2P | seduta | G3P | ricarica | G4P

L1s/i

L2s/i

L3s/i

L4s/i

ACi | ARi

FPa / FPb

FA

### FRONTE (seduta)

### RETRO (muro)

## Pianta del telaio (vista dall'alto) – ACi e ARi tratteggiate (sono in basso)

pezzo | lungh. | n° | codici
gamba | 700 | 8 | G1A, G1P, G2A, G2P G3A, G3P, G4A, G4P
fascia posteriore (KVH) | 1990 | 2 | FPa, FPb
fascia anteriore (morale 80×80) | 1990 | 1 | FA
traversa laterale | 400 | 8 | L1s, L1i, L2s, L2i L3s, L3i, L4s, L4i
traversa bassa anteriore | 500 | 1 | ACi
traversa bassa anteriore | 480 | 1 | ARi
montante alzatina (conservare) | 250 | 4 | M1, M2, M3, M4

# Codici dei pezzi

Modulo 1 – Tavolo base KVH 80×120 – manuale di lavorazione e montaggio | pag. 6

Appena tagliato ogni pezzo, scrivi il codice a matita su una faccia che resterà nascosta (gambe: la testa; traverse: la faccia inferiore; fasce: la faccia verso l'interno) e una freccia verso il FRONTE.

Sezioni: gambe e traverse laterali 80 (largh.) × 120 (prof./altezza); fasce posteriori 80 × 120 di coltello; fascia anteriore in morale di abete 80 × 80 (unico pezzo non in KVH); ACi e ARi 80 × 120 di coltello.

Gli altri pezzi hanno il loro nome: Piano (lamellare), Rinforzo, Ripiano cassetti, Ripiano ricarica, Ripiano seduta (tutti in OSB), Listelli reggiripiano. I 4 montanti M1–M4 non servono al tavolo base: tagliali, marcali e

conservali per l'alzatina (modulo 3).

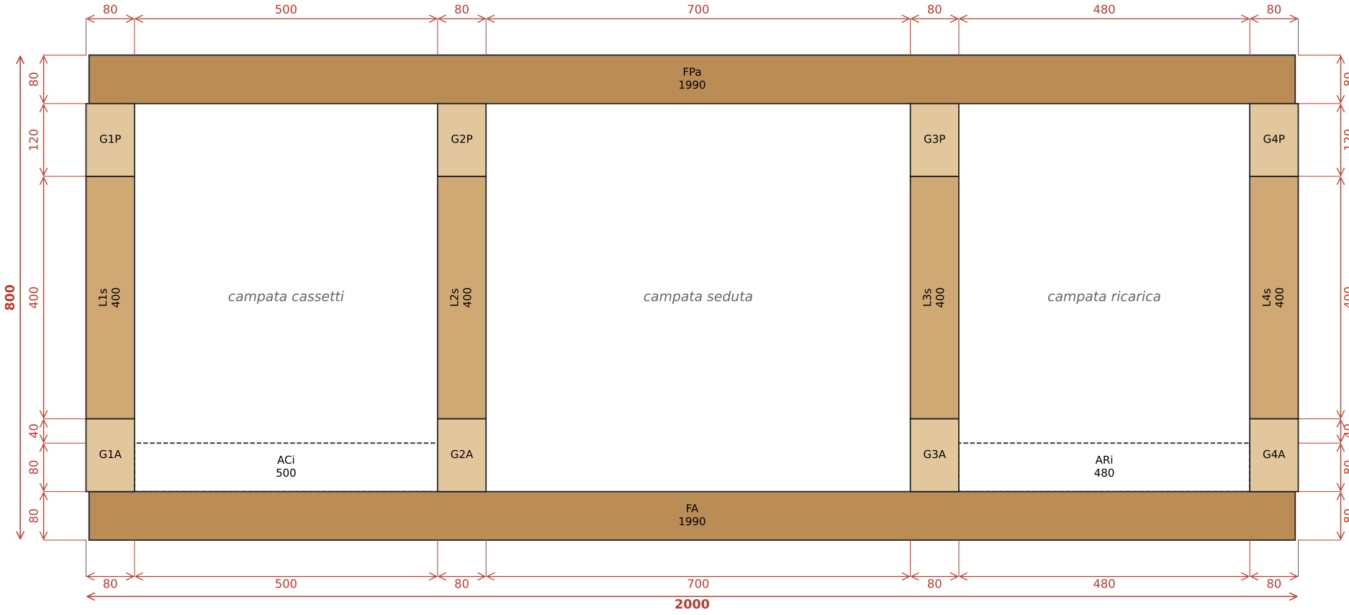
[picture p61: figure]
ACi 500; ARi 480; FPa 1990

80 80 40 400 120 80

### FRONTE

### RETRO (muro)

campata cassetti | campata seduta | campata ricarica

# Pianta del telaio quotata (senza piano)

Modulo 1 – Tavolo base KVH 80×120 – manuale di lavorazione e montaggio | pag. 7

Pezzi alti pieni, pezzi solo bassi (ACi, ARi) tratteggiati. FA = fascia anteriore (morale 80×80), FPa/FPb = fasce posteriori alta e bassa (sovrapposte in pianta). Codice e lunghezza su ogni pezzo.

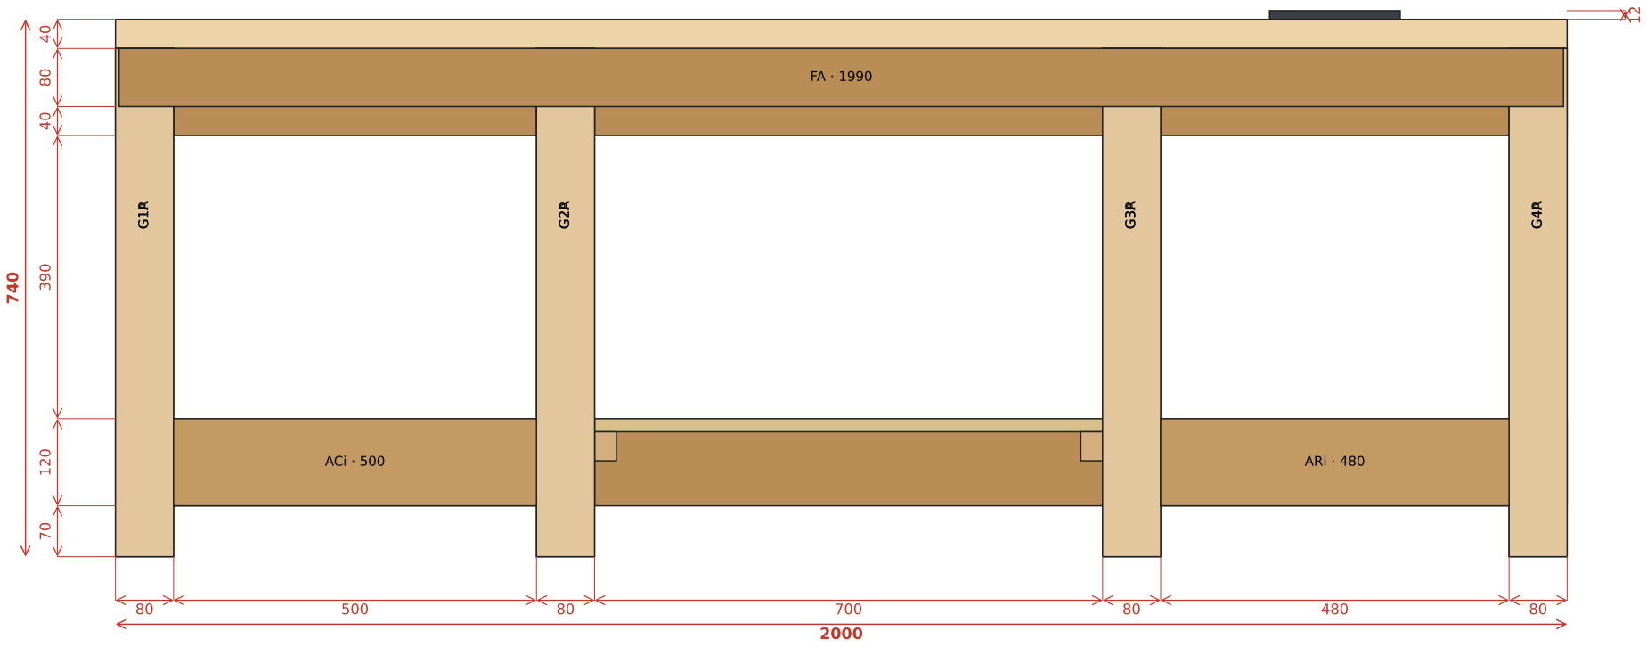
[picture p62: figure]
ACi · 500; ARi · 480

### vista da DAVANTI

# Prospetto anteriore quotato

Modulo 1 – Tavolo base KVH 80×120 – manuale di lavorazione e montaggio | pag. 8

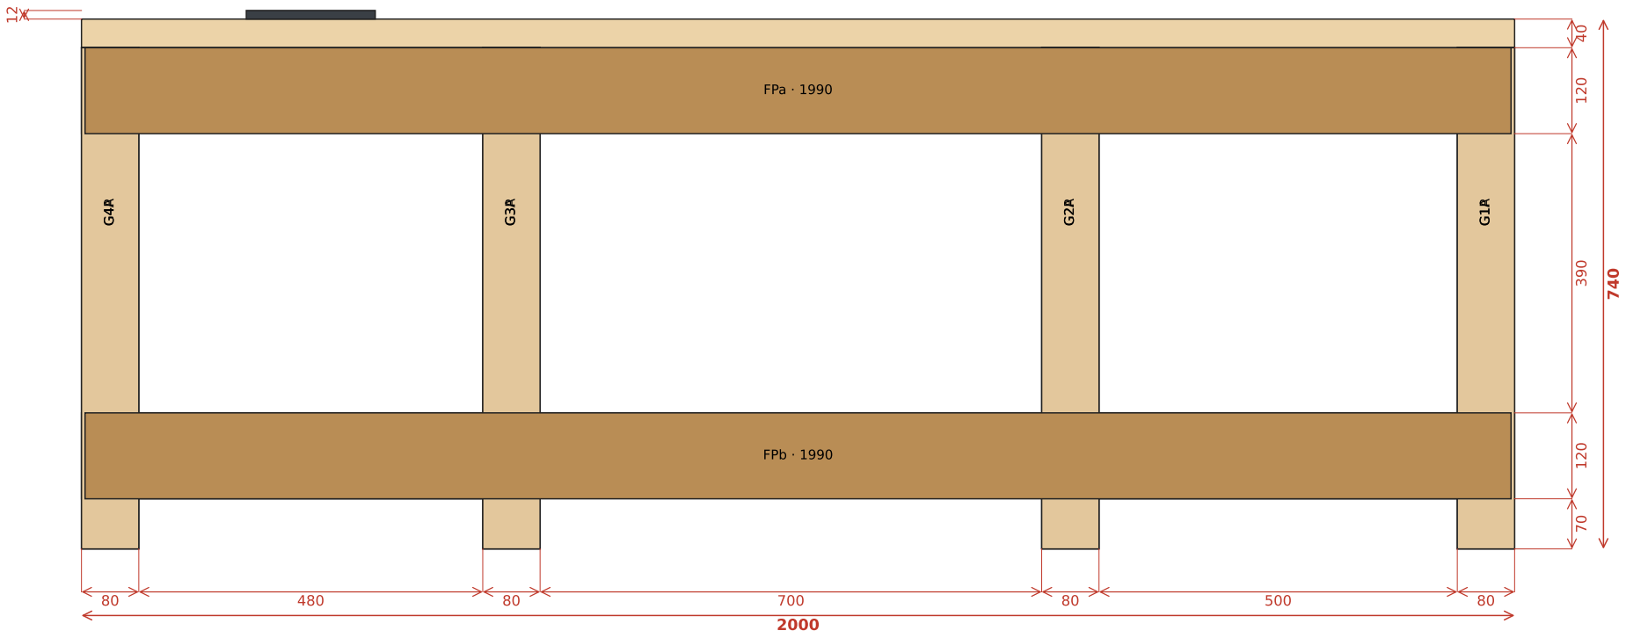
[picture p63: figure]
FPa · 1990; FPb · 1990

### vista da DIETRO (lato muro)

# Prospetto posteriore quotato

Modulo 1 – Tavolo base KVH 80×120 – manuale di lavorazione e montaggio | pag. 9

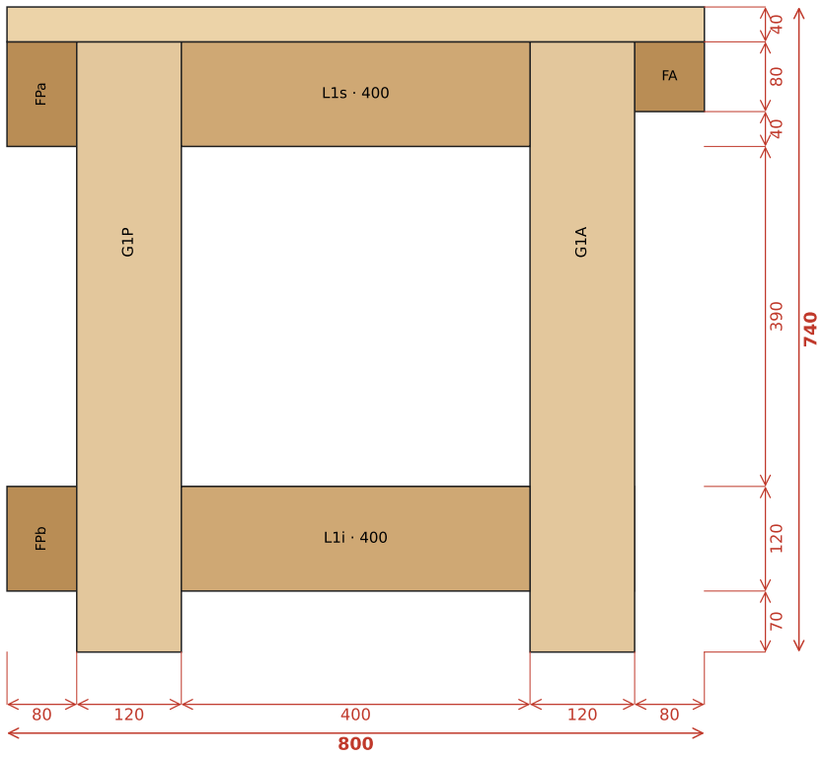
[picture p64: figure]
FPa FPb

### fianco SINISTRO (fronte a destra)

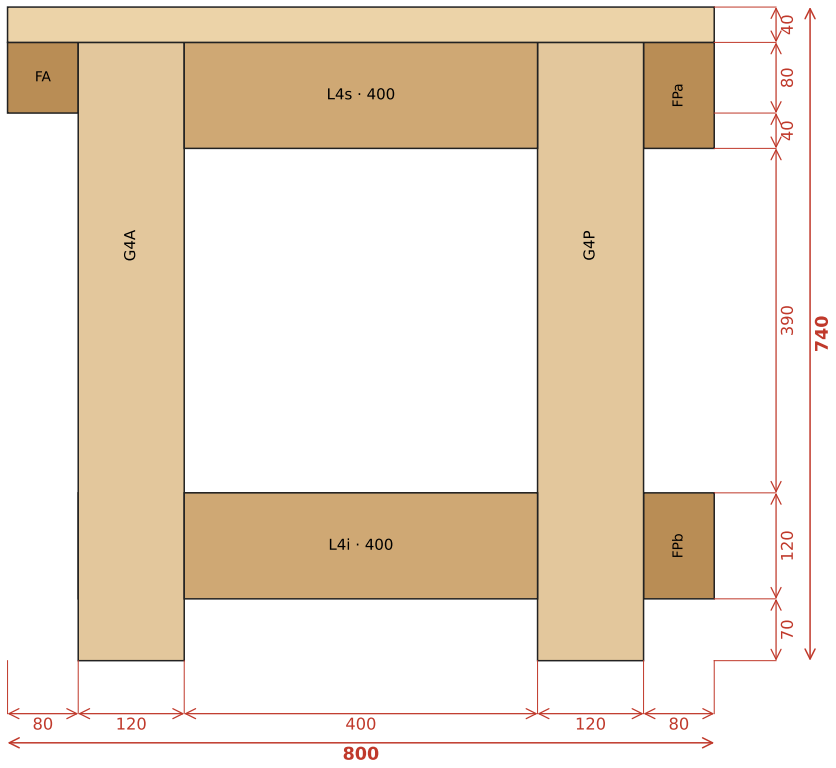
[picture p65: figure]
FPa FPb

### fianco DESTRO (fronte a sinistra)

# Fianchi quotati

Modulo 1 – Tavolo base KVH 80×120 – manuale di lavorazione e montaggio | pag. 10

# Pianta del piano quotata

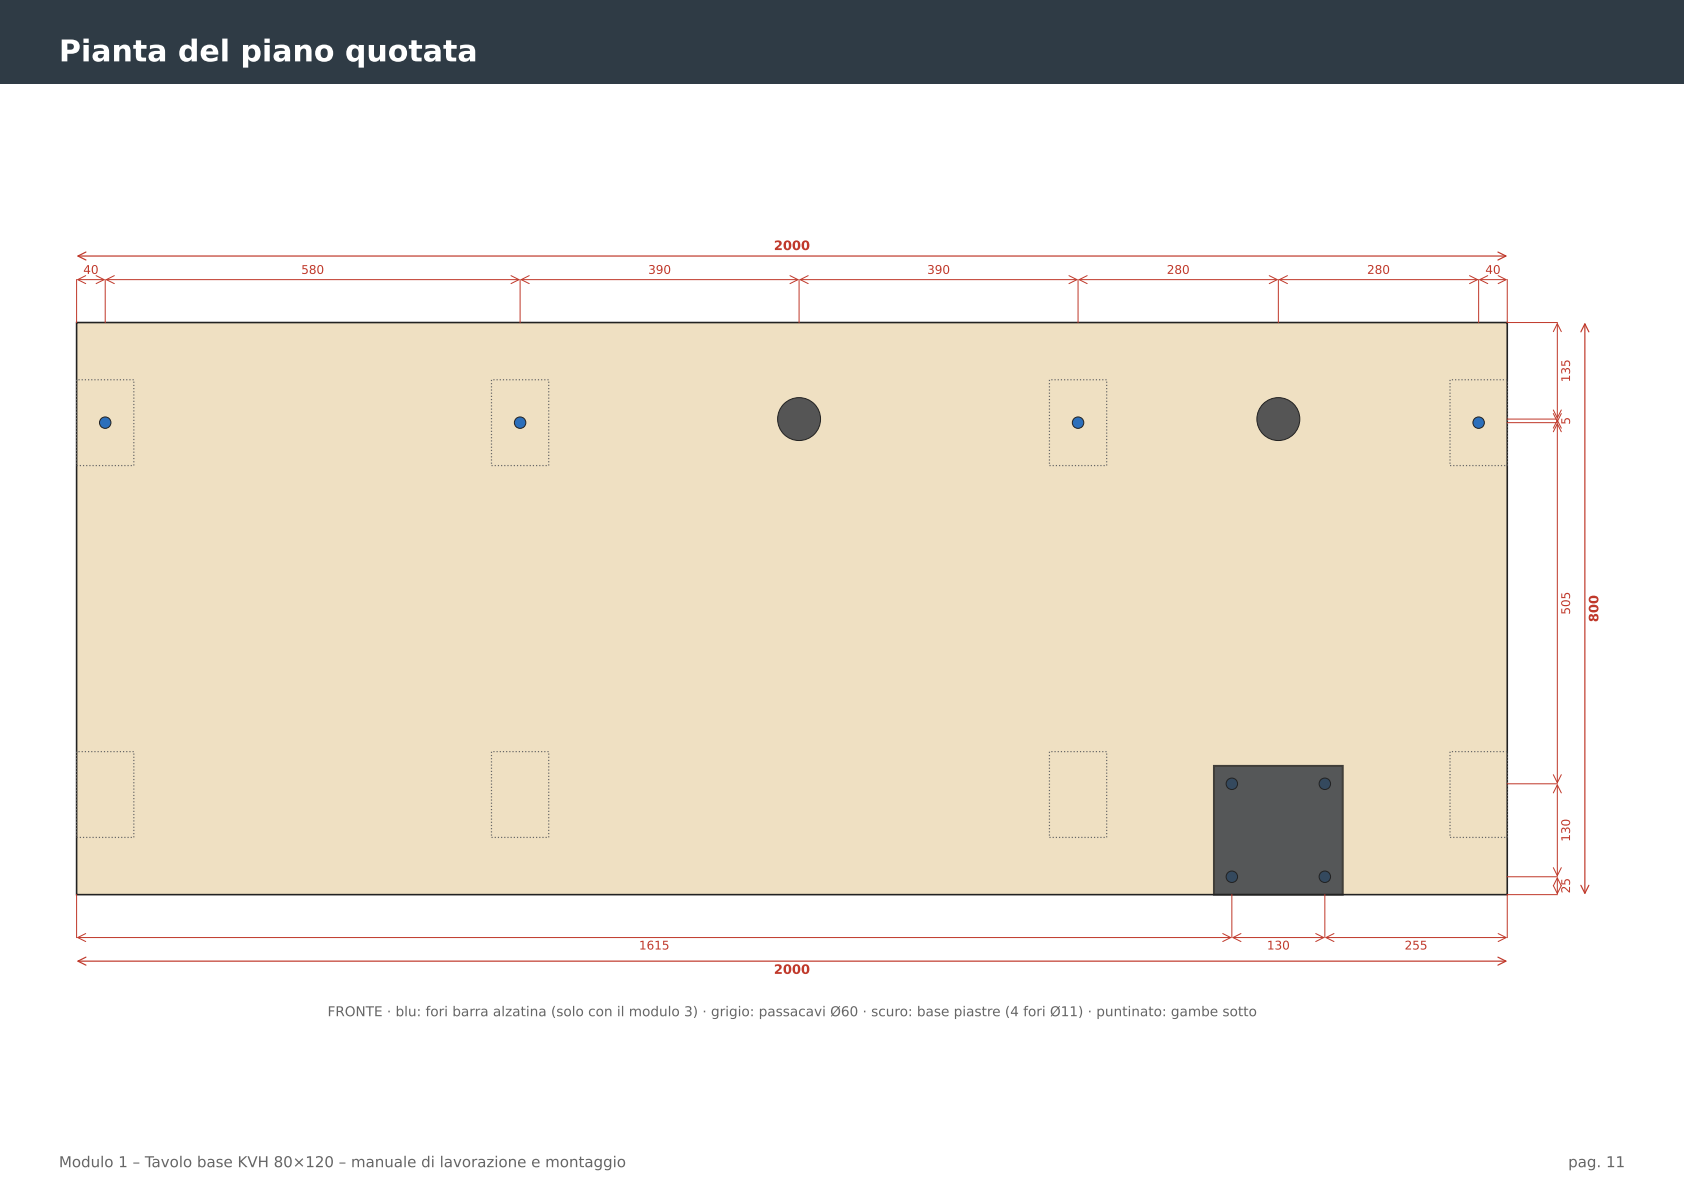
[picture p66: page 11]
Modulo 1 – Tavolo base KVH 80×120 – manuale di lavorazione e montaggio; pag. 11

FRONTE · blu: fori barra alzatina (solo con il modulo 3) · grigio: passacavi Ø60 · scuro: base piastre (4 fori Ø11) · puntinato: gambe sotto

Barra 1 | FPa
| 1990

FPb

1990

avanzo 2

Barra 2 | G1A
| 700

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
avanzo 366

Barra 3 | G3A
| 700

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
avanzo 366

## Travi KVH 80×120 da 4 m (4 barre) – grigio: 10 mm di rifilatura della testa; taglio 4 mm

Barra 4; ACi; ARi; avanzo 370

Ripiano cassetti 500×560 | Ripiano ricarica 480×560
Rinforzo A 480×520 | Rinforzo B 480×520

Ripiano seduta 700×260

avanzo ≈ 1,7 m²

(utile per la cassettiera)

### Pannello OSB/3 2500×1250×18 (il piano lamellare resta intero)

Taglio delle travi e dei pannelli | Fase 1
Modulo 1 – Tavolo base KVH 80×120 – manuale di lavorazione e montaggio | pag. 12

## 1. Rifila 10 mm a una testa di ogni barra per avere un'estremità a

90° pulita.

## 2. Le fasce da 1990 per prime: due sulla barra 1 (la seconda è quello che resta: misurala, deve essere ≥ 1990). Le fasce devono

## essere identiche: segna la prima e usala come campione. La fascia

anteriore FA si taglia a 1990 dal morale 80×80×4000.

## 3. Gambe (700) e traverse laterali (400): tagliale con un fermo

(battuta) sulla troncatrice, non misurandole una a una.

## 4. Controlla ogni taglio con la squadra su due facce. Una testata

storta apre il nodo.
5. Tieni un avanzo di ~100 mm: serve per la dima di foratura.

## 6. Marca subito il codice su ogni pezzo. Tecnomat taglia in

negozio (1° taglio gratis, poi 1 €).

## OSB: taglia prima la striscia da 560 su tutta la lunghezza, poi i pezzi. Lato liscio dei ripiani verso l'alto. I due rinforzi si

incollano uno sull'altro e formano 36 mm.

### Traversa LATERALE (L): testata e fianco

### Traversa BASSA ANTERIORE (ACi, ARi): testata e fianco

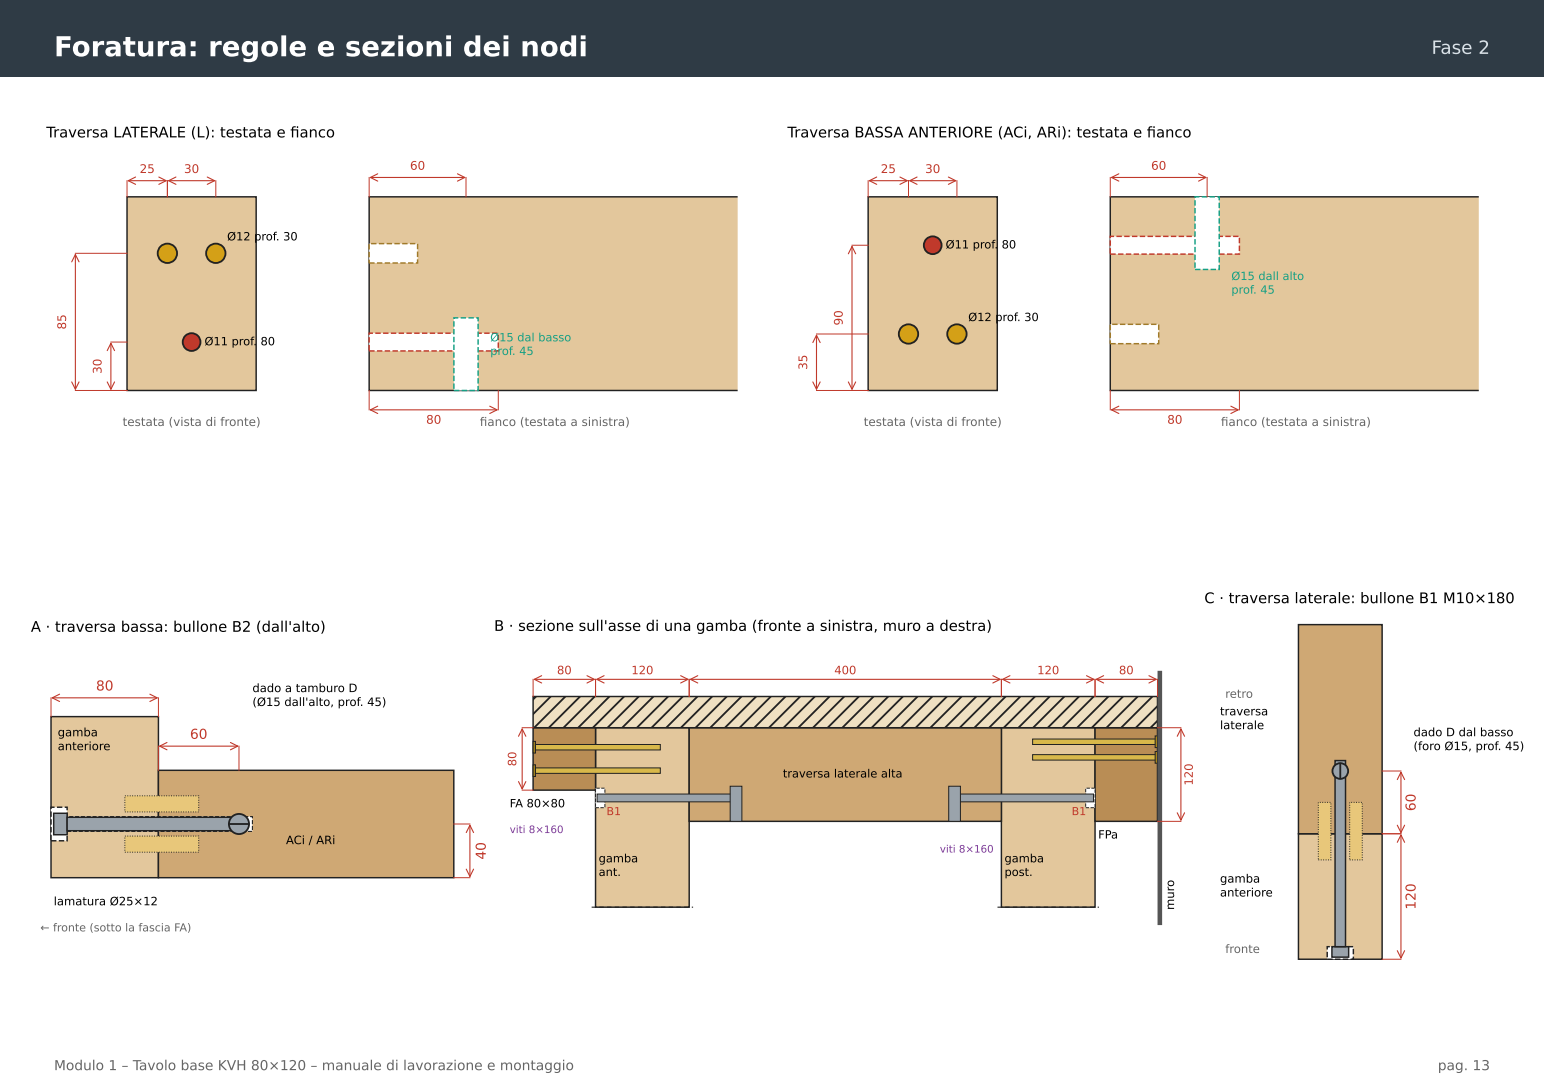
[picture p67: page 13]
Ø11 prof. 80; Ø12 prof. 30; Ø15 dal basso prof. 45; Ø15 dall alto prof. 45; lamatura Ø25×12; ACi / ARi; gamba anteriore; muro; FPa; gamba ant.; gamba post.; viti 8×160; fronte; retro; traversa laterale; Foratura: regole e sezioni dei nodi; Fase 2; Modulo 1 – Tavolo base KVH 80×120 – manuale di lavorazione e montaggio; pag. 13

testata (vista di fronte)

fianco (testata a sinistra)

C · traversa laterale: bullone B1 M10×180

A · traversa bassa: bullone B2 (dall'alto)

B · sezione sull'asse di una gamba (fronte a sinistra, muro a destra)

dado a tamburo D
(Ø15 dall'alto, prof. 45)

dado D dal basso
(foro Ø15, prof. 45)

traversa laterale alta

← fronte (sotto la fascia FA)

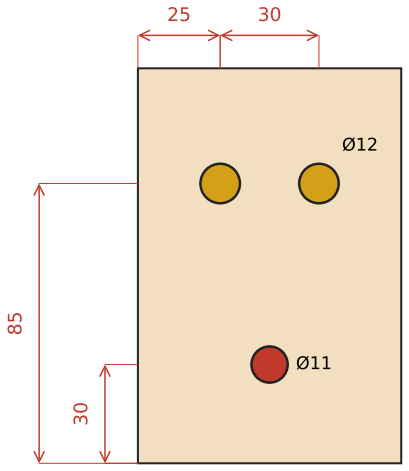
[picture p68: figure]

faccia di riferimento (BASSO)

## Dima: avanzo di KVH 80×120×100 forato al trapano a colonna

Foratura: la dima e come forare | Fase 2
Modulo 1 – Tavolo base KVH 80×120 – manuale di lavorazione e montaggio | pag. 14

### Come si costruisce Prendi un avanzo di trave lungo ~100 mm e fora i 3 fori passanti al trapano a colonna, perfettamente perpendicolari. Scrivi 'BASSO' sulla faccia corta di

riferimento.

### Come si usa Accosta la dima alla faccia da forare, a filo del bordo di riferimento, e

### stringila con un morsetto. La punta segue il foro della dima e resta dritta anche col trapano a mano. Nastro sulla punta alla profondità giusta

(profondità + 100 mm di dima).

### Orientamento - Traverse LATERALI (L) e relative facce delle gambe: dima con 'BASSO' verso

il basso del pezzo → bullone a 90 dalla testa, spine a 35.

### - Traverse BASSE ANTERIORI (ACi, ARi) e facce laterali delle gambe anteriori 1, 2, 3, 4: dima capovolta → bullone a 30 dalla testa della traversa, spine a

85; sulla gamba la dima va a filo del bordo ANTERIORE (asse a 40).

### Fasce (senza dima) - Fori Ø9 passanti nella fascia al trapano a colonna (o con guida), poi

svasatura per la testa della vite.

### - Il preforo Ø5 nella gamba si fa a fascia montata, passando dal foro Ø9 (fase

5): così i fori coincidono.

### Ordine dei fori in ogni pezzo 1. Fori Ø11 (bulloni) e Ø12 (spine) con la dima. 2. Lamature Ø25×12 con la

Forstner, centrate sul Ø11.
3. Nelle traverse: Ø15 per il dado a tamburo a 60 dalla testata, prof. 45; deve incontrare il Ø11.
4. Smussa leggermente gli spigoli di tutti i fori.

## Profondità

### - Ø11 nella testata della traversa: 80 mm - Ø12 spine: 30 nella traversa, 25 nella gamba - Ø15 dado a tamburo: 45 mm (60 nelle gambe post.) - Ø11 nelle gambe: passante (80 o 120)

### - Lamatura bulloni: Ø25, 12 mm - Fasce: Ø9 passante; preforo Ø5 prof. 80 nella gamba

### Foro Ø11 nella testata: punta lunga almeno 200 mm (100 di

dima + 80 + margine).

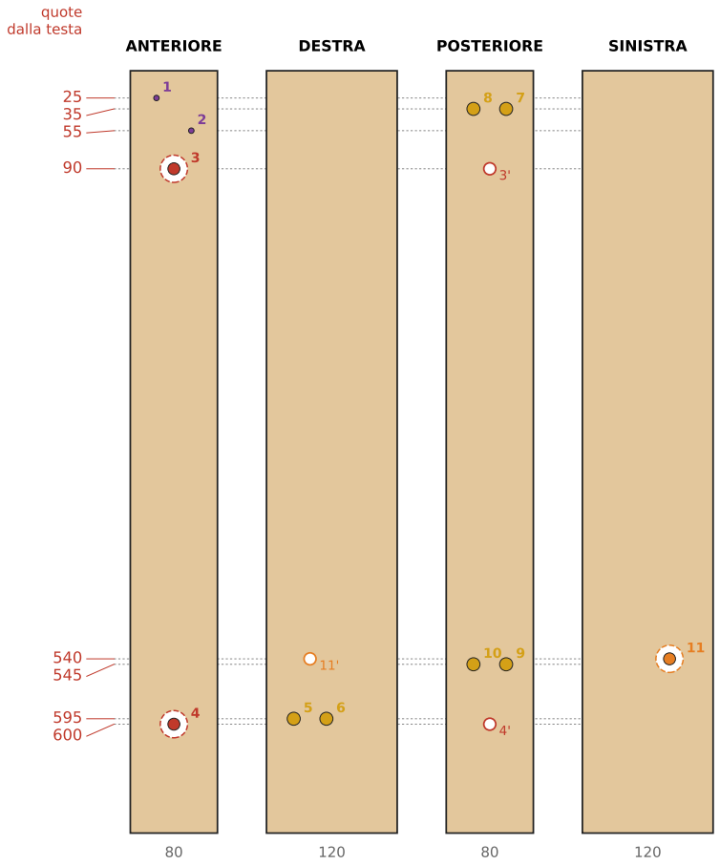
[picture p69: figure]
ANTERIORE; DESTRA; POSTERIORE; SINISTRA; quote dalla testa

TESTA

fronte ↓

PIEDE

12

n° | faccia | dalla testa | da sinistra | Ø | prof. | cosa
1 | anteriore | 25 | 24 | Ø5 | 80 | sup. preforo vite fascia V (Fascia ant. alta)
2 | anteriore | 55 | 56 | Ø5 | 80 | sup. preforo vite fascia V (Fascia ant. alta)
3 | anteriore | 90 | 40 | Ø11 | passante | sup. bullone laterale B1, lamatura Ø25×12
4 | anteriore | 600 | 40 | Ø11 | passante | inf. bullone laterale B1, lamatura Ø25×12
5 | destra | 595 | 25 | Ø12 | 25 | inf. spina S
6 | destra | 595 | 55 | Ø12 | 25 | inf. spina S
7 | posteriore | 35 | 55 | Ø12 | 25 | sup. spina S
8 | posteriore | 35 | 25 | Ø12 | 25 | sup. spina S
9 | posteriore | 545 | 55 | Ø12 | 25 | inf. spina S
10 | posteriore | 545 | 25 | Ø12 | 25 | inf. spina S
11 | sinistra | 540 | 80 | Ø11 | passante | inf. bullone traversa bassa B2, lamatura Ø25×12
12 | piede | — | centro | Ø14 | 25 | dado ragno I
Foratura gamba G1A – gamba 1 ant | Fase 2
Modulo 1 – Tavolo base KVH 80×120 – manuale di lavorazione e montaggio | pag. 15

Facce viste da fuori, testa in alto · cerchio pieno = ingresso · cerchio vuoto con apice = uscita del foro passante · tratteggio = lamatura Ø25 · viola = preforo Ø5 delle viti delle fasce (da fare a fascia montata) · i numeri rimandano alla tabella

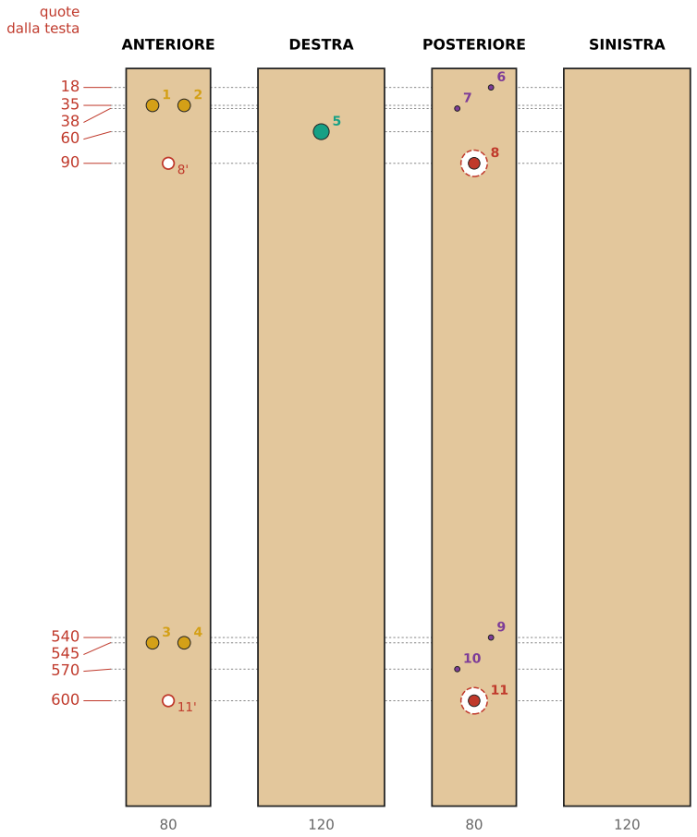
[picture p70: figure]
ANTERIORE; DESTRA; POSTERIORE; SINISTRA; quote dalla testa

TESTA

fronte ↓

PIEDE

12

13

n° | faccia | dalla testa | da sinistra | Ø | prof. | cosa
1 | anteriore | 35 | 25 | Ø12 | 25 | sup. spina S
2 | anteriore | 35 | 55 | Ø12 | 25 | sup. spina S
3 | anteriore | 545 | 25 | Ø12 | 25 | inf. spina S
4 | anteriore | 545 | 55 | Ø12 | 25 | inf. spina S
5 | destra | 60 | 60 | Ø15 | 60 | sup. predisp. alzatina: dado D
6 | posteriore | 18 | 56 | Ø5 | 80 | sup. preforo vite fascia V (Fascia post. alta)
7 | posteriore | 38 | 24 | Ø5 | 80 | sup. preforo vite fascia V (Fascia post. alta)
8 | posteriore | 90 | 40 | Ø11 | passante | sup. bullone laterale B1, lamatura Ø25×12
9 | posteriore | 540 | 56 | Ø5 | 80 | inf. preforo vite fascia V (Fascia post. bassa)
10 | posteriore | 570 | 24 | Ø5 | 80 | inf. preforo vite fascia V (Fascia post. bassa)
11 | posteriore | 600 | 40 | Ø11 | passante | inf. bullone laterale B1, lamatura Ø25×12
12 | testa | — | 40 da sx, 60 dal retroØ12 | | 75 | predisp. alzatina: foro barra – punta lunga
13 | piede | — | centro | Ø14 | 25 | dado ragno I
Foratura gamba G1P – gamba 1 post | Fase 2
Modulo 1 – Tavolo base KVH 80×120 – manuale di lavorazione e montaggio | pag. 16

Facce viste da fuori, testa in alto · cerchio pieno = ingresso · cerchio vuoto con apice = uscita del foro passante · tratteggio = lamatura Ø25 · viola = preforo Ø5 delle viti delle fasce (da fare a fascia montata) · i numeri rimandano alla tabella

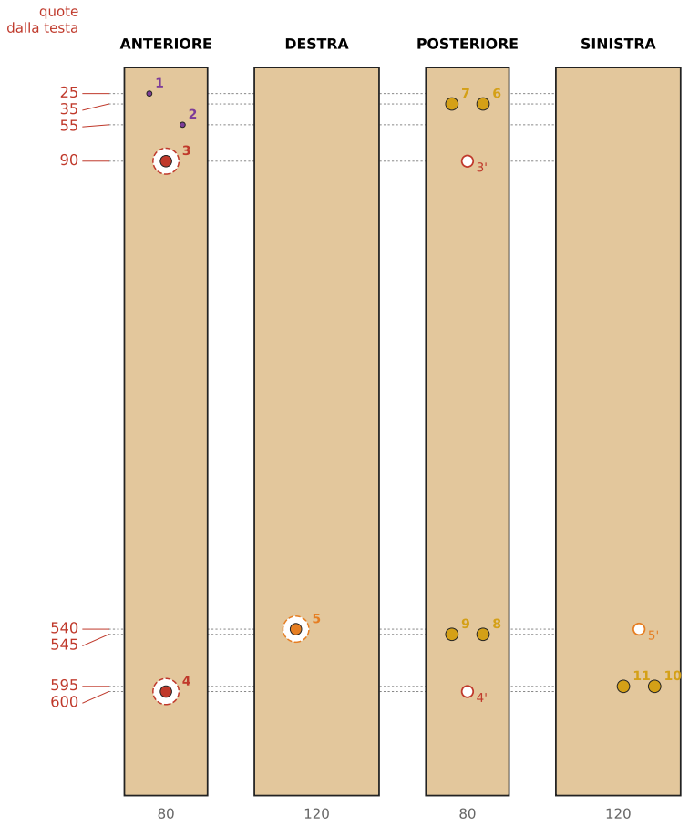
[picture p71: figure]
ANTERIORE; DESTRA; POSTERIORE; SINISTRA; quote dalla testa

TESTA

fronte ↓

PIEDE

12

n° | faccia | dalla testa | da sinistra | Ø | prof. | cosa
1 | anteriore | 25 | 24 | Ø5 | 80 | sup. preforo vite fascia V (Fascia ant. alta)
2 | anteriore | 55 | 56 | Ø5 | 80 | sup. preforo vite fascia V (Fascia ant. alta)
3 | anteriore | 90 | 40 | Ø11 | passante | sup. bullone laterale B1, lamatura Ø25×12
4 | anteriore | 600 | 40 | Ø11 | passante | inf. bullone laterale B1, lamatura Ø25×12
5 | destra | 540 | 40 | Ø11 | passante | inf. bullone traversa bassa B2, lamatura Ø25×12
6 | posteriore | 35 | 55 | Ø12 | 25 | sup. spina S
7 | posteriore | 35 | 25 | Ø12 | 25 | sup. spina S
8 | posteriore | 545 | 55 | Ø12 | 25 | inf. spina S
9 | posteriore | 545 | 25 | Ø12 | 25 | inf. spina S
10 | sinistra | 595 | 95 | Ø12 | 25 | inf. spina S
11 | sinistra | 595 | 65 | Ø12 | 25 | inf. spina S
12 | piede | — | centro | Ø14 | 25 | dado ragno I
Foratura gamba G2A – gamba 2 ant | Fase 2
Modulo 1 – Tavolo base KVH 80×120 – manuale di lavorazione e montaggio | pag. 17

Facce viste da fuori, testa in alto · cerchio pieno = ingresso · cerchio vuoto con apice = uscita del foro passante · tratteggio = lamatura Ø25 · viola = preforo Ø5 delle viti delle fasce (da fare a fascia montata) · i numeri rimandano alla tabella

TESTA

fronte ↓

PIEDE

12

13

n° | faccia | dalla testa | da sinistra | Ø | prof. | cosa
1 | anteriore | 35 | 25 | Ø12 | 25 | sup. spina S
2 | anteriore | 35 | 55 | Ø12 | 25 | sup. spina S
3 | anteriore | 545 | 25 | Ø12 | 25 | inf. spina S
4 | anteriore | 545 | 55 | Ø12 | 25 | inf. spina S
5 | destra | 60 | 60 | Ø15 | 60 | sup. predisp. alzatina: dado D
6 | posteriore | 18 | 56 | Ø5 | 80 | sup. preforo vite fascia V (Fascia post. alta)
7 | posteriore | 38 | 24 | Ø5 | 80 | sup. preforo vite fascia V (Fascia post. alta)
8 | posteriore | 90 | 40 | Ø11 | passante | sup. bullone laterale B1, lamatura Ø25×12
9 | posteriore | 540 | 56 | Ø5 | 80 | inf. preforo vite fascia V (Fascia post. bassa)
10 | posteriore | 570 | 24 | Ø5 | 80 | inf. preforo vite fascia V (Fascia post. bassa)
11 | posteriore | 600 | 40 | Ø11 | passante | inf. bullone laterale B1, lamatura Ø25×12
12 | testa | — | 40 da sx, 60 dal retroØ12 | | 75 | predisp. alzatina: foro barra – punta lunga
13 | piede | — | centro | Ø14 | 25 | dado ragno I
Foratura gamba G2P – gamba 2 post | Fase 2
Modulo 1 – Tavolo base KVH 80×120 – manuale di lavorazione e montaggio | pag. 18

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

TESTA

fronte ↓

PIEDE

12

n° | faccia | dalla testa | da sinistra | Ø | prof. | cosa
1 | anteriore | 25 | 24 | Ø5 | 80 | sup. preforo vite fascia V (Fascia ant. alta)
2 | anteriore | 55 | 56 | Ø5 | 80 | sup. preforo vite fascia V (Fascia ant. alta)
3 | anteriore | 90 | 40 | Ø11 | passante | sup. bullone laterale B1, lamatura Ø25×12
4 | anteriore | 600 | 40 | Ø11 | passante | inf. bullone laterale B1, lamatura Ø25×12
5 | destra | 595 | 25 | Ø12 | 25 | inf. spina S
6 | destra | 595 | 55 | Ø12 | 25 | inf. spina S
7 | posteriore | 35 | 55 | Ø12 | 25 | sup. spina S
8 | posteriore | 35 | 25 | Ø12 | 25 | sup. spina S
9 | posteriore | 545 | 55 | Ø12 | 25 | inf. spina S
10 | posteriore | 545 | 25 | Ø12 | 25 | inf. spina S
11 | sinistra | 540 | 80 | Ø11 | passante | inf. bullone traversa bassa B2, lamatura Ø25×12
12 | piede | — | centro | Ø14 | 25 | dado ragno I
Foratura gamba G3A – gamba 3 ant | Fase 2
Modulo 1 – Tavolo base KVH 80×120 – manuale di lavorazione e montaggio | pag. 19

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

TESTA

fronte ↓

PIEDE

12

13

n° | faccia | dalla testa | da sinistra | Ø | prof. | cosa
1 | anteriore | 35 | 25 | Ø12 | 25 | sup. spina S
2 | anteriore | 35 | 55 | Ø12 | 25 | sup. spina S
3 | anteriore | 545 | 25 | Ø12 | 25 | inf. spina S
4 | anteriore | 545 | 55 | Ø12 | 25 | inf. spina S
5 | destra | 60 | 60 | Ø15 | 60 | sup. predisp. alzatina: dado D
6 | posteriore | 18 | 56 | Ø5 | 80 | sup. preforo vite fascia V (Fascia post. alta)
7 | posteriore | 38 | 24 | Ø5 | 80 | sup. preforo vite fascia V (Fascia post. alta)
8 | posteriore | 90 | 40 | Ø11 | passante | sup. bullone laterale B1, lamatura Ø25×12
9 | posteriore | 540 | 56 | Ø5 | 80 | inf. preforo vite fascia V (Fascia post. bassa)
10 | posteriore | 570 | 24 | Ø5 | 80 | inf. preforo vite fascia V (Fascia post. bassa)
11 | posteriore | 600 | 40 | Ø11 | passante | inf. bullone laterale B1, lamatura Ø25×12
12 | testa | — | 40 da sx, 60 dal retroØ12 | | 75 | predisp. alzatina: foro barra – punta lunga
13 | piede | — | centro | Ø14 | 25 | dado ragno I
Foratura gamba G3P – gamba 3 post | Fase 2
Modulo 1 – Tavolo base KVH 80×120 – manuale di lavorazione e montaggio | pag. 20

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

TESTA

fronte ↓

PIEDE

12

n° | faccia | dalla testa | da sinistra | Ø | prof. | cosa
1 | anteriore | 25 | 24 | Ø5 | 80 | sup. preforo vite fascia V (Fascia ant. alta)
2 | anteriore | 55 | 56 | Ø5 | 80 | sup. preforo vite fascia V (Fascia ant. alta)
3 | anteriore | 90 | 40 | Ø11 | passante | sup. bullone laterale B1, lamatura Ø25×12
4 | anteriore | 600 | 40 | Ø11 | passante | inf. bullone laterale B1, lamatura Ø25×12
5 | destra | 540 | 40 | Ø11 | passante | inf. bullone traversa bassa B2, lamatura Ø25×12
6 | posteriore | 35 | 55 | Ø12 | 25 | sup. spina S
7 | posteriore | 35 | 25 | Ø12 | 25 | sup. spina S
8 | posteriore | 545 | 55 | Ø12 | 25 | inf. spina S
9 | posteriore | 545 | 25 | Ø12 | 25 | inf. spina S
10 | sinistra | 595 | 95 | Ø12 | 25 | inf. spina S
11 | sinistra | 595 | 65 | Ø12 | 25 | inf. spina S
12 | piede | — | centro | Ø14 | 25 | dado ragno I
Foratura gamba G4A – gamba 4 ant | Fase 2
Modulo 1 – Tavolo base KVH 80×120 – manuale di lavorazione e montaggio | pag. 21

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

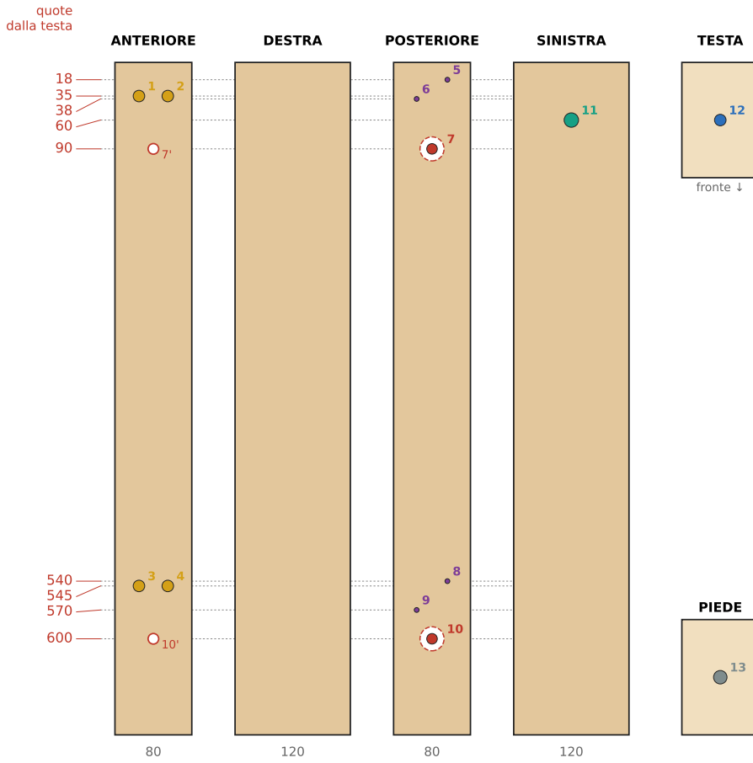
[picture p72: figure]
ANTERIORE; DESTRA; POSTERIORE; SINISTRA; TESTA; fronte ↓; PIEDE; quote dalla testa

2 | anteriore | 35 | 55 | Ø12 | 25 | sup. spina S
3 | anteriore | 545 | 25 | Ø12 | 25 | inf. spina S
4 | anteriore | 545 | 55 | Ø12 | 25 | inf. spina S
5 | posteriore | 18 | 56 | Ø5 | 80 | sup. preforo vite fascia V (Fascia post. alta)
6 | posteriore | 38 | 24 | Ø5 | 80 | sup. preforo vite fascia V (Fascia post. alta)
7 | posteriore | 90 | 40 | Ø11 | passante | sup. bullone laterale B1, lamatura Ø25×12
8 | posteriore | 540 | 56 | Ø5 | 80 | inf. preforo vite fascia V (Fascia post. bassa)
9 | posteriore | 570 | 24 | Ø5 | 80 | inf. preforo vite fascia V (Fascia post. bassa)
10 | posteriore | 600 | 40 | Ø11 | passante | inf. bullone laterale B1, lamatura Ø25×12
11 | sinistra | 60 | 60 | Ø15 | 60 | sup. predisp. alzatina: dado D
12 | testa | — | 40 da sx, 60 dal retroØ12 | | 75 | predisp. alzatina: foro barra – punta lunga
13 | piede | — | centro | Ø14 | 25 | dado ragno I
Foratura gamba G4P – gamba 4 post | Fase 2
Modulo 1 – Tavolo base KVH 80×120 – manuale di lavorazione e montaggio | pag. 22

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

codice | tipo | lungh. | entrambe le testate (quote dal filo superiore) | fori aggiuntivi
L1i | laterale | 400 | bullone −90 · spine −35 · dado dal BASSO | —
L1s | laterale | 400 | bullone −90 · spine −35 · dado dal BASSO | —
L2i | laterale | 400 | bullone −90 · spine −35 · dado dal BASSO | —
L2s | laterale | 400 | bullone −90 · spine −35 · dado dal BASSO | passacavi Ø35 a 200 dalla testata anteriore, 50 dalla testa (vedi sotto)
L3i | laterale | 400 | bullone −90 · spine −35 · dado dal BASSO | —
L3s | laterale | 400 | bullone −90 · spine −35 · dado dal BASSO | passacavi Ø35 a 200 dalla testata anteriore, 50 dalla testa (vedi sotto)
L4i | laterale | 400 | bullone −90 · spine −35 · dado dal BASSO | —
L4s | laterale | 400 | bullone −90 · spine −35 · dado dal BASSO | —
ACi | bassa anteriore | 500 | bullone −30 · spine −85 · dado dall'ALTO | —
ARi | bassa anteriore | 480 | bullone −30 · spine −85 · dado dall'ALTO | —

### L2s e L3s: foro passacavi Ø35 (Forstner), vista dal fianco

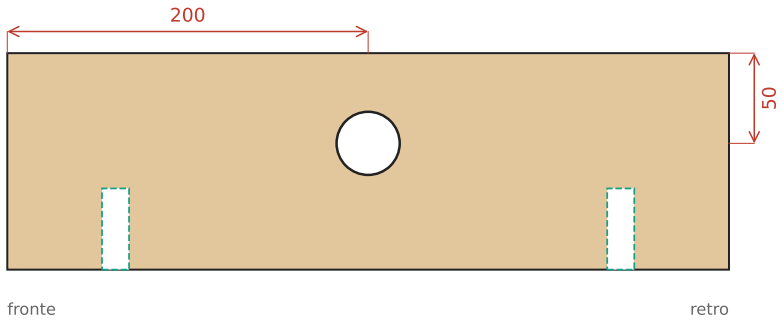
[picture p73: figure]
fronte; retro

60

250

Ø12 passante, in asse
lungo tutto il montante
(60 dal filo posteriore).

Fora 125 mm da ogni
testa con la punta lunga.

retro (muro)

### Montanti M1–M4 (80×120×250) per l'alzatina, vista dal fianco

Foratura traverse e montanti | Fase 2
Modulo 1 – Tavolo base KVH 80×120 – manuale di lavorazione e montaggio | pag. 23

60 | 280 | 60
| 400

25 15 15 25

vista dall'alto (faccia sinistra in basso)

## Laterale 400 mm – 6 pz: L1s, L1i, L2i, L3i, L4s, L4i

60 | 140 | 140 | 60

400

25 15 15 25

vista dall'alto (faccia sinistra in basso)

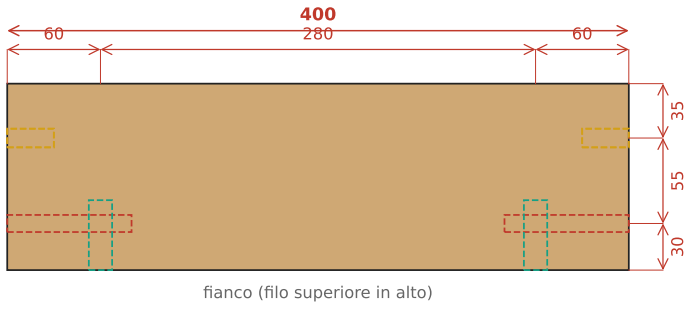
[picture p74: figure]
fianco (filo superiore in alto)

## Laterale 400 mm – 2 pz: L2s, L3s

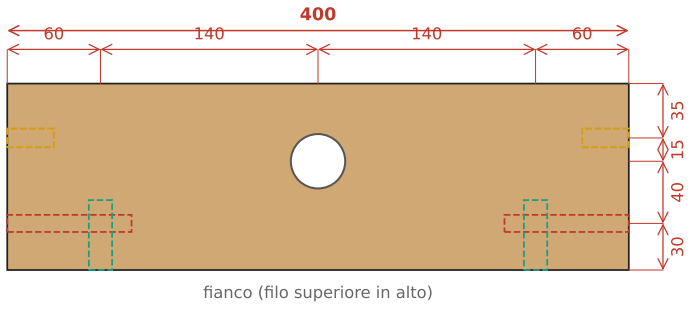
[picture p75: figure]
fianco (filo superiore in alto)

## Bassa anteriore 500 mm – 1 pz: ACi

Traverse quotate: lunghezze e fori | Fase 2

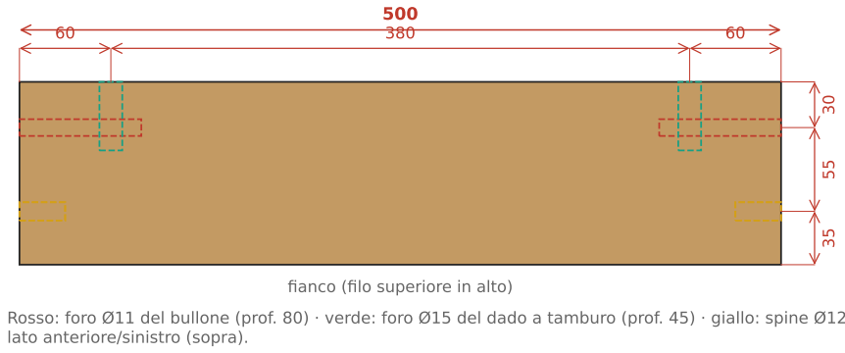
[picture p76: figure]
fianco (filo superiore in alto); lato anteriore/sinistro (sopra).
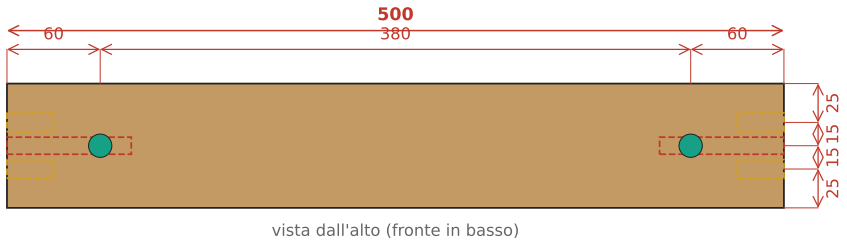
[picture p77: figure]
vista dall'alto (fronte in basso)

Modulo 1 – Tavolo base KVH 80×120 – manuale di lavorazione e montaggio | pag. 24

Rosso: foro Ø11 del bullone (prof. 80) · verde: foro Ø15 del dado a tamburo (prof. 45) · giallo: spine Ø12 (prof. 30) · grigio: passacavi Ø35 · blu scuro: fori Ø11 verticali della base piastre. Quote in mm dalla testata sinistra, dal basso (fianco) e dal

## Bassa anteriore 480 mm – 1 pz: ARi

Traverse quotate: lunghezze e fori | Fase 2

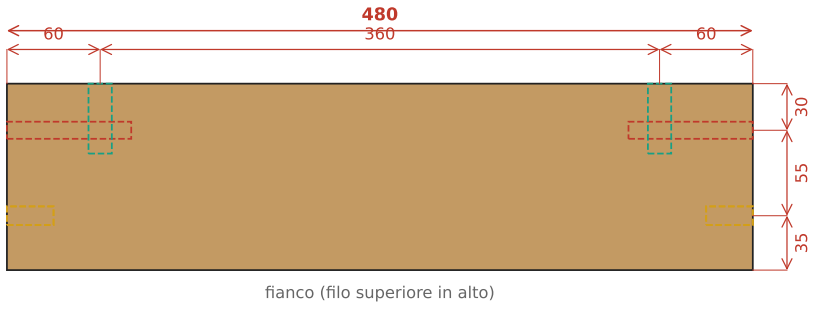
[picture p78: figure]
fianco (filo superiore in alto)
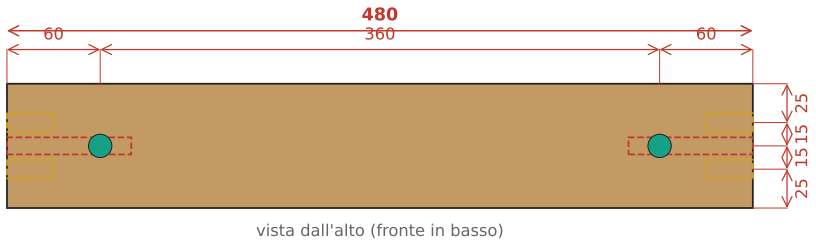
[picture p79: figure]
vista dall'alto (fronte in basso)

Modulo 1 – Tavolo base KVH 80×120 – manuale di lavorazione e montaggio | pag. 25

Rosso: foro Ø11 del bullone (prof. 80) · verde: foro Ø15 del dado a tamburo (prof. 45) · giallo: spine Ø12 (prof. 30) · grigio: passacavi Ø35 · blu scuro: fori Ø11 verticali della base piastre. Quote in mm dalla testata sinistra, dal basso (fianco) e dal

lato anteriore/sinistro (sopra).

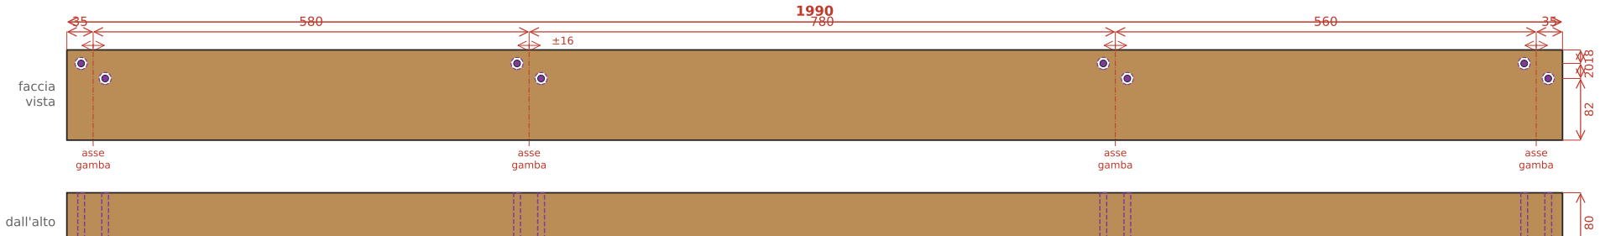
[picture p80: figure]
asse gamba; faccia vista; dall'alto

muro in alto · 1990 × 80 × 120

## FPa · fascia posteriore alta – di coltello, 80 × 120

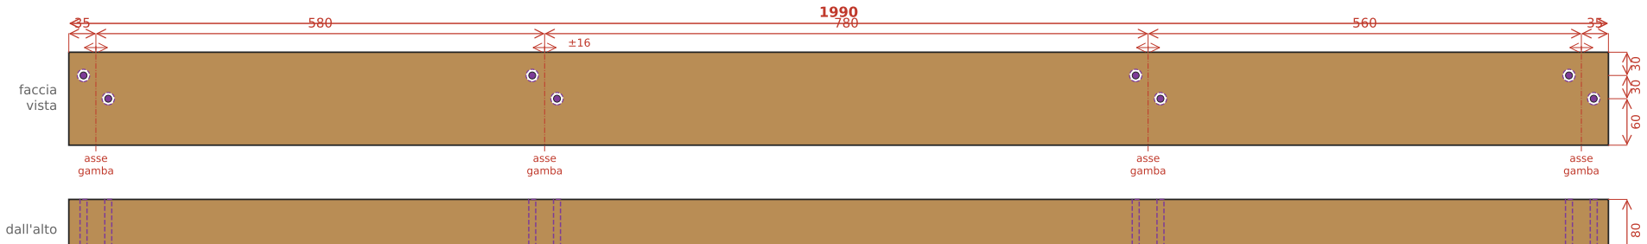
[picture p81: figure]
asse gamba; faccia vista; dall'alto

muro in alto · 1990 × 80 × 120

## FPb · fascia posteriore bassa – di coltello, 80 × 120

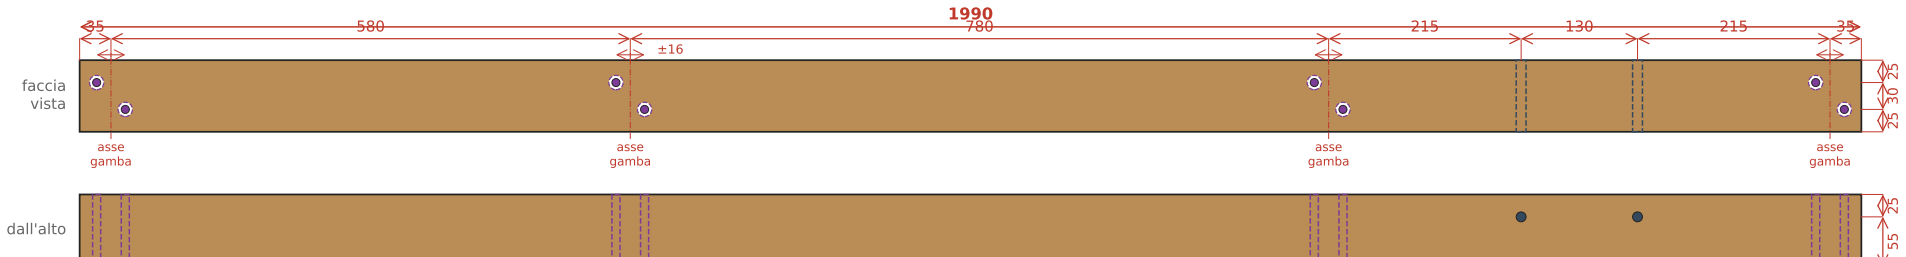
[picture p82: figure]
asse gamba; faccia vista; dall'alto

fronte in basso · 1990 × 80 × 80

## FA · fascia anteriore – morale di abete 80 × 80

Fasce a tutta lunghezza: misure e fori | Fase 2
Modulo 1 – Tavolo base KVH 80×120 – manuale di lavorazione e montaggio | pag. 26

Viola: fori Ø9 passanti per le viti 8×160, con svasatura per la testa · blu scuro: 2 fori Ø11 verticali della base piastre (fase 8). In ogni asse gamba 2 fori a ±16 mm dall'asse, alle quote dal basso indicate a destra. Quote sempre dalla testata lato G1 (sinistra guardando il tavolo dal fronte): sulle fasce posteriori, che si forano dal lato muro, segna le quote dalla stessa testata.

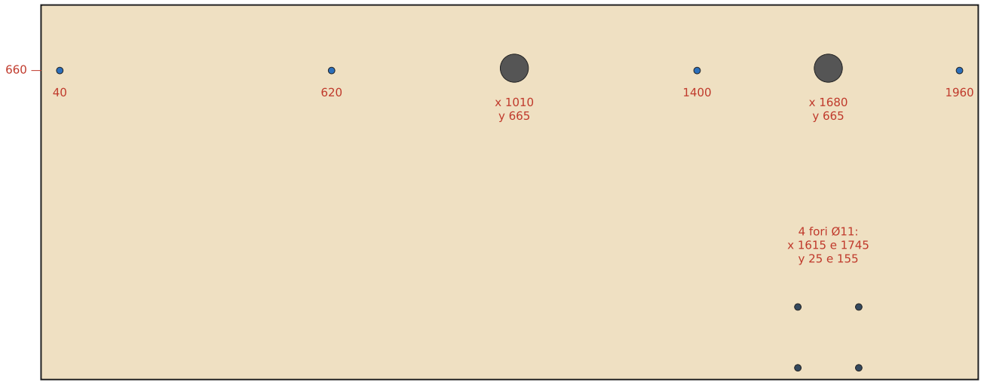
[picture p83: figure]
4 fori Ø11: x 1615 e 1745 y 25 e 155

FRONTE – quote da sinistra (x) e dal bordo anteriore (y)

## PIANO 2000×800×40 visto dall'alto

Foratura di piano, rinforzo e contropiastra | Fase 2
Modulo 1 – Tavolo base KVH 80×120 – manuale di lavorazione e montaggio | pag. 27

### Piano - 2 fori Ø60 passacavi con la sega a tazza: metà

da sopra e metà da sotto per non scheggiare.

### - 4 fori Ø11 della base piastre: falli in fase

8, usando la base d'acciaio come dima.
- 4 fori Ø12 (in blu) a 660 dal fronte, x = 40,

### 620, 1400, 1960: servono SOLO per l'alzatina

### (modulo 3). Non farli ora: si forano dal basso passando la punta nel foro della gamba, quando

monti l'alzatina.

### Rinforzo (OSB 2×18) e contropiastra 220×220×6 - Rinforzo 480×520: 2 fori Ø11 per le viti

### posteriori della base, in fase 8 insieme al

piano, dopo l'incollaggio.

# Levigatura e

finitura · Telai laterali | Fasi 3 e 4

Modulo 1

– Tavolo base KVH 80×120

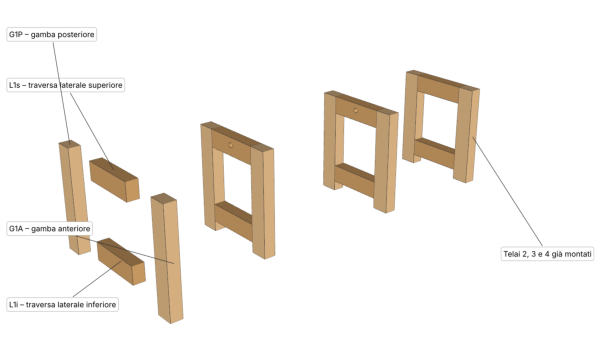
[picture p84: figure]

– manuale di lavorazione e montaggio | pag. 28

## Fase 3 · Levigatura e

## finitura (prima del montaggio)

## 1. Leviga tutti i pezzi con grana 120 e poi 180. Il KVH è

già piallato: basta togliere segni e matita.

## 2. Smussa tutti gli spigoli vivi di 2 mm (la fascia FA è

sotto le mani: smussala bene).

## 3. Olio o impregnante su gambe, traverse, fasce e

montanti; vernice trasparente sui ripiani OSB.

## 4. NON trattare testate delle traverse e zone da incollare

(sotto il piano dove va il rinforzo).

## 5. Il piano si tratta per ultimo, a tavolo montato, con

2

–3 mani.

## Fase 4 · Telai laterali (4 telai)

## Ogni telaio = gamba anteriore + gamba posteriore + traversa laterale alta e bassa (es. G1A + G1P + L1s +

L1i).

## 1. Predisposizione alzatina: in ogni gamba posteriore

in

## fila un dado a tamburo D nel foro Ø15 della faccia

## laterale (lato campata), con il foro

## filettato in

## verticale. Prova avvitando di qualche giro una barra M10 dal foro Ø12 in testa, poi s

filala.

## 2. Dadi a tamburo D nelle traverse L (dal basso), fessura verso la testata, foro

filettato allineato al Ø11.

## 3. Incolla le spine S nelle testate delle traverse (solo

lì), sporgenti 20 mm.

## 4. Gambe a terra, faccia interna in alto. In

## fila le

traverse sulle spine della gamba anteriore.

## 5. Bulloni B1 con rondella dalla faccia anteriore della

gamba anteriore, avvitali nel dado. Stringi poco.

## 6. Ripeti con la gamba posteriore (bulloni dalla faccia

posteriore).

## 7. Diagonali del telaio uguali entro 2 mm, poi stringi a fondo. I bulloni B1 restano coperti dalle fasce: stringili

bene adesso.
8. Pulisci subito la colla uscita.

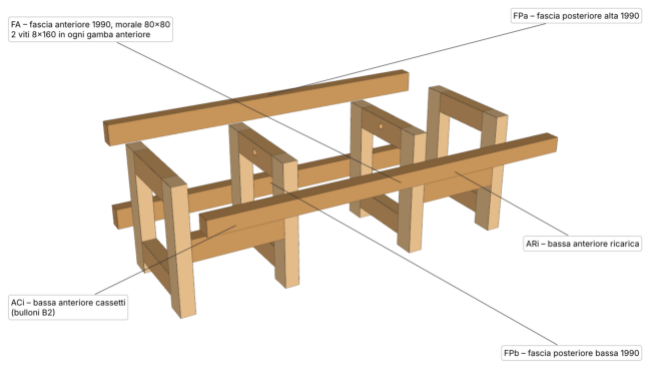
[picture p85: figure]

### B · sezione sull'asse di una gamba (fronte a sinistra, muro a destra)

Traverse basse anteriori e fasce | Fase 5

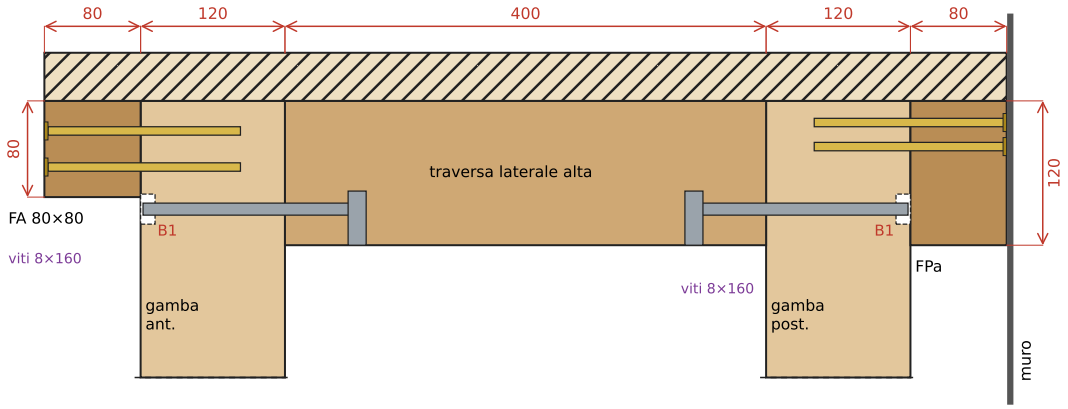
[picture p86: figure]
muro; FPa; traversa laterale alta; gamba ant.; gamba post.; viti 8×160

Modulo 1 – Tavolo base KVH 80×120 – manuale di lavorazione e montaggio | pag. 29

### Serve un aiutante. Tavolo in piedi, sul pavimento

piano, vicino al muro dove andrà.

### 1. Metti in piedi i 4 telai alle distanze giuste

(campate nette 500 · 700 · 480).

### 2. ACi tra G1A e G2A e ARi tra G3A e G4A: dadi D e spine come nei telai; bulloni B2 dalla faccia della gamba opposta alla traversa (G1A sinistra, G2A

destra, G3A sinistra, G4A destra).

### 3. Fascia posteriore bassa FPb: appoggiala sul retro delle gambe posteriori, a filo sotto (quota 70–190) e con 5 mm di margine ai due fianchi. Morsetti su

G1P e G4P.

### 4. Controlla la squadra in pianta (diagonali del rettangolo delle gambe uguali entro 3 mm) e che le

gambe siano a piombo.

### 5. Passando dai fori Ø9 della fascia, fai il preforo Ø5 profondo 80 nella gamba, poi avvita le viti V 8×160 fino a portare la testa a filo. Una gamba alla

volta, partendo dal centro (G2P, G3P).

### 6. Fascia posteriore alta FPa allo stesso modo, a

filo della testa delle gambe (quota 580–700).

### 7. Fascia anteriore FA (morale 80×80) davanti alle gambe anteriori, a filo della loro testa (quota

620–700): stesse viti e stesso procedimento.

### 8. Ricontrolla diagonali e piombo: con le fasce il

telaio è rigido.

vite 5×70

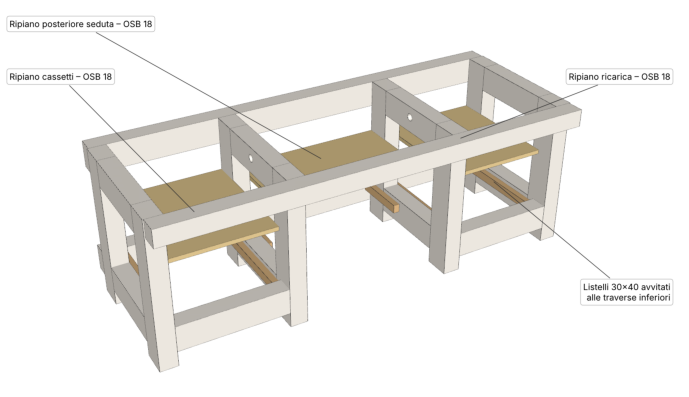
[picture p87: figure]

ripiano OSB 18

listello 30×40

traversa
laterale bassa

18

### Sezione: ripiano sul listello

Listelli e ripiani bassi | Fase 6
Modulo 1 – Tavolo base KVH 80×120 – manuale di lavorazione e montaggio | pag. 30

## Listelli reggiripiano 30×40 (6 pezzi): avvitati sulle facce interne di gambe e traverse laterali basse, con il filo superiore 18 mm sotto il filo della traversa (i

ripiani OSB restano a filo).

## - Campate cassetti e ricarica: listelli da 560, da dietro la traversa bassa anteriore (y 160) fino alla

fascia posteriore bassa (y 720).

## - Campata seduta: listelli da 260 contro la fascia

posteriore bassa.

## Viti 5×70, preforo Ø3, svasate, più colla. Listelli lunghi: 3 viti, una nella gamba anteriore, una al centro della traversa laterale e una nella gamba posteriore. Listelli corti: 2 viti (traversa e gamba

posteriore).

## NON avvitare entro 40 mm dalle testate delle traverse

(spine).

## Ripiani OSB 18: appoggiali sui listelli, lato liscio in

alto, e fissa ciascuno con 2 viti 4×35 per lato,

## preforo Ø3. Carico consigliato: fino a 30 kg sui ripiani da 500, fino a 15 kg su quello della seduta

(luce 700).

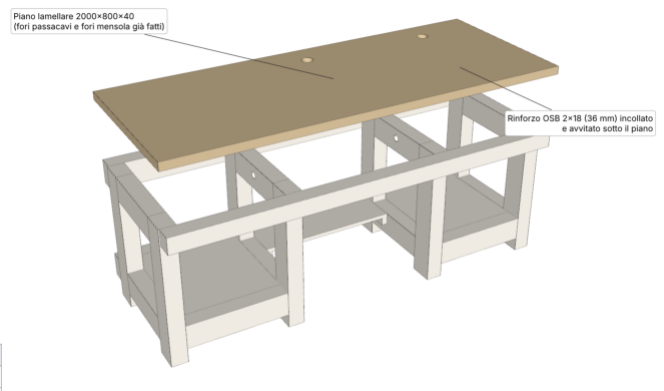
[picture p88: figure]

dove | posizione | n°
FA (faccia interna) | 2 per campata, a 100 dalle gambe | 6
FPa (faccia interna) | 2 per campata, a 100 dalle gambe | 6
L1s e L4s | 1 al centro, faccia interna | 2
L2s e L3s | 1 al centro, lato seduta | 2
totale | | 16

squadretta Q

fascia o
traversa alta

piano 40

vite 4,5×25 nell'asola
(il piano può muoversi)

### Sezione: squadretta di fissaggio del piano

Piano di lavoro | Fase 7
Modulo 1 – Tavolo base KVH 80×120 – manuale di lavorazione e montaggio | pag. 31

### 1. Fai i 2 fori passacavi Ø60. Incolla tra loro i due rinforzi OSB (36 mm) e poi incollali sotto il piano: x 1440–1920, y 80–600 (dietro la fascia FA, tra le traverse L3s e L4s). Colla su tutta la superficie + 12

### viti 5×60 dal basso, preforo Ø3, svasate, lontane almeno 40 mm dai fori della base piastre (x 1615 e 1745, y

155).

### 2. Appoggia il piano sul telaio: a filo della fascia FA

### davanti e della fascia FPa dietro, sporgenza 5 mm oltre

le fasce sui fianchi (a filo delle gambe).

### 3. Fissalo con le squadrette Q avvitate sulle facce

### interne di FA, FPa e delle traverse laterali alte: asola sotto il piano e vite 4,5×25 al centro dell'asola, così

il legno può muoversi con l'umidità.

### 4. Se monterai l'alzatina, le sue barre bloccheranno il

piano anche sul retro.

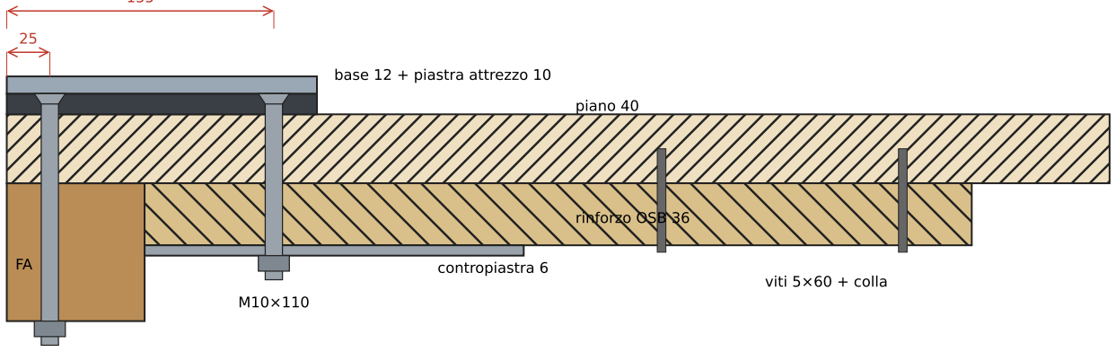
[picture p89: figure]
viti 5×60 + colla; piano 40; rinforzo OSB; contropiastra 6; base 12 + piastra attrezzo 10

M10×160

155

← fronte

### Sezione verticale in corrispondenza delle viti (x 1615 e 1745)

Zona ricarica: base delle piastre | Fase 8

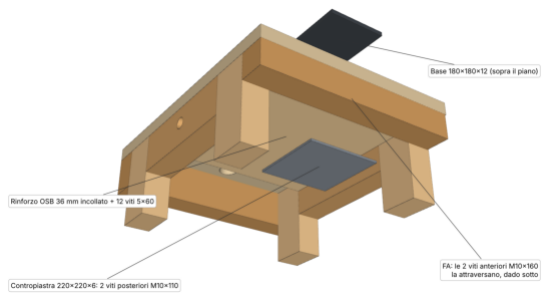
[picture p90: figure]

Modulo 1 – Tavolo base KVH 80×120 – manuale di lavorazione e montaggio | pag. 32

### 1. Appoggia la base d'acciaio sul piano: bordo anteriore a

filo del piano, centrata nella campata (centro a x = 1680,

cioè 240 mm dalla gamba destra). Bloccala con due morsetti.
2. Usa i suoi fori come dima: fora Ø11 verticale.

### – 2 fori ANTERIORI (25 dal fronte): attraversano piano e

fascia FA (120 mm). Punta lunga, fora metà da sopra; finisci da sotto se serve.

### – 2 fori POSTERIORI (155 dal fronte): attraversano piano e

rinforzo.

### 3. Da sotto, presenta la contropiastra sui 2 fori posteriori e

segnala/forala se non è già forata.

### 4. Viti TSPEI dall'alto (testa svasata a filo della base): – anteriori M10×160: rondella larga + dado autobloccante

sotto la fascia FA;

### – posteriori M10×110: dado autobloccante sotto la

contropiastra.

### 5. Stringi in croce. Le piastre degli attrezzi si bloccano poi

con le 2 manopole M12.

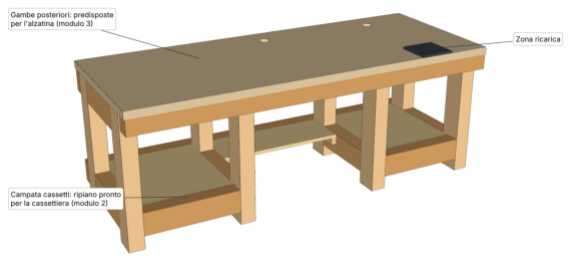
[picture p91: figure]

Gamba posteriore: dado D (visto di testa) e tassello nella fascia

Piedini, fissaggio a muro e predisposizioni | Fase 9

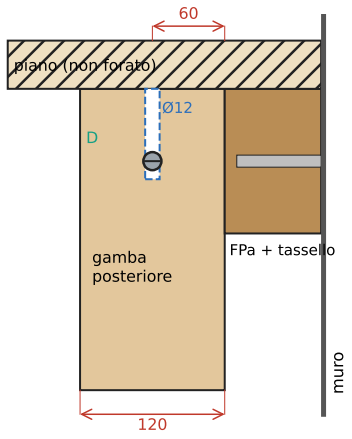
[picture p92: figure]
muro; piano (non forato); gamba posteriore; FPa + tassello

Modulo 1 – Tavolo base KVH 80×120 – manuale di lavorazione e montaggio | pag. 33

## Piedini

### 1. Inclina il tavolo, avvita i dadi ragno I nei fori sotto le

gambe e poi i piedini.
2. Porta il tavolo al muro e livellalo agendo sui piedini.

### Fissaggio a muro (indispensabile per le presse) 3. 4 tasselli per telai Ø10 L 160 attraverso la fascia posteriore alta FPa, alla sua mezzeria (quota 640): uno in ogni campata e uno in più nella campata ricarica, a ~150 mm dalle gambe (lontano dalle viti V). Fora Ø10 la fascia, segna

il muro, fora il muro con la punta adatta, inserisci e avvita.

### Se c'è il battiscopa, metti uno spessore dietro la fascia all'altezza dei tasselli. Su cartongesso: cerca i montanti

metallici o usa tasselli a espansione specifici.

### Predisposizioni per i moduli - Alzatina (modulo 3): in ogni gamba posteriore c'è il dado D

### inserito in fase 4 (dalla faccia laterale, lato campata) e il foro Ø12 in testa. I fori nel piano si fanno solo quando monti

l'alzatina. Conserva i montanti M1–M4.

### - Cassettiera (modulo 2): nessuna lavorazione. La campata

sinistra con il suo ripiano è già pronta.

Canaline, elettrico e controlli finali | Fase 10

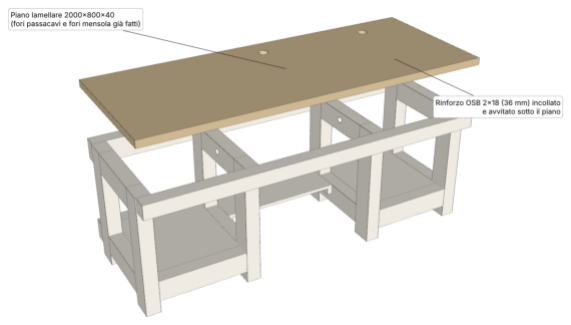
[picture p93: figure]

Modulo 1 – Tavolo base KVH 80×120 – manuale di lavorazione e montaggio | pag. 34

## Canaline e ciabatta 1. Una canalina per campata, sotto il piano, davanti alla fascia FPa: fascia y 615–715 dal fronte. Fissala sotto il

## piano con viti 4×25 (il piano è spesso 40: non usare viti

più lunghe).
2. La ciabatta va dentro la canalina della campata seduta, con l'interruttore raggiungibile dal fronte.

## 3. I cavi passano da una campata all'altra nei fori Ø35

delle traverse L2s e L3s (400 dal fronte del tavolo). Salgono sul piano dai passacavi Ø60.

## 4. Fascette e cavi alti, lontani dai cassetti della campata

sinistra.

## 5. Un solo cavo di alimentazione scende a muro, lungo la

gamba G2P o G3P.

## Controlli finali

## Il tavolo appoggia su 8 piedini senza dondolare (livella sul piano in due direzioni)

Telai: 20 nodi imbullonati stretti; dopo 2–3 settimane ristringi ACi e ARi (gli altri sono sotto le fasce)

## Fasce: 24 viti 8×160 a fondo, nessuna fessura tra fascia e gamba

## Nessun gioco spingendo il piano avanti-indietro e di lato

## Tasselli a muro serrati: prova con la pressa in calibratura, il tavolo non deve muoversi

## Base piastre: le 4 viti stringono, le manopole bloccano la piastra senza gioco

## Campata cassetti libera e ripiano fissato: pronta per la cassettiera (modulo 2)

## Finitura del piano: 2–3 mani di olio, leggera carteggiatura 240 tra una mano e l'altra
