abettarini/workbench/moduli/2-cassettiera/immagini/cas_installazione.png

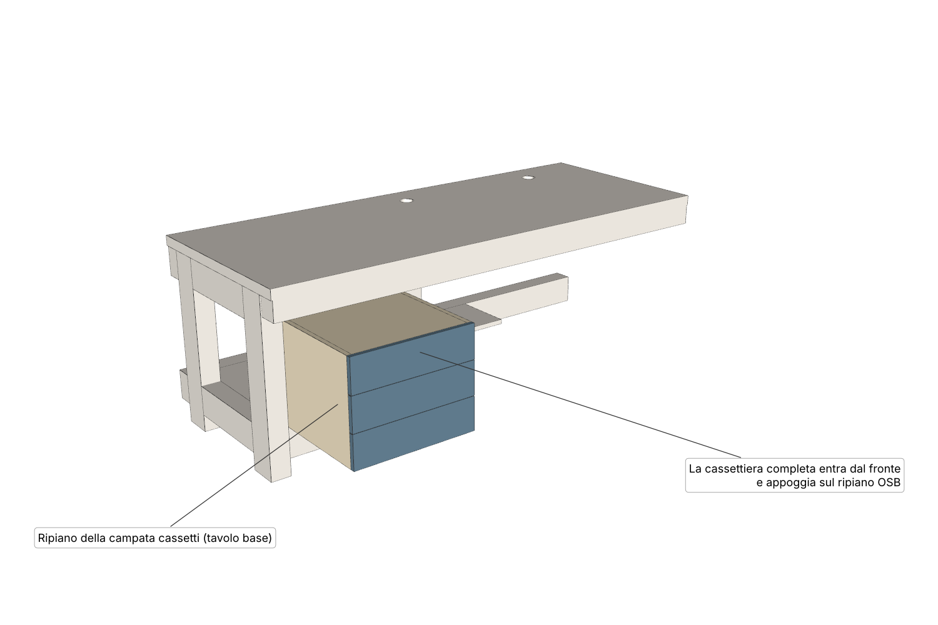
moduli/2-cassettiera/immagini/cas_installazione.png
