abettarini/workbench/moduli/3-alzatina/immagini/alz_installazione.png

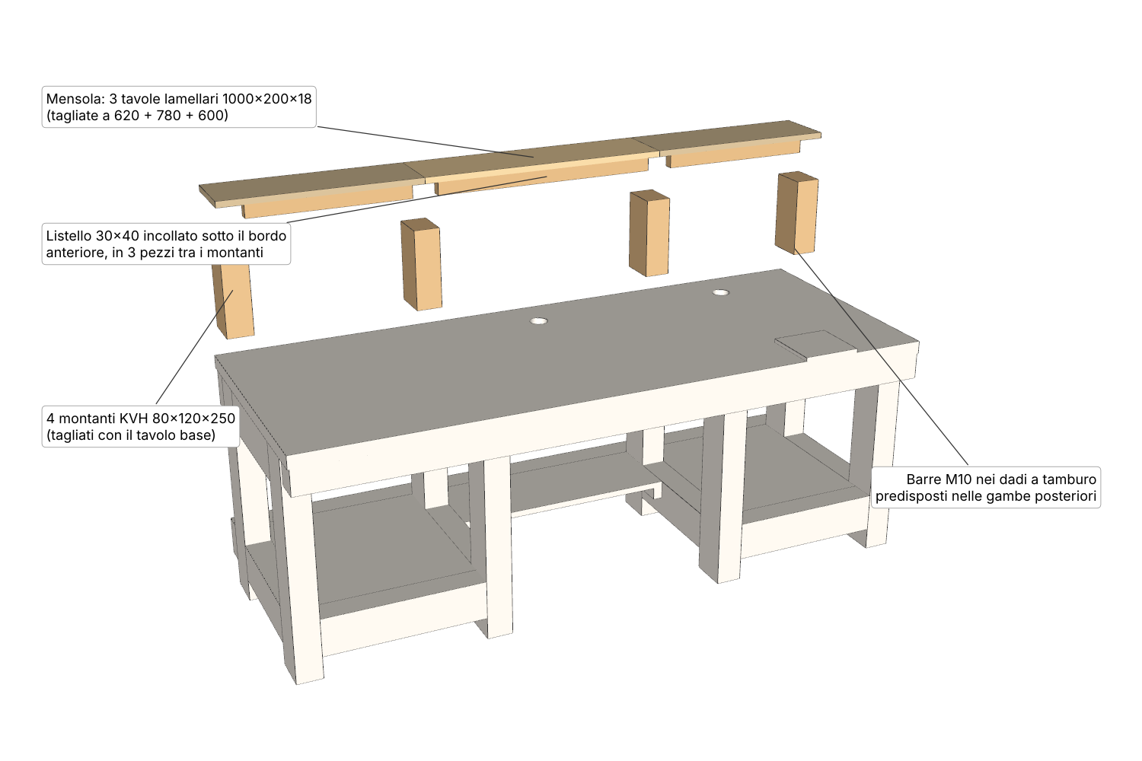
moduli/3-alzatina/immagini/alz_installazione.png
