abettarini/workbench/(commit log)

2026-10-18 Progetto tavolo da lavoro: versione travi KVH 80x120
    Manuale di lavorazione, tavole quotate, foglio costi, modello 3D STEP
    e script parametrici; versioni precedenti in archivio/.
    Claude-Session: https://claude.ai/code/session_014ifKLy6ksUu35M7vyqXshy
    [tavolo.step, tavolo_costi.xlsx, tavolo_kvh.step, tavolo_listelli.step]
2026-10-18 Progetto modulare: tavolo base, cassettiera e alzatina separati
    - Tavolo base: ripiani e rinforzo ricarica in OSB/3 18 al posto del secondo
    pannello lamellare; predisposizioni per l'alzatina nelle gambe posteriori
    - Cassettiera (fissa nella campata + cassetto appeso): manuale, costi, STEP
    - Alzatina: mensola in tavole OBI 800x200x14 con listello 30x40; manuale,
    costi, STEP
    - Fogli costi separati con confronto materiali per i ripiani
    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
    [alzatina.step, alzatina_costi.xlsx, cassettiera.step, cassettiera_costi.xlsx, tavolo_base.step, tavolo_base_costi.xlsx, tavolo_completo.step, tavolo_costi.xlsx]
2026-10-18 Tavolo base: traversa bassa anteriore cassetti (ACi) e viste ortogonali quotate
    - Aggiunta traversa ACi tra G1A e G2A: 5 barre KVH, fori derivati dal modello
    - Tavole e manuale: pianta telaio, prospetti, fianchi, pianta piano, schede
    quotate delle traverse
    - Quantità ferramenta e costi aggiornati
    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
    [alzatina.step, alzatina_costi.xlsx, cassettiera.step, cassettiera_costi.xlsx, tavolo_base.step, tavolo_base_costi.xlsx, tavolo_completo.step]
2026-10-18 Prezzi verificati su Tecnomat, OBI e Leroy Merlin; mensola in tavole 1000x200x18
    - Fogli costi con negozio, prezzo verificato e link per ogni voce
    - Nuovo confronto_prezzi_negozi.xlsx con giunzioni alternative
    - Alzatina: tavole lamellari 1000x200x18 Tecnomat al posto delle OBI 800x200x14
    - Cassettiera: pannelli pretagliati 1200x600 e fibra 3 mm, schema di taglio aggiornato
    - Manuali: nomi della ferramenta disponibile in negozio
    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
    [alzatina.step, alzatina_costi.xlsx, cassettiera_costi.xlsx, confronto_prezzi_negozi.xlsx, tavolo_base_costi.xlsx, tavolo_completo.step]
2026-10-18 Telaio a 4 telai laterali + 3 fasce a tutta lunghezza; manuale rifatto
    - Le traverse longitudinali posteriori (e la barra passante delle gambe
    centrali, che non si poteva stringere) sono sostituite da due fasce
    posteriori KVH 80x120 di coltello e da una fascia anteriore alta posata
    di piatto (620 mm liberi sotto), avvitate alle gambe con viti 8x160.
    - Gambe arretrate: traverse laterali 360, ARs eliminata, viti anteriori
    della base piastre M10x160 attraverso la fascia anteriore.
    - Dado della predisposizione alzatina inserito dalla faccia laterale.
    - Cassettiera senza cassetto appeso; mensola con listello in 3 pezzi.
    - Fori ricontrollati (228, nessuna collisione, minimo 7,5 mm di legno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
    [alzatina.step, alzatina_costi.xlsx, cassettiera.step, cassettiera_costi.xlsx, confronto_prezzi_negozi.xlsx, tavolo_base.step, tavolo_base_costi.xlsx, tavolo_completo.step]
2026-10-18 Fascia anteriore in morale 80x80 di coltello
    - La fascia anteriore passa da KVH 80x120 di piatto a morale di abete
    80x80 (Tecnomat): gambe anteriori arretrate di 80 come le posteriori,
    traverse laterali 400 invece di 360, 620 mm liberi sotto la fascia.
    - Viti 8x160 con sola svasatura anche davanti (niente lamatura e tappi).
    - KVH: 4 barre invece di 5. Tavolo base ~591 EUR.
    - Modello, fori (0 collisioni), taglio, costi, tavole e manuali rigenerati.
    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
    [alzatina.step, alzatina_costi.xlsx, cassettiera.step, cassettiera_costi.xlsx, confronto_prezzi_negozi.xlsx, tavolo_base.step, tavolo_base_costi.xlsx, tavolo_completo.step]
